bradgrantham/rocinante/notes.md

# User Buttons

For emulation apps, use the button scheme:
* Button 1 prints some help
* Button 2 kicks on the menu (and then buttons 1,2,3 navigate the menu?)
* Button 3 quits
