bradgrantham/rocinante/docs.md

User's guide
    can call newlib newlib-like functions, e.g.
        malloc, free
        printf, getchar, putchar
        fopen, fclose
    Window/Video calls
    Textport calls
    Audio calls
    Joystick calls
    Keyboard input calls
    System Buttons
Reference - generate?  Doxygen?
Device
    Ports
    Flashing
        USB DFU
        ST-Link SWD
        USART2 (over UART header)
