bradgrantham/rocinante/firmware/microray.md

Checkout https://github.com/jaggies/microray

PATH=$PATH:$PATH_TO_ARM_EABI_NONE_BIN_DIRECTORY TARGET=ARM jam

Uncomment the MICRORAY variables in Makefile and change to point to microray's source root
