bradgrantham/rocinante/(threads)

Thread 1 (2020-11-17):

Composite out is designed incorrectly

bradgrantham, 2020-11-17:
Transferred design from proto incorrectly.   Circuit has error - ground should be common and cap from signal to ground, but circuit as built has only cap from shell to ground.  Fixed in KiCAD at master 06fe009

Thread 5 (2022-10-19):

rowhandler should increment frame and reset row number when SetFuncs is called

bradgrantham, 2022-10-19:
Otherwise could have a race where interlaced is set to false but rows continue from 263 to 524, potentially confusing or crashing the line functions

Closed 2022-10-23.
