bradgrantham/rocinante/kicad/rocinante1/rocinante1.kicad_pcb

## KiCad design kicad/rocinante1/rocinante1.kicad_pcb (2020-11-17)

Schematic: rocinante1.sch, Rocinante, the noble steed

Parts:
BT1: 1225; BatteryHolder_Keystone_3001_1x12mm; Manufacturer PN 3001
C1, C2, C4, C6, C7, C8, C9, C10, C11, C12, C13, C14, C15, C16, C17, C21, C22, C23, C24, C28, C31, C32: 100nF; C_0603_1608Metric
C3, C5: 2.2µF; C_0603_1608Metric
C18, C19: 70nF; C_0603_1608Metric
C20: 1nF; C_0603_1608Metric
C25, C26, C27: 10µF; C_0603_1608Metric
C29, C30: 5.1pF; C_0603_1608Metric
C33, C35, C36: 1µF; C_0603_1608Metric
C34: 4.7µF; C_0603_1608Metric
D1: POWERLED; LED_0603_1608Metric; Manufacturer PN 150060GS75000
D2: DEBUGLED; LED_0603_1608Metric; Manufacturer PN 150060RS75000
D4: RGBLED1; LED_WS2812B_PLCC4_5.0x5.0mm_P3.2mm; Manufacturer PN WS2812B
D5: RGBLED2; LED_WS2812B_PLCC4_5.0x5.0mm_P3.2mm; Manufacturer PN WS2812B
D6: RGBLED3; LED_WS2812B_PLCC4_5.0x5.0mm_P3.2mm; Manufacturer PN WS2812B
F1: F_Small; Fuse_1210_3225Metric; Manufacturer PN 0ZCH0050FF2G
H1: HOLE0; MountingHole_3.2mm_M3_Pad_Via
H2: HOLE1; MountingHole_3.2mm_M3_Pad_Via
H3: HOLE2; MountingHole_3.2mm_M3_Pad_Via
H4: HOLE3; MountingHole_3.2mm_M3_Pad_Via
J1: ESP_01; PinSocket_2x04_P2.54mm_Vertical
J2: SWD; PinHeader_2x05_P1.27mm_Vertical_SMD; Manufacturer PN 20021521-00010C1LF
J3: COMPOSITE; CUI_RCJ-044; Manufacturer PN RCJ-044
J4: CTRL1; DSUB-9_Male_Horizontal_P2.77x2.84mm_EdgePinOffset7.70mm_Hou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; Manufacturer PN A-DS 09 A/KG-T2S
J5: CTRL2; DSUB-9_Male_Horizontal_P2.77x2.84mm_EdgePinOffset7.70mm_Hou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; Manufacturer PN A-DS 09 A/KG-T2S
J6: VGA; HD15-SN-24; Manufacturer PN HD15-SN-24
J7: AUDIOIN; Jack_3.5mm_CUI_SJ1-3535NG_Horizontal
J8: AUDIOOUT; Jack_3.5mm_CUI_SJ1-3535NG_Horizontal
J9: MOUSE; CUI_MD-60SM
J10: KEYBOARD; CUI_MD-60SM
J11: SERIAL; PinHeader_1x06_P2.54mm_Vertical
J12: SD_Card; 10067847-001RLF; Manufacturer PN 10067847-001RLF
J13: USBFS/POWER; USB_Micro-B_Amphenol_10104110_Horizontal; Manufacturer PN 10104110-0001LF
J14: I2S; PinHeader_1x06_P2.54mm_Vertical
J15: NEOPIXEL; PinHeader_1x03_P2.54mm_Vertical
J16: EXPHDR; PinHeader_2x05_P2.54mm_Vertical
Q1: Q_NPN_CBE; SOT-323_SC-70; Manufacturer PN MMBT3904WT1G
R1, R4: 220; R_0603_1608Metric
R2, R20, R28, R34: 2.2k; R_0603_1608Metric
R3: 6.8k; R_0603_1608Metric
R5: 215; R_0603_1608Metric
R6: 430; R_0603_1608Metric
R7: 860; R_0603_1608Metric
R8: 1.7k; R_0603_1608Metric
R9: 3.4k; R_0603_1608Metric
R10: 6.9k; R_0603_1608Metric
R11: 14k; R_0603_1608Metric
R12: 28K; R_0603_1608Metric
R13: 47; R_0603_1608Metric
R14, R15, R16, R21, R36, R37, R38, R39: 10K; R_0603_1608Metric
R17, R25, R31: 270; R_0603_1608Metric
R18, R26, R32: 560; R_0603_1608Metric
R19, R27, R33: 1100; R_0603_1608Metric
R22, R23, R43, R44, R45, R46, R47, R48: 20K; R_0603_1608Metric
R24, R29, R35: 4.3k; R_0603_1608Metric
R30: 8.6k; R_0603_1608Metric
R40, R41, R42: 150; R_0603_1608Metric
R49, R50, R51, R52, R53, R54: 68K; R_0603_1608Metric
R55, R56, R57, R58, R59, R60: 22; R_0603_1608Metric
R61, R62: 0; R_0603_1608Metric
SW1: RESET; SW_Push_1P1T_NO_6x6mm_H9.5mm; Manufacturer PN PTS645SM70SMTR92
SW2: USER1; SW_Push_1P1T_NO_6x6mm_H9.5mm; Manufacturer PN PTS645SM70SMTR92
SW3: USER2; SW_Push_1P1T_NO_6x6mm_H9.5mm; Manufacturer PN PTS645SM70SMTR92
SW4: USER3; SW_Push_1P1T_NO_6x6mm_H9.5mm; Manufacturer PN PTS645SM70SMTR92
SW5: BOOT0; SW_Push_1P1T_NO_6x6mm_H9.5mm; Manufacturer PN PTS645SM70SMTR92
TP1: CPST; TestPoint_Keystone_5015_Micro-Minature; Manufacturer PN RCW-0C
TP2: 5V; TestPoint_Keystone_5015_Micro-Minature; Manufacturer PN RCW-0C
TP3: 3V3; TestPoint_Keystone_5015_Micro-Minature; Manufacturer PN RCW-0C
TP4: GND; TestPoint_Keystone_5015_Micro-Minature; Manufacturer PN RCW-0C
TP5: KBDDATA; TestPoint_Keystone_5015_Micro-Minature; Manufacturer PN RCW-0C
TP6: KBDCLK; TestPoint_Keystone_5015_Micro-Minature; Manufacturer PN RCW-0C
U1: STM32H743IITx; LQFP-176_24x24mm_P0.5mm; Manufacturer PN STM32H743IIT6
U2: W9812G6KH-6; TSOP-II-54_22.2x10.16mm_P0.8mm; Manufacturer PN W9812G6KH-6
U3: LD1117S33TR_SOT223; SOT-223-3_TabPin2; Manufacturer PN LD1117S33TR
X1: ASE-14.31818MHz; Oscillator_SMD_Abracon_ASE-4Pin_3.2x2.5mm; Manufacturer PN ASEMB-14.31818MHZ-XY-T
Y1: 25MHz; Crystal_SMD_2016-4Pin_2.0x1.6mm; Manufacturer PN NX2016SA-25MHZ-EXS00A-CS11321

Connections:
ADC1_INP3: J7.T, U1.52
ADC1_INP5: J7.R, U1.57
ADC3_INP2: J4.9, U1.27
ADC3_INP3: J4.5, U1.25
ADC3_INP6: J5.9, U1.28
ADC3_INP7: J5.5, U1.26
AUDIO_OUT_L: C23.1, J8.T, R43.1
AUDIO_OUT_R: C24.1, J8.R, R44.1
BAT: BT1.1, C36.2, U1.6
BOOT: R21.1, SW5.2, U1.166
CLOCK0: R62.2, U1.29
CLOCK1: R61.2, U1.30
CV0: R12.2, U1.131
CV1: R11.2, U1.132
CV2: R10.2, U1.133
CV3: R9.2, U1.134
CV4: R8.2, U1.173
CV5: R7.2, U1.174
CV6: R6.2, U1.175
CV7: R5.2, U1.176
DAC1_OUT1: R22.2, U1.50
DAC1_OUT2: R23.2, U1.51
DEBUG: R4.1, U1.4
E1: J4.4, U1.86
E2: J5.4, U1.130
ESP_CH_EN: J1.4, U1.111
ESP_GPIO0: J1.5, R14.1
ESP_GPIO2: J1.3, R15.1
ESP_RST: J1.6, U1.110
ESP_RX: J1.7, U1.168
ESP_TX: J1.2, U1.11
EXPGPIO0: J16.8, U1.144
EXPGPIO1: J16.9, U1.145
EXPPWM: J16.7, U1.24
FIRE1: J4.6, U1.12
FIRE2: J5.6, U1.13
GND: BT1.2, C1.2, C2.2, C3.2, C4.2, C5.2, C6.2, C7.2, C8.2, C9.2, C10.2, C11.2, C12.2, C13.2, C14.2, C15.2, C16.2, C17.2, C18.2, C19.2, C20.2, C21.1, C22.1, C25.2, C26.2, C27.2, C28.1, C29.1, C30.1, C31.2, C32.1, C33.1, C34.2, C35.1, C36.1, D1.1 (K), D2.1 (K), D4.3, D5.3, D6.3, H1.1, H2.1, H3.1, H4.1, J1.1, J2.3, J2.5, J2.9, J4.0 (PAD), J5.0 (PAD), J6.0, J6.5, J6.6, J6.7, J6.8, J6.10, J7.S, J8.S, J9.3, J9.S1, J9.S2, J9.S3, J10.3, J10.S1, J10.S2, J10.S3, J11.6, J12.3, J12.6, J12.12, J12.13, J13.4, J13.5, J13.6, J14.6, J15.3, J16.6, R21.2, R40.1, R41.1, R42.1, R43.2, R44.2, SW1.1, TP4.1, U1.14, U1.22, U1.37, U1.48, U1.61, U1.71, U1.90, U1.102, U1.113, U1.126, U1.135, U1.148, U1.158, U2.6, U2.12, U2.28, U2.41, U2.46, U2.52, U2.54, U3.1, X1.2
I2C1_SCL: J6.15, U1.167
I2C1_SDA: J6.12, U1.165
I2S1_SDO: J14.3, U1.53
I2S_CK: J14.5, U1.154
I2S_SDI: J14.2, U1.152
I2S_WS: J14.4, U1.153
JOYSELECT: J4.7, J5.7, U1.58
KBD_CLK: J10.5, R38.1, R45.1, TP6.1
KBD_DATA: J10.1, R36.1, R46.1, TP5.1
KEYSELECT: J4.8, J5.8, U1.93
MOUSE_CLK: J9.5, R16.1, R47.1
MOUSE_DATA: J9.1, R37.1, R48.1
N1: J4.1, U1.83
N2: J5.1, U1.89
NRST: J2.10, SW1.2, U1.31
unnamed: C3.1, U1.125
unnamed: C5.1, U1.81
unnamed: C21.2, C23.2, R22.1
unnamed: C22.2, C24.2, R23.1
unnamed: C29.2, R61.1, Y1.1
unnamed: C30.2, R62.1, Y1.2
unnamed: D1.2 (A), R1.2
unnamed: D2.2 (A), R4.2
unnamed: D4.2, D5.4
unnamed: D4.4, Q1.1, R3.1
unnamed: D5.2, D6.4
unnamed: D6.2, J15.2
unnamed: F1.1, J13.1
unnamed: J12.1, R56.1
unnamed: J12.2, R57.1
unnamed: J12.5, R58.1
unnamed: J12.7, R59.1
unnamed: J12.8, R60.1
unnamed: J12.9, R55.1
unnamed: Q1.2, R2.1
unnamed: R39.1, X1.1
RGBLED_PWM: Q1.3, U1.5, U1.101
S1: J4.2, U1.84
S2: J5.2, U1.128
SDIO_CD: J12.10, U1.106
SDIO_CLK: R52.1, R58.2, U1.150
SDIO_CMD: R51.1, R57.2, U1.151
SDIO_D0: R53.1, R59.2, U1.94
SDIO_D1: R54.1, R60.2, U1.95
SDIO_D2: R49.1, R55.2, U1.161
SDIO_D3: R50.1, R56.2, U1.162
SDIO_WP: J12.11, U1.56
SDRAM_A0: U1.16, U2.23
SDRAM_A1: U1.17, U2.24
SDRAM_A2: U1.18, U2.25
SDRAM_A3: U1.19, U2.26
SDRAM_A4: U1.20, U2.29
SDRAM_A5: U1.21, U2.30
SDRAM_A6: U1.60, U2.31
SDRAM_A7: U1.63, U2.32
SDRAM_A8: U1.64, U2.33
SDRAM_A9: U1.65, U2.34
SDRAM_A10: U1.66, U2.22
SDRAM_A11: U1.67, U2.35
SDRAM_BA0: U1.108, U2.20
SDRAM_BA1: U1.109, U2.21
SDRAM_D0: U1.104, U2.2
SDRAM_D1: U1.105, U2.4
SDRAM_D2: U1.142, U2.5
SDRAM_D3: U1.143, U2.7
SDRAM_D4: U1.68, U2.8
SDRAM_D5: U1.69, U2.10
SDRAM_D6: U1.70, U2.11
SDRAM_D7: U1.73, U2.13
SDRAM_D8: U1.74, U2.42
SDRAM_D9: U1.75, U2.44
SDRAM_D10: U1.76, U2.45
SDRAM_D11: U1.77, U2.47
SDRAM_D12: U1.78, U2.48
SDRAM_D13: U1.96, U2.50
SDRAM_D14: U1.97, U2.51
SDRAM_D15: U1.98, U2.53
SDRAM_NBL0: U1.169, U2.15
SDRAM_NBL1: U1.170, U2.39
SDRAM_SDCKE0: U1.43, U2.37
SDRAM_SDCLK: U1.112, U2.38
SDRAM_SDNCAS: U1.160, U2.17
SDRAM_SDNE0: U1.44, U2.19
SDRAM_SDNRAS: U1.59, U2.18
SDRAM_SDNWE: U1.46, U2.16
SPI6_MISO: J16.1, U1.155
SPI6_MOSI: J16.4, U1.157
SPI6_NSS_SWCTL: J16.5, U1.107
SPI6_SCK: J16.3, U1.156
SWCLK: J2.4, U1.137
SWDIO: J2.2, U1.124
TIM1_CH2: U1.120, X1.3
TIM2_CH1: R45.2, U1.119, U1.138
TIM3_CH2: R47.2, U1.92, U1.163
TIM4_CH1: J6.13, U1.100
TIM5_CH2: J6.14, U1.88
USART1_RX: R46.2, U1.121, U1.164
USART2_CTS: J11.5, U1.40
USART2_RTS: U1.41
USART2_RX: J11.3, U1.47
USART2_TX: J11.2, U1.42
USART3_RX: R48.2, U1.79, U1.80
USB_FS_D_N: J13.2, U1.122
USB_FS_D_P: J13.3, U1.123
USER1: SW2.2, U1.1
USER2: SW3.2, U1.2
USER3: SW4.2, U1.3
VDD: C1.1, C2.1, C4.1, C6.1, C7.1, C8.1, C9.1, C10.1, C11.1, C12.1, C13.1, C14.1, C15.1, C16.1, C17.1, C18.1, C19.1, C25.1, C27.1, C31.1, C34.1, C35.2, J1.8, J2.1, J12.4, J14.1, J16.2, R1.1, R2.2, R13.1, R14.2, R15.2, R39.2, R49.2, R50.2, R51.2, R52.2, R53.2, R54.2, SW2.1, SW3.1, SW4.1, SW5.1, TP3.1, U1.15, U1.23, U1.36, U1.39, U1.49, U1.62, U1.72, U1.82, U1.91, U1.103, U1.114, U1.127, U1.136, U1.149, U1.159, U1.171, U1.172, U2.1, U2.3, U2.9, U2.14, U2.27, U2.43, U2.49, U3.2, X1.4
VGA_B0: R24.2, U1.32
VGA_B1: R20.2, U1.33
VGA_B2: R19.2, U1.34
VGA_B3: R18.2, U1.35
VGA_B4: R17.2, U1.54
VGA_BLUE: J6.3, R17.1, R18.1, R19.1, R20.1, R24.1, R40.2
VGA_G0: R30.2, U1.55
VGA_G1: R29.2, U1.115
VGA_G2: R28.2, U1.116
VGA_G3: R27.2, U1.117
VGA_G4: R26.2, U1.118
VGA_G5: R25.2, U1.139
VGA_GREEN: J6.2, R25.1, R26.1, R27.1, R28.1, R29.1, R30.1, R41.2
VGA_ID0: J6.11
VGA_ID2: J6.4
VGA_R0: R35.2, U1.140
VGA_R1: R34.2, U1.141
VGA_R2: R33.2, U1.8
VGA_R3: R32.2, U1.9
VGA_R4: R31.2, U1.10
VGA_RED: J6.1, R31.1, R32.1, R33.1, R34.1, R35.1, R42.2
VREFP: C32.2, C33.2, R13.2, U1.38
W1: J4.3, U1.85
W2: J5.3, U1.129

Notes on the sheet:
Compatible with Jim’s SPI header on pins 1-6
VDD DECOUPLING

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
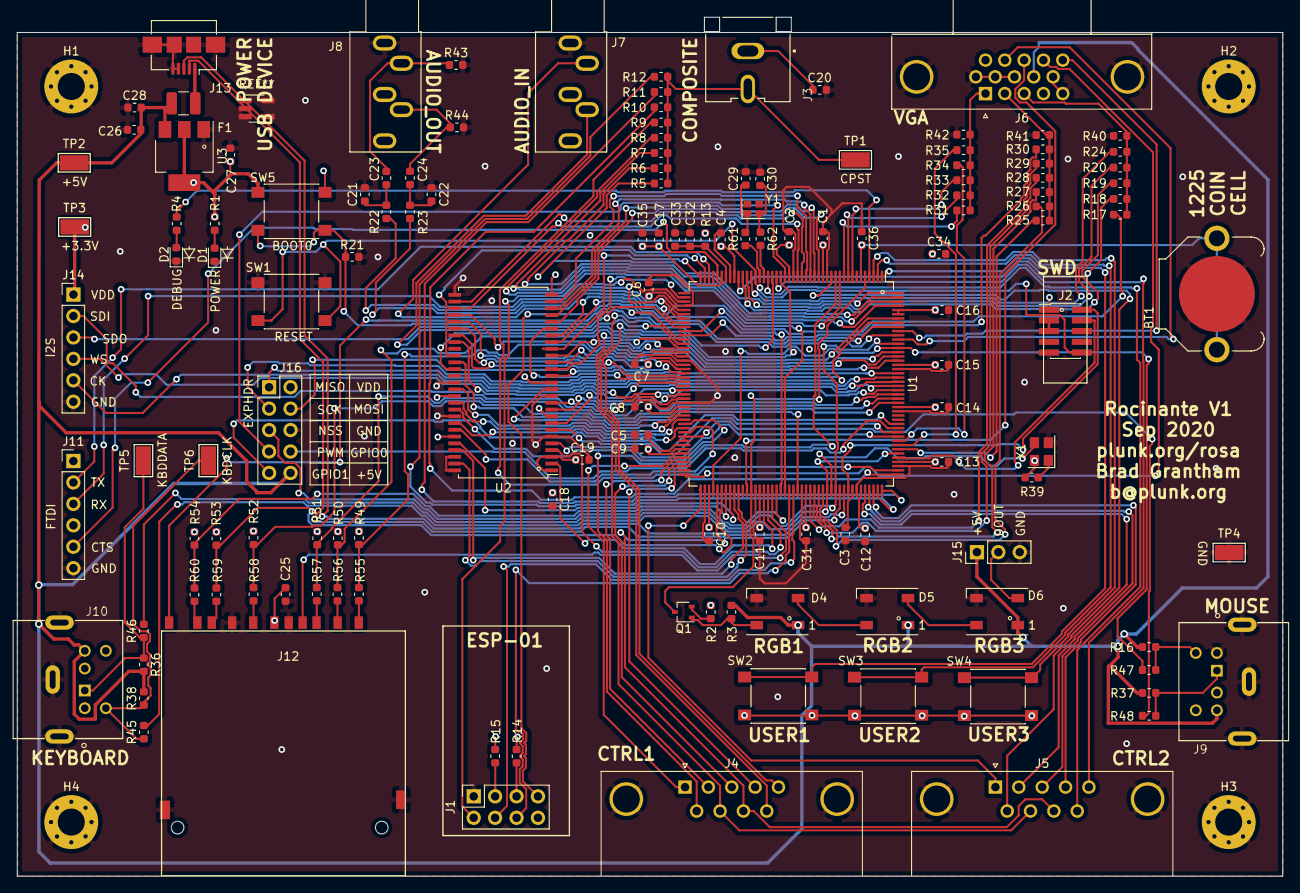
[picture p5: board rocinante1.kicad_pcb from above]

Board: 4 copper layers, 150.0 x 101.8 mm, 142 parts (0 on the bottom side), 169 nets.
