bradgrantham/rocinante/software/rocinante_rev1.ioc

Mcu.UserName=STM32H743IITx
PA11.Signal=USB_OTG_FS_DM
PA12.Signal=USB_OTG_FS_DP
PA2.Signal=USART2_TX
PA3.Signal=USART2_RX
PA4.Signal=COMP_DAC11_group
PA5.Signal=COMP_DAC12_group
PA9.Signal=S_TIM1_CH2
PB14.Signal=SDMMC2_D0
PB15.Signal=SDMMC2_D1
PB9.Signal=UART4_TX
PC0.Signal=GPIO_Output
PC1.Signal=GPIO_Output
PC10.Signal=GPIO_Output
PC11.Signal=GPIO_Output
PC12.Signal=GPIO_Output
PC13.Signal=GPIO_Output
PC2_C.Signal=GPIO_Output
PC3_C.Signal=GPIO_Output
PC4.Signal=GPIO_Output
PC5.Signal=GPIO_Output
PC6.Signal=GPIO_Output
PC7.Signal=GPIO_Output
PC8.Signal=GPIO_Output
PC9.Signal=GPIO_Output
PD0.Signal=FMC_D2_DA2
PD1.Signal=FMC_D3_DA3
PD10.Signal=FMC_D15_DA15
PD12.Signal=S_TIM4_CH1
PD14.Signal=FMC_D0_DA0
PD15.Signal=FMC_D1_DA1
PD6.Signal=SDMMC2_CK
PD7.Signal=SDMMC2_CMD
PD8.Signal=FMC_D13_DA13
PD9.Signal=FMC_D14_DA14
PE0.Signal=FMC_NBL0
PE1.Signal=FMC_NBL1
PE10.Signal=FMC_D7_DA7
PE11.Signal=FMC_D8_DA8
PE12.Signal=FMC_D9_DA9
PE13.Signal=FMC_D10_DA10
PE14.Signal=FMC_D11_DA11
PE15.Signal=FMC_D12_DA12
PE2.Signal=SPI4_SCK
PE3.GPIO_Label=USER2
PE3.Signal=GPIO_Input
PE4.GPIO_Label=USER3
PE4.Signal=GPIO_Input
PE5.GPIO_Label=DEBUG_LED
PE5.Signal=GPIO_Output
PE6.GPIO_Label=RGBLED_SPI
PE6.Signal=SPI4_MOSI
PE7.Signal=FMC_D4_DA4
PE8.Signal=FMC_D5_DA5
PE9.Signal=FMC_D6_DA6
PF0.Signal=FMC_A0
PF1.Signal=FMC_A1
PF11.Signal=FMC_SDNRAS
PF12.Signal=FMC_A6
PF13.Signal=FMC_A7
PF14.Signal=FMC_A8
PF15.Signal=FMC_A9
PF2.Signal=FMC_A2
PF3.Signal=FMC_A3
PF4.Signal=FMC_A4
PF5.Signal=FMC_A5
PG0.Signal=FMC_A10
PG1.Signal=FMC_A11
PG15.Signal=FMC_SDNCAS
PG2.GPIO_Label=SDIO_CD
PG2.Signal=GPIO_Input
PG4.Signal=FMC_A14_BA0
PG5.Signal=FMC_A15_BA1
PG6.GPIO_Label=ESP_RESET
PG6.Signal=GPIO_Output
PG7.GPIO_Label=ESP_EN
PG7.Signal=GPIO_Output
PG8.Signal=FMC_SDCLK
PH11.Signal=S_TIM5_CH2
PH2.Signal=FMC_SDCKE0
PH3.Signal=FMC_SDNE0
PH5.Signal=FMC_SDNWE
PI0.Signal=GPIO_Output
PI1.Signal=GPIO_Output
PI2.Signal=GPIO_Output
PI3.Signal=GPIO_Output
PI4.Signal=GPIO_Output
PI5.Signal=GPIO_Output
PI6.Signal=GPIO_Output
PI7.Signal=GPIO_Output
PI9.Signal=UART4_RX
