bradgrantham/rocinante/firmware/main.c

#include <stdio.h>
#include <stdlib.h>
#include <string.h>
#include <ctype.h>
#include <math.h>

#undef USE_PS2KBD

#include <stm32f7xx_hal.h>

#include "ff.h"

#include "defs.h"
#include "delay.h"
#include "leds.h"
#include "byte_queue.h"
#include "gpio_helpers.h"
#include "utility.h"
#include "crc7.h"
#include "logprintf.h"

#include "monitor_queue.h"
#include "console_queue.h"
#include "uart.h"
#include "sd_spi.h"
#include "keyboard.h"
#include "reset_button.h"

// System APIs
#include "videomode.h"
#include "graphics.h"
#include "textport.h"
#include "rocinante.h"
#include "segment_utility.h"

// System driver internal definitions
#include "videomodeinternal.h"

static int gDumpKeyboardData = 0;

char gMonitorCommandBuffer[80];
unsigned char gMonitorCommandBufferLength = 0;

#define IOBOARD_FIRMWARE_VERSION_STRING XSTR(IOBOARD_FIRMWARE_VERSION)

volatile unsigned char gSerialInputToMonitor = 1;

void panic_worse()
{
    LED_set_panic(1);
    for(;;);
}

void panic(void)
{
    static int entered = 0;

    LED_set_panic(1);

    int pin = 0;
    for(;;) {
        if(!entered) {
            // SERIAL_flush() can itself panic(), so stop reentry here
            entered = 1;
            SERIAL_flush();
            entered = 0;
        }

        LED_set_panic(pin);
        pin = pin ? 0 : 1;
        delay_ms(100);
    }
}

void FPU_IRQHandler(void)
{
    SERIAL_enqueue_one_char('f');
    SERIAL_enqueue_one_char('p');
    SERIAL_enqueue_one_char('u');
    SERIAL_enqueue_one_char('\n');
    SERIAL_flush();
    panic();
}

//----------------------------------------------------------------------------
// System Initialization Goop

typedef struct {
    float CPUMHz;      // not used; computed
    uint32_t HSOSC;       // not used; fixed
    uint32_t PLL_M;
    uint32_t PLL_N;
    uint32_t PLL_P;
    uint32_t DMA_TIM_CLOCKS;
    uint32_t HCLK_DIV;
    uint32_t APB1_DIV;
    uint32_t APB2_DIV;
    float colorburstClock;      // not used; computed
    float error;      // not used; computed
} ClockConfiguration;

unsigned int whichConfig = 0;
static const ClockConfiguration clockConfigs[] =
{
    // Base mode we know works?
    // { 229.14, 8000000, 7, 401, 2, 8, RCC_SYSCLK_DIV1, RCC_HCLK_DIV8, RCC_HCLK_DIV4, 3.580357, 0.000227 }, // can't get SD to lock in
    { 200.50, 8000000, 4, 401, 4, 7, RCC_SYSCLK_DIV1, RCC_HCLK_DIV8, RCC_HCLK_DIV4, 3.580357, 0.000227},
    // {200.47, 16000000, 17, 426, 2, 14, RCC_SYSCLK_DIV1, RCC_HCLK_DIV4, RCC_HCLK_DIV2, 3.579832, 0.000080}, // 415 normal mode

    // PLL_OUTPUT MHz, HSE, PLLM, PLLN, PLLP, TIM_CLOCKS, HCLK_DIV, APB1_DIV, APB2_DIV, actual color clock MHz, error
    { 286.40, 8000000, 5, 358, 2, 10, RCC_SYSCLK_DIV1, RCC_HCLK_DIV8, RCC_HCLK_DIV4, 3.580000, 0.000127 },
    { 200.50, 8000000, 2, 401, 8, 14, RCC_SYSCLK_DIV1, RCC_HCLK_DIV4, RCC_HCLK_DIV2, 3.580357, 0.000227 },
    { 200.50, 8000000, 4, 401, 4, 14, RCC_SYSCLK_DIV1, RCC_HCLK_DIV4, RCC_HCLK_DIV2, 3.580357, 0.000227 },
    { 200.50, 8000000, 8, 401, 2, 14, RCC_SYSCLK_DIV1, RCC_HCLK_DIV4, RCC_HCLK_DIV2, 3.580357, 0.000227 },
    { 229.14, 8000000, 7, 401, 2, 8, RCC_SYSCLK_DIV1, RCC_HCLK_DIV8, RCC_HCLK_DIV4, 3.580357, 0.000227 },
    { 229.00, 8000000, 2, 229, 4, 8, RCC_SYSCLK_DIV1, RCC_HCLK_DIV8, RCC_HCLK_DIV4, 3.578125, -0.000397 },
    { 229.00, 8000000, 4, 229, 2, 8, RCC_SYSCLK_DIV1, RCC_HCLK_DIV8, RCC_HCLK_DIV4, 3.578125, -0.000397 },
    { 186.22, 8000000, 3, 419, 6, 13, RCC_SYSCLK_DIV1, RCC_HCLK_DIV4, RCC_HCLK_DIV2, 3.581197, 0.000461 },
    { 186.22, 8000000, 9, 419, 2, 13, RCC_SYSCLK_DIV1, RCC_HCLK_DIV4, RCC_HCLK_DIV2, 3.581197, 0.000461 },
    { 257.60, 8000000, 5, 322, 2, 9, RCC_SYSCLK_DIV1, RCC_HCLK_DIV8, RCC_HCLK_DIV4, 3.577778, -0.000494 },
    { 200.57, 8000000, 7, 351, 2, 14, RCC_SYSCLK_DIV1, RCC_HCLK_DIV4, RCC_HCLK_DIV2, 3.581633, 0.000583 },
    { 186.00, 8000000, 2, 93, 2, 13, RCC_SYSCLK_DIV1, RCC_HCLK_DIV4, RCC_HCLK_DIV2, 3.576923, -0.000732 },
    { 186.00, 8000000, 2, 186, 4, 13, RCC_SYSCLK_DIV1, RCC_HCLK_DIV4, RCC_HCLK_DIV2, 3.576923, -0.000732 },
    { 186.00, 8000000, 2, 279, 6, 13, RCC_SYSCLK_DIV1, RCC_HCLK_DIV4, RCC_HCLK_DIV2, 3.576923, -0.000732 },
    { 186.00, 8000000, 2, 372, 8, 13, RCC_SYSCLK_DIV1, RCC_HCLK_DIV4, RCC_HCLK_DIV2, 3.576923, -0.000732 },
    { 186.00, 8000000, 3, 279, 4, 13, RCC_SYSCLK_DIV1, RCC_HCLK_DIV4, RCC_HCLK_DIV2, 3.576923, -0.000732 },
    { 186.00, 8000000, 4, 186, 2, 13, RCC_SYSCLK_DIV1, RCC_HCLK_DIV4, RCC_HCLK_DIV2, 3.576923, -0.000732 },
    { 186.00, 8000000, 4, 372, 4, 13, RCC_SYSCLK_DIV1, RCC_HCLK_DIV4, RCC_HCLK_DIV2, 3.576923, -0.000732 },
    { 186.00, 8000000, 6, 279, 2, 13, RCC_SYSCLK_DIV1, RCC_HCLK_DIV4, RCC_HCLK_DIV2, 3.576923, -0.000732 },
    { 186.00, 8000000, 8, 372, 2, 13, RCC_SYSCLK_DIV1, RCC_HCLK_DIV4, RCC_HCLK_DIV2, 3.576923, -0.000732 },
    { 186.29, 8000000, 7, 326, 2, 13, RCC_SYSCLK_DIV1, RCC_HCLK_DIV4, RCC_HCLK_DIV2, 3.582418, 0.000802 },
    { 200.67, 8000000, 2, 301, 6, 14, RCC_SYSCLK_DIV1, RCC_HCLK_DIV4, RCC_HCLK_DIV2, 3.583333, 0.001058 },
    { 229.33, 8000000, 3, 172, 2, 8, RCC_SYSCLK_DIV1, RCC_HCLK_DIV8, RCC_HCLK_DIV4, 3.583333, 0.001058 },
    { 286.67, 8000000, 3, 215, 2, 10, RCC_SYSCLK_DIV1, RCC_HCLK_DIV8, RCC_HCLK_DIV4, 3.583333, 0.001058 },
    { 200.67, 8000000, 3, 301, 4, 14, RCC_SYSCLK_DIV1, RCC_HCLK_DIV4, RCC_HCLK_DIV2, 3.583333, 0.001058 },
    { 229.33, 8000000, 3, 344, 4, 8, RCC_SYSCLK_DIV1, RCC_HCLK_DIV8, RCC_HCLK_DIV4, 3.583333, 0.001058 },
    { 258.00, 8000000, 3, 387, 4, 9, RCC_SYSCLK_DIV1, RCC_HCLK_DIV8, RCC_HCLK_DIV4, 3.583333, 0.001058 },
    { 286.67, 8000000, 3, 430, 4, 10, RCC_SYSCLK_DIV1, RCC_HCLK_DIV8, RCC_HCLK_DIV4, 3.583333, 0.001058 },
    { 200.67, 8000000, 6, 301, 2, 14, RCC_SYSCLK_DIV1, RCC_HCLK_DIV4, RCC_HCLK_DIV2, 3.583333, 0.001058 },
    { 229.33, 8000000, 6, 344, 2, 8, RCC_SYSCLK_DIV1, RCC_HCLK_DIV8, RCC_HCLK_DIV4, 3.583333, 0.001058 },
    { 258.00, 8000000, 6, 387, 2, 9, RCC_SYSCLK_DIV1, RCC_HCLK_DIV8, RCC_HCLK_DIV4, 3.583333, 0.001058 },
    { 286.67, 8000000, 6, 430, 2, 10, RCC_SYSCLK_DIV1, RCC_HCLK_DIV8, RCC_HCLK_DIV4, 3.583333, 0.001058 },
    { 258.00, 8000000, 2, 129, 2, 9, RCC_SYSCLK_DIV1, RCC_HCLK_DIV8, RCC_HCLK_DIV4, 3.583333, 0.001058 },
    { 258.00, 8000000, 2, 258, 4, 9, RCC_SYSCLK_DIV1, RCC_HCLK_DIV8, RCC_HCLK_DIV4, 3.583333, 0.001058 },
    { 229.33, 8000000, 2, 344, 6, 8, RCC_SYSCLK_DIV1, RCC_HCLK_DIV8, RCC_HCLK_DIV4, 3.583333, 0.001058 },
    { 258.00, 8000000, 2, 387, 6, 9, RCC_SYSCLK_DIV1, RCC_HCLK_DIV8, RCC_HCLK_DIV4, 3.583333, 0.001058 },
    { 286.67, 8000000, 2, 430, 6, 10, RCC_SYSCLK_DIV1, RCC_HCLK_DIV8, RCC_HCLK_DIV4, 3.583333, 0.001058 },
    { 258.00, 8000000, 4, 258, 2, 9, RCC_SYSCLK_DIV1, RCC_HCLK_DIV8, RCC_HCLK_DIV4, 3.583333, 0.001058 },
    { 286.00, 8000000, 2, 143, 2, 10, RCC_SYSCLK_DIV1, RCC_HCLK_DIV8, RCC_HCLK_DIV4, 3.575000, -0.001270 },
    { 286.00, 8000000, 2, 286, 4, 10, RCC_SYSCLK_DIV1, RCC_HCLK_DIV8, RCC_HCLK_DIV4, 3.575000, -0.001270 },
    { 286.00, 8000000, 2, 429, 6, 10, RCC_SYSCLK_DIV1, RCC_HCLK_DIV8, RCC_HCLK_DIV4, 3.575000, -0.001270 },
    { 286.00, 8000000, 3, 429, 4, 10, RCC_SYSCLK_DIV1, RCC_HCLK_DIV8, RCC_HCLK_DIV4, 3.575000, -0.001270 },
    { 286.00, 8000000, 4, 286, 2, 10, RCC_SYSCLK_DIV1, RCC_HCLK_DIV8, RCC_HCLK_DIV4, 3.575000, -0.001270 },
    { 228.80, 8000000, 5, 286, 2, 8, RCC_SYSCLK_DIV1, RCC_HCLK_DIV8, RCC_HCLK_DIV4, 3.575000, -0.001270 },
    { 286.00, 8000000, 6, 429, 2, 10, RCC_SYSCLK_DIV1, RCC_HCLK_DIV8, RCC_HCLK_DIV4, 3.575000, -0.001270 },
    { 186.40, 8000000, 5, 233, 2, 13, RCC_SYSCLK_DIV1, RCC_HCLK_DIV4, RCC_HCLK_DIV2, 3.584615, 0.001416 },
    { 257.33, 8000000, 2, 386, 6, 9, RCC_SYSCLK_DIV1, RCC_HCLK_DIV8, RCC_HCLK_DIV4, 3.574074, -0.001528 },
    { 257.33, 8000000, 3, 193, 2, 9, RCC_SYSCLK_DIV1, RCC_HCLK_DIV8, RCC_HCLK_DIV4, 3.574074, -0.001528 },
    { 257.33, 8000000, 3, 386, 4, 9, RCC_SYSCLK_DIV1, RCC_HCLK_DIV8, RCC_HCLK_DIV4, 3.574074, -0.001528 },
    { 257.33, 8000000, 6, 386, 2, 9, RCC_SYSCLK_DIV1, RCC_HCLK_DIV8, RCC_HCLK_DIV4, 3.574074, -0.001528 },
    { 200.80, 8000000, 5, 251, 2, 14, RCC_SYSCLK_DIV1, RCC_HCLK_DIV4, RCC_HCLK_DIV2, 3.585714, 0.001723 },
    { 228.67, 8000000, 2, 343, 6, 8, RCC_SYSCLK_DIV1, RCC_HCLK_DIV8, RCC_HCLK_DIV4, 3.572917, -0.001852 },
    { 228.67, 8000000, 3, 343, 4, 8, RCC_SYSCLK_DIV1, RCC_HCLK_DIV8, RCC_HCLK_DIV4, 3.572917, -0.001852 },
    { 228.67, 8000000, 6, 343, 2, 8, RCC_SYSCLK_DIV1, RCC_HCLK_DIV8, RCC_HCLK_DIV4, 3.572917, -0.001852 },
    { 185.78, 8000000, 3, 418, 6, 13, RCC_SYSCLK_DIV1, RCC_HCLK_DIV4, RCC_HCLK_DIV2, 3.572650, -0.001926 },
    { 185.78, 8000000, 9, 418, 2, 13, RCC_SYSCLK_DIV1, RCC_HCLK_DIV4, RCC_HCLK_DIV2, 3.572650, -0.001926 },
    { 186.50, 8000000, 2, 373, 8, 13, RCC_SYSCLK_DIV1, RCC_HCLK_DIV4, RCC_HCLK_DIV2, 3.586538, 0.001954 },
    { 186.50, 8000000, 4, 373, 4, 13, RCC_SYSCLK_DIV1, RCC_HCLK_DIV4, RCC_HCLK_DIV2, 3.586538, 0.001954 },
    { 186.50, 8000000, 8, 373, 2, 13, RCC_SYSCLK_DIV1, RCC_HCLK_DIV4, RCC_HCLK_DIV2, 3.586538, 0.001954 },
    { 287.00, 8000000, 2, 287, 4, 10, RCC_SYSCLK_DIV1, RCC_HCLK_DIV8, RCC_HCLK_DIV4, 3.587500, 0.002222 },
    { 287.00, 8000000, 4, 287, 2, 10, RCC_SYSCLK_DIV1, RCC_HCLK_DIV8, RCC_HCLK_DIV4, 3.587500, 0.002222 },
    { 229.60, 8000000, 5, 287, 2, 8, RCC_SYSCLK_DIV1, RCC_HCLK_DIV8, RCC_HCLK_DIV4, 3.587500, 0.002222 },
    { 185.71, 8000000, 7, 325, 2, 13, RCC_SYSCLK_DIV1, RCC_HCLK_DIV4, RCC_HCLK_DIV2, 3.571429, -0.002267 },
    { 200.00, 8000000, 7, 350, 2, 14, RCC_SYSCLK_DIV1, RCC_HCLK_DIV4, RCC_HCLK_DIV2, 3.571429, -0.002267 },
    { 228.57, 8000000, 7, 400, 2, 8, RCC_SYSCLK_DIV1, RCC_HCLK_DIV8, RCC_HCLK_DIV4, 3.571429, -0.002267 },
    { 200.00, 8000000, 2, 100, 2, 14, RCC_SYSCLK_DIV1, RCC_HCLK_DIV4, RCC_HCLK_DIV2, 3.571429, -0.002267 },
    { 200.00, 8000000, 2, 200, 4, 14, RCC_SYSCLK_DIV1, RCC_HCLK_DIV4, RCC_HCLK_DIV2, 3.571429, -0.002267 },
    { 200.00, 8000000, 2, 300, 6, 14, RCC_SYSCLK_DIV1, RCC_HCLK_DIV4, RCC_HCLK_DIV2, 3.571429, -0.002267 },
    { 200.00, 8000000, 2, 400, 8, 14, RCC_SYSCLK_DIV1, RCC_HCLK_DIV4, RCC_HCLK_DIV2, 3.571429, -0.002267 },
    { 200.00, 8000000, 3, 150, 2, 14, RCC_SYSCLK_DIV1, RCC_HCLK_DIV4, RCC_HCLK_DIV2, 3.571429, -0.002267 },
    { 200.00, 8000000, 3, 300, 4, 14, RCC_SYSCLK_DIV1, RCC_HCLK_DIV4, RCC_HCLK_DIV2, 3.571429, -0.002267 },
    { 200.00, 8000000, 4, 200, 2, 14, RCC_SYSCLK_DIV1, RCC_HCLK_DIV4, RCC_HCLK_DIV2, 3.571429, -0.002267 },
    { 200.00, 8000000, 4, 400, 4, 14, RCC_SYSCLK_DIV1, RCC_HCLK_DIV4, RCC_HCLK_DIV2, 3.571429, -0.002267 },
    { 200.00, 8000000, 5, 250, 2, 14, RCC_SYSCLK_DIV1, RCC_HCLK_DIV4, RCC_HCLK_DIV2, 3.571429, -0.002267 },
    { 200.00, 8000000, 6, 300, 2, 14, RCC_SYSCLK_DIV1, RCC_HCLK_DIV4, RCC_HCLK_DIV2, 3.571429, -0.002267 },
    { 200.00, 8000000, 8, 400, 2, 14, RCC_SYSCLK_DIV1, RCC_HCLK_DIV4, RCC_HCLK_DIV2, 3.571429, -0.002267 },
    { 258.40, 8000000, 5, 323, 2, 9, RCC_SYSCLK_DIV1, RCC_HCLK_DIV8, RCC_HCLK_DIV4, 3.588889, 0.002610 },
    { 285.60, 8000000, 5, 357, 2, 10, RCC_SYSCLK_DIV1, RCC_HCLK_DIV8, RCC_HCLK_DIV4, 3.570000, -0.002667 },
    { 201.00, 8000000, 2, 201, 4, 14, RCC_SYSCLK_DIV1, RCC_HCLK_DIV4, RCC_HCLK_DIV2, 3.589286, 0.002721 },
    { 201.00, 8000000, 2, 402, 8, 14, RCC_SYSCLK_DIV1, RCC_HCLK_DIV4, RCC_HCLK_DIV2, 3.589286, 0.002721 },
    { 201.00, 8000000, 4, 201, 2, 14, RCC_SYSCLK_DIV1, RCC_HCLK_DIV4, RCC_HCLK_DIV2, 3.589286, 0.002721 },
    { 201.00, 8000000, 4, 402, 4, 14, RCC_SYSCLK_DIV1, RCC_HCLK_DIV4, RCC_HCLK_DIV2, 3.589286, 0.002721 },
    { 201.00, 8000000, 8, 402, 2, 14, RCC_SYSCLK_DIV1, RCC_HCLK_DIV4, RCC_HCLK_DIV2, 3.589286, 0.002721 },
    { 229.71, 8000000, 7, 402, 2, 8, RCC_SYSCLK_DIV1, RCC_HCLK_DIV8, RCC_HCLK_DIV4, 3.589286, 0.002721 },
    { 257.00, 8000000, 2, 257, 4, 9, RCC_SYSCLK_DIV1, RCC_HCLK_DIV8, RCC_HCLK_DIV4, 3.569444, -0.002822 },
    { 257.00, 8000000, 4, 257, 2, 9, RCC_SYSCLK_DIV1, RCC_HCLK_DIV8, RCC_HCLK_DIV4, 3.569444, -0.002822 },
    { 186.67, 8000000, 2, 280, 6, 13, RCC_SYSCLK_DIV1, RCC_HCLK_DIV4, RCC_HCLK_DIV2, 3.589744, 0.002849 },
    { 186.67, 8000000, 3, 140, 2, 13, RCC_SYSCLK_DIV1, RCC_HCLK_DIV4, RCC_HCLK_DIV2, 3.589744, 0.002849 },
    { 186.67, 8000000, 3, 280, 4, 13, RCC_SYSCLK_DIV1, RCC_HCLK_DIV4, RCC_HCLK_DIV2, 3.589744, 0.002849 },
    { 186.67, 8000000, 3, 420, 6, 13, RCC_SYSCLK_DIV1, RCC_HCLK_DIV4, RCC_HCLK_DIV2, 3.589744, 0.002849 },
    { 186.67, 8000000, 6, 280, 2, 13, RCC_SYSCLK_DIV1, RCC_HCLK_DIV4, RCC_HCLK_DIV2, 3.589744, 0.002849 },
    { 186.67, 8000000, 9, 420, 2, 13, RCC_SYSCLK_DIV1, RCC_HCLK_DIV4, RCC_HCLK_DIV2, 3.589744, 0.002849 },
    { 185.60, 8000000, 5, 232, 2, 13, RCC_SYSCLK_DIV1, RCC_HCLK_DIV4, RCC_HCLK_DIV2, 3.569231, -0.002881 },
    { 287.20, 8000000, 5, 359, 2, 10, RCC_SYSCLK_DIV1, RCC_HCLK_DIV8, RCC_HCLK_DIV4, 3.590000, 0.002921 },
    { 287.33, 8000000, 2, 431, 6, 10, RCC_SYSCLK_DIV1, RCC_HCLK_DIV8, RCC_HCLK_DIV4, 3.591667, 0.003386 },
    { 287.33, 8000000, 3, 431, 4, 10, RCC_SYSCLK_DIV1, RCC_HCLK_DIV8, RCC_HCLK_DIV4, 3.591667, 0.003386 },
    { 287.33, 8000000, 6, 431, 2, 10, RCC_SYSCLK_DIV1, RCC_HCLK_DIV8, RCC_HCLK_DIV4, 3.591667, 0.003386 },
    { 185.50, 8000000, 2, 371, 8, 13, RCC_SYSCLK_DIV1, RCC_HCLK_DIV4, RCC_HCLK_DIV2, 3.567308, -0.003419 },
    { 185.50, 8000000, 4, 371, 4, 13, RCC_SYSCLK_DIV1, RCC_HCLK_DIV4, RCC_HCLK_DIV2, 3.567308, -0.003419 },
    { 185.50, 8000000, 8, 371, 2, 13, RCC_SYSCLK_DIV1, RCC_HCLK_DIV4, RCC_HCLK_DIV2, 3.567308, -0.003419 },
    { 201.14, 8000000, 7, 352, 2, 14, RCC_SYSCLK_DIV1, RCC_HCLK_DIV4, RCC_HCLK_DIV2, 3.591837, 0.003434 },
    { 285.33, 8000000, 2, 428, 6, 10, RCC_SYSCLK_DIV1, RCC_HCLK_DIV8, RCC_HCLK_DIV4, 3.566667, -0.003598 },
    { 285.33, 8000000, 3, 214, 2, 10, RCC_SYSCLK_DIV1, RCC_HCLK_DIV8, RCC_HCLK_DIV4, 3.566667, -0.003598 },
    { 285.33, 8000000, 3, 428, 4, 10, RCC_SYSCLK_DIV1, RCC_HCLK_DIV8, RCC_HCLK_DIV4, 3.566667, -0.003598 },
    { 256.80, 8000000, 5, 321, 2, 9, RCC_SYSCLK_DIV1, RCC_HCLK_DIV8, RCC_HCLK_DIV4, 3.566667, -0.003598 },
    { 285.33, 8000000, 6, 428, 2, 10, RCC_SYSCLK_DIV1, RCC_HCLK_DIV8, RCC_HCLK_DIV4, 3.566667, -0.003598 },
    { 258.67, 8000000, 2, 388, 6, 9, RCC_SYSCLK_DIV1, RCC_HCLK_DIV8, RCC_HCLK_DIV4, 3.592593, 0.003645 },
    { 258.67, 8000000, 3, 194, 2, 9, RCC_SYSCLK_DIV1, RCC_HCLK_DIV8, RCC_HCLK_DIV4, 3.592593, 0.003645 },
    { 258.67, 8000000, 3, 388, 4, 9, RCC_SYSCLK_DIV1, RCC_HCLK_DIV8, RCC_HCLK_DIV4, 3.592593, 0.003645 },
    { 258.67, 8000000, 6, 388, 2, 9, RCC_SYSCLK_DIV1, RCC_HCLK_DIV8, RCC_HCLK_DIV4, 3.592593, 0.003645 },
    { 186.86, 8000000, 7, 327, 2, 13, RCC_SYSCLK_DIV1, RCC_HCLK_DIV4, RCC_HCLK_DIV2, 3.593407, 0.003872 },
    { 230.00, 8000000, 2, 115, 2, 8, RCC_SYSCLK_DIV1, RCC_HCLK_DIV8, RCC_HCLK_DIV4, 3.593750, 0.003968 },
    { 230.00, 8000000, 2, 230, 4, 8, RCC_SYSCLK_DIV1, RCC_HCLK_DIV8, RCC_HCLK_DIV4, 3.593750, 0.003968 },
    { 230.00, 8000000, 2, 345, 6, 8, RCC_SYSCLK_DIV1, RCC_HCLK_DIV8, RCC_HCLK_DIV4, 3.593750, 0.003968 },
    { 230.00, 8000000, 3, 345, 4, 8, RCC_SYSCLK_DIV1, RCC_HCLK_DIV8, RCC_HCLK_DIV4, 3.593750, 0.003968 },
    { 230.00, 8000000, 4, 230, 2, 8, RCC_SYSCLK_DIV1, RCC_HCLK_DIV8, RCC_HCLK_DIV4, 3.593750, 0.003968 },
    { 230.00, 8000000, 6, 345, 2, 8, RCC_SYSCLK_DIV1, RCC_HCLK_DIV8, RCC_HCLK_DIV4, 3.593750, 0.003968 },
    { 256.67, 8000000, 2, 385, 6, 9, RCC_SYSCLK_DIV1, RCC_HCLK_DIV8, RCC_HCLK_DIV4, 3.564815, -0.004115 },
    { 256.67, 8000000, 3, 385, 4, 9, RCC_SYSCLK_DIV1, RCC_HCLK_DIV8, RCC_HCLK_DIV4, 3.564815, -0.004115 },
    { 256.67, 8000000, 6, 385, 2, 9, RCC_SYSCLK_DIV1, RCC_HCLK_DIV8, RCC_HCLK_DIV4, 3.564815, -0.004115 },
    { 185.33, 8000000, 2, 278, 6, 13, RCC_SYSCLK_DIV1, RCC_HCLK_DIV4, RCC_HCLK_DIV2, 3.564103, -0.004314 },
    { 185.33, 8000000, 3, 417, 6, 13, RCC_SYSCLK_DIV1, RCC_HCLK_DIV4, RCC_HCLK_DIV2, 3.564103, -0.004314 },
    { 185.33, 8000000, 9, 417, 2, 13, RCC_SYSCLK_DIV1, RCC_HCLK_DIV4, RCC_HCLK_DIV2, 3.564103, -0.004314 },
    { 185.33, 8000000, 3, 139, 2, 13, RCC_SYSCLK_DIV1, RCC_HCLK_DIV4, RCC_HCLK_DIV2, 3.564103, -0.004314 },
    { 185.33, 8000000, 3, 278, 4, 13, RCC_SYSCLK_DIV1, RCC_HCLK_DIV4, RCC_HCLK_DIV2, 3.564103, -0.004314 },
    { 185.33, 8000000, 6, 278, 2, 13, RCC_SYSCLK_DIV1, RCC_HCLK_DIV4, RCC_HCLK_DIV2, 3.564103, -0.004314 },
    { 201.33, 8000000, 3, 151, 2, 14, RCC_SYSCLK_DIV1, RCC_HCLK_DIV4, RCC_HCLK_DIV2, 3.595238, 0.004384 },
    { 201.33, 8000000, 3, 302, 4, 14, RCC_SYSCLK_DIV1, RCC_HCLK_DIV4, RCC_HCLK_DIV2, 3.595238, 0.004384 },
    { 201.33, 8000000, 6, 302, 2, 14, RCC_SYSCLK_DIV1, RCC_HCLK_DIV4, RCC_HCLK_DIV2, 3.595238, 0.004384 },
    { 201.33, 8000000, 2, 302, 6, 14, RCC_SYSCLK_DIV1, RCC_HCLK_DIV4, RCC_HCLK_DIV2, 3.595238, 0.004384 },
    { 187.00, 8000000, 2, 187, 4, 13, RCC_SYSCLK_DIV1, RCC_HCLK_DIV4, RCC_HCLK_DIV2, 3.596154, 0.004640 },
    { 187.00, 8000000, 2, 374, 8, 13, RCC_SYSCLK_DIV1, RCC_HCLK_DIV4, RCC_HCLK_DIV2, 3.596154, 0.004640 },
    { 187.00, 8000000, 4, 187, 2, 13, RCC_SYSCLK_DIV1, RCC_HCLK_DIV4, RCC_HCLK_DIV2, 3.596154, 0.004640 },
    { 187.00, 8000000, 4, 374, 4, 13, RCC_SYSCLK_DIV1, RCC_HCLK_DIV4, RCC_HCLK_DIV2, 3.596154, 0.004640 },
    { 187.00, 8000000, 8, 374, 2, 13, RCC_SYSCLK_DIV1, RCC_HCLK_DIV4, RCC_HCLK_DIV2, 3.596154, 0.004640 },
    { 228.00, 8000000, 7, 399, 2, 8, RCC_SYSCLK_DIV1, RCC_HCLK_DIV8, RCC_HCLK_DIV4, 3.562500, -0.004762 },
    { 228.00, 8000000, 2, 114, 2, 8, RCC_SYSCLK_DIV1, RCC_HCLK_DIV8, RCC_HCLK_DIV4, 3.562500, -0.004762 },
    { 228.00, 8000000, 2, 228, 4, 8, RCC_SYSCLK_DIV1, RCC_HCLK_DIV8, RCC_HCLK_DIV4, 3.562500, -0.004762 },
    { 285.00, 8000000, 2, 285, 4, 10, RCC_SYSCLK_DIV1, RCC_HCLK_DIV8, RCC_HCLK_DIV4, 3.562500, -0.004762 },
    { 228.00, 8000000, 2, 342, 6, 8, RCC_SYSCLK_DIV1, RCC_HCLK_DIV8, RCC_HCLK_DIV4, 3.562500, -0.004762 },
    { 199.50, 8000000, 2, 399, 8, 14, RCC_SYSCLK_DIV1, RCC_HCLK_DIV4, RCC_HCLK_DIV2, 3.562500, -0.004762 },
    { 228.00, 8000000, 3, 171, 2, 8, RCC_SYSCLK_DIV1, RCC_HCLK_DIV8, RCC_HCLK_DIV4, 3.562500, -0.004762 },
    { 228.00, 8000000, 3, 342, 4, 8, RCC_SYSCLK_DIV1, RCC_HCLK_DIV8, RCC_HCLK_DIV4, 3.562500, -0.004762 },
    { 228.00, 8000000, 4, 228, 2, 8, RCC_SYSCLK_DIV1, RCC_HCLK_DIV8, RCC_HCLK_DIV4, 3.562500, -0.004762 },
    { 285.00, 8000000, 4, 285, 2, 10, RCC_SYSCLK_DIV1, RCC_HCLK_DIV8, RCC_HCLK_DIV4, 3.562500, -0.004762 },
    { 199.50, 8000000, 4, 399, 4, 14, RCC_SYSCLK_DIV1, RCC_HCLK_DIV4, RCC_HCLK_DIV2, 3.562500, -0.004762 },
    { 228.00, 8000000, 5, 285, 2, 8, RCC_SYSCLK_DIV1, RCC_HCLK_DIV8, RCC_HCLK_DIV4, 3.562500, -0.004762 },
    { 228.00, 8000000, 6, 342, 2, 8, RCC_SYSCLK_DIV1, RCC_HCLK_DIV8, RCC_HCLK_DIV4, 3.562500, -0.004762 },
    { 199.50, 8000000, 8, 399, 2, 14, RCC_SYSCLK_DIV1, RCC_HCLK_DIV4, RCC_HCLK_DIV2, 3.562500, -0.004762 },
    { 259.00, 8000000, 2, 259, 4, 9, RCC_SYSCLK_DIV1, RCC_HCLK_DIV8, RCC_HCLK_DIV4, 3.597222, 0.004938 },
    { 259.00, 8000000, 4, 259, 2, 9, RCC_SYSCLK_DIV1, RCC_HCLK_DIV8, RCC_HCLK_DIV4, 3.597222, 0.004938 },
    { 199.43, 8000000, 7, 349, 2, 14, RCC_SYSCLK_DIV1, RCC_HCLK_DIV4, RCC_HCLK_DIV2, 3.561224, -0.005118 },
    { 201.50, 8000000, 2, 403, 8, 14, RCC_SYSCLK_DIV1, RCC_HCLK_DIV4, RCC_HCLK_DIV2, 3.598214, 0.005216 },
    { 201.50, 8000000, 4, 403, 4, 14, RCC_SYSCLK_DIV1, RCC_HCLK_DIV4, RCC_HCLK_DIV2, 3.598214, 0.005216 },
    { 230.29, 8000000, 7, 403, 2, 8, RCC_SYSCLK_DIV1, RCC_HCLK_DIV8, RCC_HCLK_DIV4, 3.598214, 0.005216 },
    { 201.50, 8000000, 8, 403, 2, 14, RCC_SYSCLK_DIV1, RCC_HCLK_DIV4, RCC_HCLK_DIV2, 3.598214, 0.005216 },
    { 187.11, 8000000, 3, 421, 6, 13, RCC_SYSCLK_DIV1, RCC_HCLK_DIV4, RCC_HCLK_DIV2, 3.598291, 0.005237 },
    { 187.11, 8000000, 9, 421, 2, 13, RCC_SYSCLK_DIV1, RCC_HCLK_DIV4, RCC_HCLK_DIV2, 3.598291, 0.005237 },
    { 185.14, 8000000, 7, 324, 2, 13, RCC_SYSCLK_DIV1, RCC_HCLK_DIV4, RCC_HCLK_DIV2, 3.560440, -0.005337 },
    { 284.80, 8000000, 5, 356, 2, 10, RCC_SYSCLK_DIV1, RCC_HCLK_DIV8, RCC_HCLK_DIV4, 3.560000, -0.005460 },
    { 199.33, 8000000, 2, 299, 6, 14, RCC_SYSCLK_DIV1, RCC_HCLK_DIV4, RCC_HCLK_DIV2, 3.559524, -0.005593 },
    { 199.33, 8000000, 3, 299, 4, 14, RCC_SYSCLK_DIV1, RCC_HCLK_DIV4, RCC_HCLK_DIV2, 3.559524, -0.005593 },
    { 199.33, 8000000, 6, 299, 2, 14, RCC_SYSCLK_DIV1, RCC_HCLK_DIV4, RCC_HCLK_DIV2, 3.559524, -0.005593 },
    { 288.00, 8000000, 2, 144, 2, 10, RCC_SYSCLK_DIV1, RCC_HCLK_DIV8, RCC_HCLK_DIV4, 3.600000, 0.005714 },
    { 288.00, 8000000, 2, 288, 4, 10, RCC_SYSCLK_DIV1, RCC_HCLK_DIV8, RCC_HCLK_DIV4, 3.600000, 0.005714 },
    { 288.00, 8000000, 3, 216, 2, 10, RCC_SYSCLK_DIV1, RCC_HCLK_DIV8, RCC_HCLK_DIV4, 3.600000, 0.005714 },
    { 288.00, 8000000, 4, 288, 2, 10, RCC_SYSCLK_DIV1, RCC_HCLK_DIV8, RCC_HCLK_DIV4, 3.600000, 0.005714 },
    { 187.20, 8000000, 5, 234, 2, 13, RCC_SYSCLK_DIV1, RCC_HCLK_DIV4, RCC_HCLK_DIV2, 3.600000, 0.005714 },
    { 201.60, 8000000, 5, 252, 2, 14, RCC_SYSCLK_DIV1, RCC_HCLK_DIV4, RCC_HCLK_DIV2, 3.600000, 0.005714 },
    { 230.40, 8000000, 5, 288, 2, 8, RCC_SYSCLK_DIV1, RCC_HCLK_DIV8, RCC_HCLK_DIV4, 3.600000, 0.005714 },
    { 259.20, 8000000, 5, 324, 2, 9, RCC_SYSCLK_DIV1, RCC_HCLK_DIV8, RCC_HCLK_DIV4, 3.600000, 0.005714 },
    { 288.00, 8000000, 5, 360, 2, 10, RCC_SYSCLK_DIV1, RCC_HCLK_DIV8, RCC_HCLK_DIV4, 3.600000, 0.005714 },
    { 284.67, 8000000, 2, 427, 6, 10, RCC_SYSCLK_DIV1, RCC_HCLK_DIV8, RCC_HCLK_DIV4, 3.558333, -0.005926 },
    { 284.67, 8000000, 3, 427, 4, 10, RCC_SYSCLK_DIV1, RCC_HCLK_DIV8, RCC_HCLK_DIV4, 3.558333, -0.005926 },
    { 284.67, 8000000, 6, 427, 2, 10, RCC_SYSCLK_DIV1, RCC_HCLK_DIV8, RCC_HCLK_DIV4, 3.558333, -0.005926 },
    { 185.00, 8000000, 2, 185, 4, 13, RCC_SYSCLK_DIV1, RCC_HCLK_DIV4, RCC_HCLK_DIV2, 3.557692, -0.006105 },
    { 185.00, 8000000, 2, 370, 8, 13, RCC_SYSCLK_DIV1, RCC_HCLK_DIV4, RCC_HCLK_DIV2, 3.557692, -0.006105 },
    { 185.00, 8000000, 4, 185, 2, 13, RCC_SYSCLK_DIV1, RCC_HCLK_DIV4, RCC_HCLK_DIV2, 3.557692, -0.006105 },
    { 185.00, 8000000, 4, 370, 4, 13, RCC_SYSCLK_DIV1, RCC_HCLK_DIV4, RCC_HCLK_DIV2, 3.557692, -0.006105 },
    { 185.00, 8000000, 8, 370, 2, 13, RCC_SYSCLK_DIV1, RCC_HCLK_DIV4, RCC_HCLK_DIV2, 3.557692, -0.006105 },
    { 259.33, 8000000, 3, 389, 4, 9, RCC_SYSCLK_DIV1, RCC_HCLK_DIV8, RCC_HCLK_DIV4, 3.601852, 0.006232 },
    { 259.33, 8000000, 6, 389, 2, 9, RCC_SYSCLK_DIV1, RCC_HCLK_DIV8, RCC_HCLK_DIV4, 3.601852, 0.006232 },
    { 259.33, 8000000, 2, 389, 6, 9, RCC_SYSCLK_DIV1, RCC_HCLK_DIV8, RCC_HCLK_DIV4, 3.601852, 0.006232 },
    { 199.20, 8000000, 5, 249, 2, 14, RCC_SYSCLK_DIV1, RCC_HCLK_DIV4, RCC_HCLK_DIV2, 3.557143, -0.006258 },
    { 201.71, 8000000, 7, 353, 2, 14, RCC_SYSCLK_DIV1, RCC_HCLK_DIV4, RCC_HCLK_DIV2, 3.602041, 0.006285 },
    { 187.33, 8000000, 3, 281, 4, 13, RCC_SYSCLK_DIV1, RCC_HCLK_DIV4, RCC_HCLK_DIV2, 3.602564, 0.006431 },
    { 187.33, 8000000, 6, 281, 2, 13, RCC_SYSCLK_DIV1, RCC_HCLK_DIV4, RCC_HCLK_DIV2, 3.602564, 0.006431 },
    { 187.33, 8000000, 2, 281, 6, 13, RCC_SYSCLK_DIV1, RCC_HCLK_DIV4, RCC_HCLK_DIV2, 3.602564, 0.006431 },
    { 256.00, 8000000, 2, 128, 2, 9, RCC_SYSCLK_DIV1, RCC_HCLK_DIV8, RCC_HCLK_DIV4, 3.555556, -0.006702 },
    { 256.00, 8000000, 2, 256, 4, 9, RCC_SYSCLK_DIV1, RCC_HCLK_DIV8, RCC_HCLK_DIV4, 3.555556, -0.006702 },
    { 256.00, 8000000, 2, 384, 6, 9, RCC_SYSCLK_DIV1, RCC_HCLK_DIV8, RCC_HCLK_DIV4, 3.555556, -0.006702 },
    { 256.00, 8000000, 3, 192, 2, 9, RCC_SYSCLK_DIV1, RCC_HCLK_DIV8, RCC_HCLK_DIV4, 3.555556, -0.006702 },
    { 256.00, 8000000, 3, 384, 4, 9, RCC_SYSCLK_DIV1, RCC_HCLK_DIV8, RCC_HCLK_DIV4, 3.555556, -0.006702 },
    { 256.00, 8000000, 4, 256, 2, 9, RCC_SYSCLK_DIV1, RCC_HCLK_DIV8, RCC_HCLK_DIV4, 3.555556, -0.006702 },
    { 256.00, 8000000, 5, 320, 2, 9, RCC_SYSCLK_DIV1, RCC_HCLK_DIV8, RCC_HCLK_DIV4, 3.555556, -0.006702 },
    { 256.00, 8000000, 6, 384, 2, 9, RCC_SYSCLK_DIV1, RCC_HCLK_DIV8, RCC_HCLK_DIV4, 3.555556, -0.006702 },
    { 184.89, 8000000, 9, 416, 2, 13, RCC_SYSCLK_DIV1, RCC_HCLK_DIV4, RCC_HCLK_DIV2, 3.555556, -0.006702 },
    { 184.89, 8000000, 3, 416, 6, 13, RCC_SYSCLK_DIV1, RCC_HCLK_DIV4, RCC_HCLK_DIV2, 3.555556, -0.006702 },
    { 230.67, 8000000, 2, 346, 6, 8, RCC_SYSCLK_DIV1, RCC_HCLK_DIV8, RCC_HCLK_DIV4, 3.604167, 0.006878 },
    { 230.67, 8000000, 3, 173, 2, 8, RCC_SYSCLK_DIV1, RCC_HCLK_DIV8, RCC_HCLK_DIV4, 3.604167, 0.006878 },
    { 230.67, 8000000, 3, 346, 4, 8, RCC_SYSCLK_DIV1, RCC_HCLK_DIV8, RCC_HCLK_DIV4, 3.604167, 0.006878 },
    { 230.67, 8000000, 6, 346, 2, 8, RCC_SYSCLK_DIV1, RCC_HCLK_DIV8, RCC_HCLK_DIV4, 3.604167, 0.006878 },
    { 187.43, 8000000, 7, 328, 2, 13, RCC_SYSCLK_DIV1, RCC_HCLK_DIV4, RCC_HCLK_DIV2, 3.604396, 0.006942 },
    { 184.80, 8000000, 5, 231, 2, 13, RCC_SYSCLK_DIV1, RCC_HCLK_DIV4, RCC_HCLK_DIV2, 3.553846, -0.007179 },
    { 227.43, 8000000, 7, 398, 2, 8, RCC_SYSCLK_DIV1, RCC_HCLK_DIV8, RCC_HCLK_DIV4, 3.553571, -0.007256 },
    { 199.00, 8000000, 2, 199, 4, 14, RCC_SYSCLK_DIV1, RCC_HCLK_DIV4, RCC_HCLK_DIV2, 3.553571, -0.007256 },
    { 199.00, 8000000, 2, 398, 8, 14, RCC_SYSCLK_DIV1, RCC_HCLK_DIV4, RCC_HCLK_DIV2, 3.553571, -0.007256 },
    { 199.00, 8000000, 4, 199, 2, 14, RCC_SYSCLK_DIV1, RCC_HCLK_DIV4, RCC_HCLK_DIV2, 3.553571, -0.007256 },
    { 199.00, 8000000, 4, 398, 4, 14, RCC_SYSCLK_DIV1, RCC_HCLK_DIV4, RCC_HCLK_DIV2, 3.553571, -0.007256 },
    { 199.00, 8000000, 8, 398, 2, 14, RCC_SYSCLK_DIV1, RCC_HCLK_DIV4, RCC_HCLK_DIV2, 3.553571, -0.007256 },
    { 187.50, 8000000, 2, 375, 8, 13, RCC_SYSCLK_DIV1, RCC_HCLK_DIV4, RCC_HCLK_DIV2, 3.605769, 0.007326 },
    { 187.50, 8000000, 4, 375, 4, 13, RCC_SYSCLK_DIV1, RCC_HCLK_DIV4, RCC_HCLK_DIV2, 3.605769, 0.007326 },
    { 187.50, 8000000, 8, 375, 2, 13, RCC_SYSCLK_DIV1, RCC_HCLK_DIV4, RCC_HCLK_DIV2, 3.605769, 0.007326 },
    { 187.56, 8000000, 3, 422, 6, 13, RCC_SYSCLK_DIV1, RCC_HCLK_DIV4, RCC_HCLK_DIV2, 3.606838, 0.007625 },
    { 187.56, 8000000, 9, 422, 2, 13, RCC_SYSCLK_DIV1, RCC_HCLK_DIV4, RCC_HCLK_DIV2, 3.606838, 0.007625 },
    { 227.33, 8000000, 2, 341, 6, 8, RCC_SYSCLK_DIV1, RCC_HCLK_DIV8, RCC_HCLK_DIV4, 3.552083, -0.007672 },
    { 227.33, 8000000, 3, 341, 4, 8, RCC_SYSCLK_DIV1, RCC_HCLK_DIV8, RCC_HCLK_DIV4, 3.552083, -0.007672 },
    { 227.33, 8000000, 6, 341, 2, 8, RCC_SYSCLK_DIV1, RCC_HCLK_DIV8, RCC_HCLK_DIV4, 3.552083, -0.007672 },
    { 202.00, 8000000, 2, 101, 2, 14, RCC_SYSCLK_DIV1, RCC_HCLK_DIV4, RCC_HCLK_DIV2, 3.607143, 0.007710 },
    { 202.00, 8000000, 2, 202, 4, 14, RCC_SYSCLK_DIV1, RCC_HCLK_DIV4, RCC_HCLK_DIV2, 3.607143, 0.007710 },
    { 202.00, 8000000, 2, 303, 6, 14, RCC_SYSCLK_DIV1, RCC_HCLK_DIV4, RCC_HCLK_DIV2, 3.607143, 0.007710 },
    { 202.00, 8000000, 2, 404, 8, 14, RCC_SYSCLK_DIV1, RCC_HCLK_DIV4, RCC_HCLK_DIV2, 3.607143, 0.007710 },
    { 202.00, 8000000, 3, 303, 4, 14, RCC_SYSCLK_DIV1, RCC_HCLK_DIV4, RCC_HCLK_DIV2, 3.607143, 0.007710 },
    { 202.00, 8000000, 4, 202, 2, 14, RCC_SYSCLK_DIV1, RCC_HCLK_DIV4, RCC_HCLK_DIV2, 3.607143, 0.007710 },
    { 202.00, 8000000, 4, 404, 4, 14, RCC_SYSCLK_DIV1, RCC_HCLK_DIV4, RCC_HCLK_DIV2, 3.607143, 0.007710 },
    { 202.00, 8000000, 6, 303, 2, 14, RCC_SYSCLK_DIV1, RCC_HCLK_DIV4, RCC_HCLK_DIV2, 3.607143, 0.007710 },
    { 230.86, 8000000, 7, 404, 2, 8, RCC_SYSCLK_DIV1, RCC_HCLK_DIV8, RCC_HCLK_DIV4, 3.607143, 0.007710 },
    { 202.00, 8000000, 8, 404, 2, 14, RCC_SYSCLK_DIV1, RCC_HCLK_DIV4, RCC_HCLK_DIV2, 3.607143, 0.007710 },
    { 184.67, 8000000, 2, 277, 6, 13, RCC_SYSCLK_DIV1, RCC_HCLK_DIV4, RCC_HCLK_DIV2, 3.551282, -0.007896 },
    { 184.67, 8000000, 3, 277, 4, 13, RCC_SYSCLK_DIV1, RCC_HCLK_DIV4, RCC_HCLK_DIV2, 3.551282, -0.007896 },
    { 184.67, 8000000, 6, 277, 2, 13, RCC_SYSCLK_DIV1, RCC_HCLK_DIV4, RCC_HCLK_DIV2, 3.551282, -0.007896 },
    { 198.86, 8000000, 7, 348, 2, 14, RCC_SYSCLK_DIV1, RCC_HCLK_DIV4, RCC_HCLK_DIV2, 3.551020, -0.007969 },
    { 284.00, 8000000, 2, 142, 2, 10, RCC_SYSCLK_DIV1, RCC_HCLK_DIV8, RCC_HCLK_DIV4, 3.550000, -0.008254 },
    { 284.00, 8000000, 2, 284, 4, 10, RCC_SYSCLK_DIV1, RCC_HCLK_DIV8, RCC_HCLK_DIV4, 3.550000, -0.008254 },
    { 284.00, 8000000, 2, 426, 6, 10, RCC_SYSCLK_DIV1, RCC_HCLK_DIV8, RCC_HCLK_DIV4, 3.550000, -0.008254 },
    { 284.00, 8000000, 3, 213, 2, 10, RCC_SYSCLK_DIV1, RCC_HCLK_DIV8, RCC_HCLK_DIV4, 3.550000, -0.008254 },
    { 284.00, 8000000, 3, 426, 4, 10, RCC_SYSCLK_DIV1, RCC_HCLK_DIV8, RCC_HCLK_DIV4, 3.550000, -0.008254 },
    { 284.00, 8000000, 4, 284, 2, 10, RCC_SYSCLK_DIV1, RCC_HCLK_DIV8, RCC_HCLK_DIV4, 3.550000, -0.008254 },
    { 227.20, 8000000, 5, 284, 2, 8, RCC_SYSCLK_DIV1, RCC_HCLK_DIV8, RCC_HCLK_DIV4, 3.550000, -0.008254 },
    { 284.00, 8000000, 5, 355, 2, 10, RCC_SYSCLK_DIV1, RCC_HCLK_DIV8, RCC_HCLK_DIV4, 3.550000, -0.008254 },
    { 284.00, 8000000, 6, 426, 2, 10, RCC_SYSCLK_DIV1, RCC_HCLK_DIV8, RCC_HCLK_DIV4, 3.550000, -0.008254 },
    { 231.00, 8000000, 2, 231, 4, 8, RCC_SYSCLK_DIV1, RCC_HCLK_DIV8, RCC_HCLK_DIV4, 3.609375, 0.008333 },
    { 231.00, 8000000, 4, 231, 2, 8, RCC_SYSCLK_DIV1, RCC_HCLK_DIV8, RCC_HCLK_DIV4, 3.609375, 0.008333 },
    { 184.57, 8000000, 7, 323, 2, 13, RCC_SYSCLK_DIV1, RCC_HCLK_DIV4, RCC_HCLK_DIV2, 3.549451, -0.008407 },
    { 288.80, 8000000, 5, 361, 2, 10, RCC_SYSCLK_DIV1, RCC_HCLK_DIV8, RCC_HCLK_DIV4, 3.610000, 0.008508 },
    { 184.50, 8000000, 2, 369, 8, 13, RCC_SYSCLK_DIV1, RCC_HCLK_DIV4, RCC_HCLK_DIV2, 3.548077, -0.008791 },
    { 184.50, 8000000, 4, 369, 4, 13, RCC_SYSCLK_DIV1, RCC_HCLK_DIV4, RCC_HCLK_DIV2, 3.548077, -0.008791 },
    { 184.50, 8000000, 8, 369, 2, 13, RCC_SYSCLK_DIV1, RCC_HCLK_DIV4, RCC_HCLK_DIV2, 3.548077, -0.008791 },
    { 260.00, 8000000, 3, 195, 2, 9, RCC_SYSCLK_DIV1, RCC_HCLK_DIV8, RCC_HCLK_DIV4, 3.611111, 0.008818 },
    { 260.00, 8000000, 3, 390, 4, 9, RCC_SYSCLK_DIV1, RCC_HCLK_DIV8, RCC_HCLK_DIV4, 3.611111, 0.008818 },
    { 260.00, 8000000, 6, 390, 2, 9, RCC_SYSCLK_DIV1, RCC_HCLK_DIV8, RCC_HCLK_DIV4, 3.611111, 0.008818 },
    { 260.00, 8000000, 2, 130, 2, 9, RCC_SYSCLK_DIV1, RCC_HCLK_DIV8, RCC_HCLK_DIV4, 3.611111, 0.008818 },
    { 260.00, 8000000, 2, 260, 4, 9, RCC_SYSCLK_DIV1, RCC_HCLK_DIV8, RCC_HCLK_DIV4, 3.611111, 0.008818 },
    { 260.00, 8000000, 2, 390, 6, 9, RCC_SYSCLK_DIV1, RCC_HCLK_DIV8, RCC_HCLK_DIV4, 3.611111, 0.008818 },
    { 260.00, 8000000, 4, 260, 2, 9, RCC_SYSCLK_DIV1, RCC_HCLK_DIV8, RCC_HCLK_DIV4, 3.611111, 0.008818 },
    { 260.00, 8000000, 5, 325, 2, 9, RCC_SYSCLK_DIV1, RCC_HCLK_DIV8, RCC_HCLK_DIV4, 3.611111, 0.008818 },
    { 198.67, 8000000, 2, 298, 6, 14, RCC_SYSCLK_DIV1, RCC_HCLK_DIV4, RCC_HCLK_DIV2, 3.547619, -0.008919 },
    { 198.67, 8000000, 3, 149, 2, 14, RCC_SYSCLK_DIV1, RCC_HCLK_DIV4, RCC_HCLK_DIV2, 3.547619, -0.008919 },
    { 198.67, 8000000, 3, 298, 4, 14, RCC_SYSCLK_DIV1, RCC_HCLK_DIV4, RCC_HCLK_DIV2, 3.547619, -0.008919 },
    { 198.67, 8000000, 6, 298, 2, 14, RCC_SYSCLK_DIV1, RCC_HCLK_DIV4, RCC_HCLK_DIV2, 3.547619, -0.008919 },
    { 184.44, 8000000, 9, 415, 2, 13, RCC_SYSCLK_DIV1, RCC_HCLK_DIV4, RCC_HCLK_DIV2, 3.547009, -0.009090 },
    { 184.44, 8000000, 3, 415, 6, 13, RCC_SYSCLK_DIV1, RCC_HCLK_DIV4, RCC_HCLK_DIV2, 3.547009, -0.009090 },
    { 227.00, 8000000, 2, 227, 4, 8, RCC_SYSCLK_DIV1, RCC_HCLK_DIV8, RCC_HCLK_DIV4, 3.546875, -0.009127 },
    { 227.00, 8000000, 4, 227, 2, 8, RCC_SYSCLK_DIV1, RCC_HCLK_DIV8, RCC_HCLK_DIV4, 3.546875, -0.009127 },
    { 202.29, 8000000, 7, 354, 2, 14, RCC_SYSCLK_DIV1, RCC_HCLK_DIV4, RCC_HCLK_DIV2, 3.612245, 0.009135 },
    { 289.00, 8000000, 2, 289, 4, 10, RCC_SYSCLK_DIV1, RCC_HCLK_DIV8, RCC_HCLK_DIV4, 3.612500, 0.009206 },
    { 289.00, 8000000, 4, 289, 2, 10, RCC_SYSCLK_DIV1, RCC_HCLK_DIV8, RCC_HCLK_DIV4, 3.612500, 0.009206 },
    { 231.20, 8000000, 5, 289, 2, 8, RCC_SYSCLK_DIV1, RCC_HCLK_DIV8, RCC_HCLK_DIV4, 3.612500, 0.009206 },
    { 255.33, 8000000, 2, 383, 6, 9, RCC_SYSCLK_DIV1, RCC_HCLK_DIV8, RCC_HCLK_DIV4, 3.546296, -0.009289 },
    { 255.33, 8000000, 3, 383, 4, 9, RCC_SYSCLK_DIV1, RCC_HCLK_DIV8, RCC_HCLK_DIV4, 3.546296, -0.009289 },
    { 255.33, 8000000, 6, 383, 2, 9, RCC_SYSCLK_DIV1, RCC_HCLK_DIV8, RCC_HCLK_DIV4, 3.546296, -0.009289 },
    { 202.40, 8000000, 5, 253, 2, 14, RCC_SYSCLK_DIV1, RCC_HCLK_DIV4, RCC_HCLK_DIV2, 3.614286, 0.009705 },
    { 198.50, 8000000, 2, 397, 8, 14, RCC_SYSCLK_DIV1, RCC_HCLK_DIV4, RCC_HCLK_DIV2, 3.544643, -0.009750 },
    { 198.50, 8000000, 4, 397, 4, 14, RCC_SYSCLK_DIV1, RCC_HCLK_DIV4, RCC_HCLK_DIV2, 3.544643, -0.009750 },
    { 226.86, 8000000, 7, 397, 2, 8, RCC_SYSCLK_DIV1, RCC_HCLK_DIV8, RCC_HCLK_DIV4, 3.544643, -0.009750 },
    { 198.50, 8000000, 8, 397, 2, 14, RCC_SYSCLK_DIV1, RCC_HCLK_DIV4, RCC_HCLK_DIV2, 3.544643, -0.009750 },
    { 231.33, 8000000, 3, 347, 4, 8, RCC_SYSCLK_DIV1, RCC_HCLK_DIV8, RCC_HCLK_DIV4, 3.614583, 0.009788 },
    { 231.33, 8000000, 6, 347, 2, 8, RCC_SYSCLK_DIV1, RCC_HCLK_DIV8, RCC_HCLK_DIV4, 3.614583, 0.009788 },
    { 231.33, 8000000, 2, 347, 6, 8, RCC_SYSCLK_DIV1, RCC_HCLK_DIV8, RCC_HCLK_DIV4, 3.614583, 0.009788 },
    { 255.20, 8000000, 5, 319, 2, 9, RCC_SYSCLK_DIV1, RCC_HCLK_DIV8, RCC_HCLK_DIV4, 3.544444, -0.009806 },
    { 188.00, 8000000, 2, 94, 2, 13, RCC_SYSCLK_DIV1, RCC_HCLK_DIV4, RCC_HCLK_DIV2, 3.615385, 0.010012 },
    { 188.00, 8000000, 2, 188, 4, 13, RCC_SYSCLK_DIV1, RCC_HCLK_DIV4, RCC_HCLK_DIV2, 3.615385, 0.010012 },
    { 188.00, 8000000, 2, 282, 6, 13, RCC_SYSCLK_DIV1, RCC_HCLK_DIV4, RCC_HCLK_DIV2, 3.615385, 0.010012 },
    { 188.00, 8000000, 2, 376, 8, 13, RCC_SYSCLK_DIV1, RCC_HCLK_DIV4, RCC_HCLK_DIV2, 3.615385, 0.010012 },
    { 188.00, 8000000, 3, 141, 2, 13, RCC_SYSCLK_DIV1, RCC_HCLK_DIV4, RCC_HCLK_DIV2, 3.615385, 0.010012 },
    { 188.00, 8000000, 3, 282, 4, 13, RCC_SYSCLK_DIV1, RCC_HCLK_DIV4, RCC_HCLK_DIV2, 3.615385, 0.010012 },
    { 188.00, 8000000, 3, 423, 6, 13, RCC_SYSCLK_DIV1, RCC_HCLK_DIV4, RCC_HCLK_DIV2, 3.615385, 0.010012 },
    { 188.00, 8000000, 4, 188, 2, 13, RCC_SYSCLK_DIV1, RCC_HCLK_DIV4, RCC_HCLK_DIV2, 3.615385, 0.010012 },
    { 188.00, 8000000, 4, 376, 4, 13, RCC_SYSCLK_DIV1, RCC_HCLK_DIV4, RCC_HCLK_DIV2, 3.615385, 0.010012 },
    { 188.00, 8000000, 5, 235, 2, 13, RCC_SYSCLK_DIV1, RCC_HCLK_DIV4, RCC_HCLK_DIV2, 3.615385, 0.010012 },
    { 188.00, 8000000, 6, 282, 2, 13, RCC_SYSCLK_DIV1, RCC_HCLK_DIV4, RCC_HCLK_DIV2, 3.615385, 0.010012 },
    { 188.00, 8000000, 8, 376, 2, 13, RCC_SYSCLK_DIV1, RCC_HCLK_DIV4, RCC_HCLK_DIV2, 3.615385, 0.010012 },
    { 188.00, 8000000, 9, 423, 2, 13, RCC_SYSCLK_DIV1, RCC_HCLK_DIV4, RCC_HCLK_DIV2, 3.615385, 0.010012 },
    { 188.00, 8000000, 7, 329, 2, 13, RCC_SYSCLK_DIV1, RCC_HCLK_DIV4, RCC_HCLK_DIV2, 3.615385, 0.010012 },
    { 202.50, 8000000, 2, 405, 8, 14, RCC_SYSCLK_DIV1, RCC_HCLK_DIV4, RCC_HCLK_DIV2, 3.616071, 0.010204 },
    { 202.50, 8000000, 4, 405, 4, 14, RCC_SYSCLK_DIV1, RCC_HCLK_DIV4, RCC_HCLK_DIV2, 3.616071, 0.010204 },
    { 202.50, 8000000, 8, 405, 2, 14, RCC_SYSCLK_DIV1, RCC_HCLK_DIV4, RCC_HCLK_DIV2, 3.616071, 0.010204 },
    { 231.43, 8000000, 7, 405, 2, 8, RCC_SYSCLK_DIV1, RCC_HCLK_DIV8, RCC_HCLK_DIV4, 3.616071, 0.010204 },
    { 198.40, 8000000, 5, 248, 2, 14, RCC_SYSCLK_DIV1, RCC_HCLK_DIV4, RCC_HCLK_DIV2, 3.542857, -0.010249 },
    { 289.33, 8000000, 3, 217, 2, 10, RCC_SYSCLK_DIV1, RCC_HCLK_DIV8, RCC_HCLK_DIV4, 3.616667, 0.010370 },
    { 255.00, 8000000, 2, 255, 4, 9, RCC_SYSCLK_DIV1, RCC_HCLK_DIV8, RCC_HCLK_DIV4, 3.541667, -0.010582 },
    { 226.67, 8000000, 2, 340, 6, 8, RCC_SYSCLK_DIV1, RCC_HCLK_DIV8, RCC_HCLK_DIV4, 3.541667, -0.010582 },
    { 283.33, 8000000, 2, 425, 6, 10, RCC_SYSCLK_DIV1, RCC_HCLK_DIV8, RCC_HCLK_DIV4, 3.541667, -0.010582 },
    { 226.67, 8000000, 3, 170, 2, 8, RCC_SYSCLK_DIV1, RCC_HCLK_DIV8, RCC_HCLK_DIV4, 3.541667, -0.010582 },
    { 226.67, 8000000, 3, 340, 4, 8, RCC_SYSCLK_DIV1, RCC_HCLK_DIV8, RCC_HCLK_DIV4, 3.541667, -0.010582 },
    { 283.33, 8000000, 3, 425, 4, 10, RCC_SYSCLK_DIV1, RCC_HCLK_DIV8, RCC_HCLK_DIV4, 3.541667, -0.010582 },
    { 255.00, 8000000, 4, 255, 2, 9, RCC_SYSCLK_DIV1, RCC_HCLK_DIV8, RCC_HCLK_DIV4, 3.541667, -0.010582 },
    { 226.67, 8000000, 6, 340, 2, 8, RCC_SYSCLK_DIV1, RCC_HCLK_DIV8, RCC_HCLK_DIV4, 3.541667, -0.010582 },
    { 283.33, 8000000, 6, 425, 2, 10, RCC_SYSCLK_DIV1, RCC_HCLK_DIV8, RCC_HCLK_DIV4, 3.541667, -0.010582 },
    { 198.29, 8000000, 7, 347, 2, 14, RCC_SYSCLK_DIV1, RCC_HCLK_DIV4, RCC_HCLK_DIV2, 3.540816, -0.010819 },
    { 202.67, 8000000, 2, 304, 6, 14, RCC_SYSCLK_DIV1, RCC_HCLK_DIV4, RCC_HCLK_DIV2, 3.619048, 0.011036 },
    { 202.67, 8000000, 3, 152, 2, 14, RCC_SYSCLK_DIV1, RCC_HCLK_DIV4, RCC_HCLK_DIV2, 3.619048, 0.011036 },
    { 202.67, 8000000, 3, 304, 4, 14, RCC_SYSCLK_DIV1, RCC_HCLK_DIV4, RCC_HCLK_DIV2, 3.619048, 0.011036 },
    { 202.67, 8000000, 6, 304, 2, 14, RCC_SYSCLK_DIV1, RCC_HCLK_DIV4, RCC_HCLK_DIV2, 3.619048, 0.011036 },
    { 283.20, 8000000, 5, 354, 2, 10, RCC_SYSCLK_DIV1, RCC_HCLK_DIV8, RCC_HCLK_DIV4, 3.540000, -0.011047 },
    { 289.60, 8000000, 5, 362, 2, 10, RCC_SYSCLK_DIV1, RCC_HCLK_DIV8, RCC_HCLK_DIV4, 3.620000, 0.011302 },
    { 260.67, 8000000, 2, 391, 6, 9, RCC_SYSCLK_DIV1, RCC_HCLK_DIV8, RCC_HCLK_DIV4, 3.620370, 0.011405 },
    { 260.67, 8000000, 3, 391, 4, 9, RCC_SYSCLK_DIV1, RCC_HCLK_DIV8, RCC_HCLK_DIV4, 3.620370, 0.011405 },
    { 260.67, 8000000, 6, 391, 2, 9, RCC_SYSCLK_DIV1, RCC_HCLK_DIV8, RCC_HCLK_DIV4, 3.620370, 0.011405 },
    { 184.00, 8000000, 7, 322, 2, 13, RCC_SYSCLK_DIV1, RCC_HCLK_DIV4, RCC_HCLK_DIV2, 3.538462, -0.011477 },
    { 184.00, 8000000, 2, 92, 2, 13, RCC_SYSCLK_DIV1, RCC_HCLK_DIV4, RCC_HCLK_DIV2, 3.538462, -0.011477 },
    { 184.00, 8000000, 2, 184, 4, 13, RCC_SYSCLK_DIV1, RCC_HCLK_DIV4, RCC_HCLK_DIV2, 3.538462, -0.011477 },
    { 184.00, 8000000, 2, 276, 6, 13, RCC_SYSCLK_DIV1, RCC_HCLK_DIV4, RCC_HCLK_DIV2, 3.538462, -0.011477 },
    { 184.00, 8000000, 2, 368, 8, 13, RCC_SYSCLK_DIV1, RCC_HCLK_DIV4, RCC_HCLK_DIV2, 3.538462, -0.011477 },
    { 184.00, 8000000, 3, 138, 2, 13, RCC_SYSCLK_DIV1, RCC_HCLK_DIV4, RCC_HCLK_DIV2, 3.538462, -0.011477 },
    { 184.00, 8000000, 3, 276, 4, 13, RCC_SYSCLK_DIV1, RCC_HCLK_DIV4, RCC_HCLK_DIV2, 3.538462, -0.011477 },
    { 184.00, 8000000, 3, 414, 6, 13, RCC_SYSCLK_DIV1, RCC_HCLK_DIV4, RCC_HCLK_DIV2, 3.538462, -0.011477 },
    { 184.00, 8000000, 4, 184, 2, 13, RCC_SYSCLK_DIV1, RCC_HCLK_DIV4, RCC_HCLK_DIV2, 3.538462, -0.011477 },
    { 184.00, 8000000, 4, 368, 4, 13, RCC_SYSCLK_DIV1, RCC_HCLK_DIV4, RCC_HCLK_DIV2, 3.538462, -0.011477 },
    { 184.00, 8000000, 5, 230, 2, 13, RCC_SYSCLK_DIV1, RCC_HCLK_DIV4, RCC_HCLK_DIV2, 3.538462, -0.011477 },
    { 184.00, 8000000, 6, 276, 2, 13, RCC_SYSCLK_DIV1, RCC_HCLK_DIV4, RCC_HCLK_DIV2, 3.538462, -0.011477 },
    { 184.00, 8000000, 8, 368, 2, 13, RCC_SYSCLK_DIV1, RCC_HCLK_DIV4, RCC_HCLK_DIV2, 3.538462, -0.011477 },
    { 184.00, 8000000, 9, 414, 2, 13, RCC_SYSCLK_DIV1, RCC_HCLK_DIV4, RCC_HCLK_DIV2, 3.538462, -0.011477 },
    { 283.00, 8000000, 2, 283, 4, 10, RCC_SYSCLK_DIV1, RCC_HCLK_DIV8, RCC_HCLK_DIV4, 3.537500, -0.011746 },
    { 283.00, 8000000, 4, 283, 2, 10, RCC_SYSCLK_DIV1, RCC_HCLK_DIV8, RCC_HCLK_DIV4, 3.537500, -0.011746 },
    { 226.40, 8000000, 5, 283, 2, 8, RCC_SYSCLK_DIV1, RCC_HCLK_DIV8, RCC_HCLK_DIV4, 3.537500, -0.011746 },
    { 254.67, 8000000, 2, 382, 6, 9, RCC_SYSCLK_DIV1, RCC_HCLK_DIV8, RCC_HCLK_DIV4, 3.537037, -0.011875 },
    { 254.67, 8000000, 3, 191, 2, 9, RCC_SYSCLK_DIV1, RCC_HCLK_DIV8, RCC_HCLK_DIV4, 3.537037, -0.011875 },
    { 254.67, 8000000, 3, 382, 4, 9, RCC_SYSCLK_DIV1, RCC_HCLK_DIV8, RCC_HCLK_DIV4, 3.537037, -0.011875 },
    { 254.67, 8000000, 6, 382, 2, 9, RCC_SYSCLK_DIV1, RCC_HCLK_DIV8, RCC_HCLK_DIV4, 3.537037, -0.011875 },
    { 260.80, 8000000, 5, 326, 2, 9, RCC_SYSCLK_DIV1, RCC_HCLK_DIV8, RCC_HCLK_DIV4, 3.622222, 0.011923 },
    { 202.86, 8000000, 7, 355, 2, 14, RCC_SYSCLK_DIV1, RCC_HCLK_DIV4, RCC_HCLK_DIV2, 3.622449, 0.011986 },
    { 198.00, 8000000, 2, 99, 2, 14, RCC_SYSCLK_DIV1, RCC_HCLK_DIV4, RCC_HCLK_DIV2, 3.535714, -0.012245 },
    { 198.00, 8000000, 2, 198, 4, 14, RCC_SYSCLK_DIV1, RCC_HCLK_DIV4, RCC_HCLK_DIV2, 3.535714, -0.012245 },
    { 198.00, 8000000, 2, 297, 6, 14, RCC_SYSCLK_DIV1, RCC_HCLK_DIV4, RCC_HCLK_DIV2, 3.535714, -0.012245 },
    { 198.00, 8000000, 2, 396, 8, 14, RCC_SYSCLK_DIV1, RCC_HCLK_DIV4, RCC_HCLK_DIV2, 3.535714, -0.012245 },
    { 198.00, 8000000, 3, 297, 4, 14, RCC_SYSCLK_DIV1, RCC_HCLK_DIV4, RCC_HCLK_DIV2, 3.535714, -0.012245 },
    { 198.00, 8000000, 4, 198, 2, 14, RCC_SYSCLK_DIV1, RCC_HCLK_DIV4, RCC_HCLK_DIV2, 3.535714, -0.012245 },
    { 198.00, 8000000, 4, 396, 4, 14, RCC_SYSCLK_DIV1, RCC_HCLK_DIV4, RCC_HCLK_DIV2, 3.535714, -0.012245 },
    { 198.00, 8000000, 6, 297, 2, 14, RCC_SYSCLK_DIV1, RCC_HCLK_DIV4, RCC_HCLK_DIV2, 3.535714, -0.012245 },
    { 226.29, 8000000, 7, 396, 2, 8, RCC_SYSCLK_DIV1, RCC_HCLK_DIV8, RCC_HCLK_DIV4, 3.535714, -0.012245 },
    { 198.00, 8000000, 8, 396, 2, 14, RCC_SYSCLK_DIV1, RCC_HCLK_DIV4, RCC_HCLK_DIV2, 3.535714, -0.012245 },
    { 188.44, 8000000, 3, 424, 6, 13, RCC_SYSCLK_DIV1, RCC_HCLK_DIV4, RCC_HCLK_DIV2, 3.623932, 0.012400 },
    { 188.44, 8000000, 9, 424, 2, 13, RCC_SYSCLK_DIV1, RCC_HCLK_DIV4, RCC_HCLK_DIV2, 3.623932, 0.012400 },
    { 232.00, 8000000, 2, 116, 2, 8, RCC_SYSCLK_DIV1, RCC_HCLK_DIV8, RCC_HCLK_DIV4, 3.625000, 0.012699 },
    { 290.00, 8000000, 2, 145, 2, 10, RCC_SYSCLK_DIV1, RCC_HCLK_DIV8, RCC_HCLK_DIV4, 3.625000, 0.012699 },
    { 203.00, 8000000, 2, 203, 4, 14, RCC_SYSCLK_DIV1, RCC_HCLK_DIV4, RCC_HCLK_DIV2, 3.625000, 0.012699 },
    { 232.00, 8000000, 2, 232, 4, 8, RCC_SYSCLK_DIV1, RCC_HCLK_DIV8, RCC_HCLK_DIV4, 3.625000, 0.012699 },
    { 261.00, 8000000, 2, 261, 4, 9, RCC_SYSCLK_DIV1, RCC_HCLK_DIV8, RCC_HCLK_DIV4, 3.625000, 0.012699 },
    { 290.00, 8000000, 2, 290, 4, 10, RCC_SYSCLK_DIV1, RCC_HCLK_DIV8, RCC_HCLK_DIV4, 3.625000, 0.012699 },
    { 232.00, 8000000, 2, 348, 6, 8, RCC_SYSCLK_DIV1, RCC_HCLK_DIV8, RCC_HCLK_DIV4, 3.625000, 0.012699 },
    { 188.50, 8000000, 2, 377, 8, 13, RCC_SYSCLK_DIV1, RCC_HCLK_DIV4, RCC_HCLK_DIV2, 3.625000, 0.012699 },
    { 203.00, 8000000, 2, 406, 8, 14, RCC_SYSCLK_DIV1, RCC_HCLK_DIV4, RCC_HCLK_DIV2, 3.625000, 0.012699 },
    { 232.00, 8000000, 3, 174, 2, 8, RCC_SYSCLK_DIV1, RCC_HCLK_DIV8, RCC_HCLK_DIV4, 3.625000, 0.012699 },
    { 232.00, 8000000, 3, 348, 4, 8, RCC_SYSCLK_DIV1, RCC_HCLK_DIV8, RCC_HCLK_DIV4, 3.625000, 0.012699 },
    { 203.00, 8000000, 4, 203, 2, 14, RCC_SYSCLK_DIV1, RCC_HCLK_DIV4, RCC_HCLK_DIV2, 3.625000, 0.012699 },
    { 232.00, 8000000, 4, 232, 2, 8, RCC_SYSCLK_DIV1, RCC_HCLK_DIV8, RCC_HCLK_DIV4, 3.625000, 0.012699 },
    { 261.00, 8000000, 4, 261, 2, 9, RCC_SYSCLK_DIV1, RCC_HCLK_DIV8, RCC_HCLK_DIV4, 3.625000, 0.012699 },
    { 290.00, 8000000, 4, 290, 2, 10, RCC_SYSCLK_DIV1, RCC_HCLK_DIV8, RCC_HCLK_DIV4, 3.625000, 0.012699 },
    { 188.50, 8000000, 4, 377, 4, 13, RCC_SYSCLK_DIV1, RCC_HCLK_DIV4, RCC_HCLK_DIV2, 3.625000, 0.012699 },
    { 203.00, 8000000, 4, 406, 4, 14, RCC_SYSCLK_DIV1, RCC_HCLK_DIV4, RCC_HCLK_DIV2, 3.625000, 0.012699 },
    { 232.00, 8000000, 5, 290, 2, 8, RCC_SYSCLK_DIV1, RCC_HCLK_DIV8, RCC_HCLK_DIV4, 3.625000, 0.012699 },
    { 232.00, 8000000, 6, 348, 2, 8, RCC_SYSCLK_DIV1, RCC_HCLK_DIV8, RCC_HCLK_DIV4, 3.625000, 0.012699 },
    { 188.50, 8000000, 8, 377, 2, 13, RCC_SYSCLK_DIV1, RCC_HCLK_DIV4, RCC_HCLK_DIV2, 3.625000, 0.012699 },
    { 203.00, 8000000, 8, 406, 2, 14, RCC_SYSCLK_DIV1, RCC_HCLK_DIV4, RCC_HCLK_DIV2, 3.625000, 0.012699 },
    { 232.00, 8000000, 7, 406, 2, 8, RCC_SYSCLK_DIV1, RCC_HCLK_DIV8, RCC_HCLK_DIV4, 3.625000, 0.012699 },
    { 212.00, 8000000, 2, 106, 2, 15, RCC_SYSCLK_DIV1, RCC_HCLK_DIV4, RCC_HCLK_DIV2, 3.533333, -0.012910 },
    { 212.00, 8000000, 2, 212, 4, 15, RCC_SYSCLK_DIV1, RCC_HCLK_DIV4, RCC_HCLK_DIV2, 3.533333, -0.012910 },
    { 212.00, 8000000, 2, 318, 6, 15, RCC_SYSCLK_DIV1, RCC_HCLK_DIV4, RCC_HCLK_DIV2, 3.533333, -0.012910 },
    { 282.67, 8000000, 2, 424, 6, 10, RCC_SYSCLK_DIV1, RCC_HCLK_DIV8, RCC_HCLK_DIV4, 3.533333, -0.012910 },
    { 212.00, 8000000, 2, 424, 8, 15, RCC_SYSCLK_DIV1, RCC_HCLK_DIV4, RCC_HCLK_DIV2, 3.533333, -0.012910 },
    { 212.00, 8000000, 3, 159, 2, 15, RCC_SYSCLK_DIV1, RCC_HCLK_DIV4, RCC_HCLK_DIV2, 3.533333, -0.012910 },
    { 212.00, 8000000, 3, 318, 4, 15, RCC_SYSCLK_DIV1, RCC_HCLK_DIV4, RCC_HCLK_DIV2, 3.533333, -0.012910 },
    { 212.00, 8000000, 4, 212, 2, 15, RCC_SYSCLK_DIV1, RCC_HCLK_DIV4, RCC_HCLK_DIV2, 3.533333, -0.012910 },
    { 212.00, 8000000, 4, 424, 4, 15, RCC_SYSCLK_DIV1, RCC_HCLK_DIV4, RCC_HCLK_DIV2, 3.533333, -0.012910 },
    { 212.00, 8000000, 5, 265, 2, 15, RCC_SYSCLK_DIV1, RCC_HCLK_DIV4, RCC_HCLK_DIV2, 3.533333, -0.012910 },
    { 254.40, 8000000, 5, 318, 2, 9, RCC_SYSCLK_DIV1, RCC_HCLK_DIV8, RCC_HCLK_DIV4, 3.533333, -0.012910 },
    { 212.00, 8000000, 6, 318, 2, 15, RCC_SYSCLK_DIV1, RCC_HCLK_DIV4, RCC_HCLK_DIV2, 3.533333, -0.012910 },
    { 212.00, 8000000, 8, 424, 2, 15, RCC_SYSCLK_DIV1, RCC_HCLK_DIV4, RCC_HCLK_DIV2, 3.533333, -0.012910 },
    { 282.67, 8000000, 3, 212, 2, 10, RCC_SYSCLK_DIV1, RCC_HCLK_DIV8, RCC_HCLK_DIV4, 3.533333, -0.012910 },
    { 282.67, 8000000, 3, 424, 4, 10, RCC_SYSCLK_DIV1, RCC_HCLK_DIV8, RCC_HCLK_DIV4, 3.533333, -0.012910 },
    { 282.67, 8000000, 6, 424, 2, 10, RCC_SYSCLK_DIV1, RCC_HCLK_DIV8, RCC_HCLK_DIV4, 3.533333, -0.012910 },
    { 188.57, 8000000, 7, 330, 2, 13, RCC_SYSCLK_DIV1, RCC_HCLK_DIV4, RCC_HCLK_DIV2, 3.626374, 0.013082 },
    { 226.00, 8000000, 2, 113, 2, 8, RCC_SYSCLK_DIV1, RCC_HCLK_DIV8, RCC_HCLK_DIV4, 3.531250, -0.013492 },
    { 226.00, 8000000, 2, 226, 4, 8, RCC_SYSCLK_DIV1, RCC_HCLK_DIV8, RCC_HCLK_DIV4, 3.531250, -0.013492 },
    { 226.00, 8000000, 2, 339, 6, 8, RCC_SYSCLK_DIV1, RCC_HCLK_DIV8, RCC_HCLK_DIV4, 3.531250, -0.013492 },
    { 226.00, 8000000, 3, 339, 4, 8, RCC_SYSCLK_DIV1, RCC_HCLK_DIV8, RCC_HCLK_DIV4, 3.531250, -0.013492 },
    { 226.00, 8000000, 4, 226, 2, 8, RCC_SYSCLK_DIV1, RCC_HCLK_DIV8, RCC_HCLK_DIV4, 3.531250, -0.013492 },
    { 226.00, 8000000, 6, 339, 2, 8, RCC_SYSCLK_DIV1, RCC_HCLK_DIV8, RCC_HCLK_DIV4, 3.531250, -0.013492 },
    { 188.67, 8000000, 2, 283, 6, 13, RCC_SYSCLK_DIV1, RCC_HCLK_DIV4, RCC_HCLK_DIV2, 3.628205, 0.013594 },
    { 188.67, 8000000, 3, 283, 4, 13, RCC_SYSCLK_DIV1, RCC_HCLK_DIV4, RCC_HCLK_DIV2, 3.628205, 0.013594 },
    { 188.67, 8000000, 6, 283, 2, 13, RCC_SYSCLK_DIV1, RCC_HCLK_DIV4, RCC_HCLK_DIV2, 3.628205, 0.013594 },
    { 197.71, 8000000, 7, 346, 2, 14, RCC_SYSCLK_DIV1, RCC_HCLK_DIV4, RCC_HCLK_DIV2, 3.530612, -0.013670 },
    { 203.20, 8000000, 5, 254, 2, 14, RCC_SYSCLK_DIV1, RCC_HCLK_DIV4, RCC_HCLK_DIV2, 3.628571, 0.013696 },
    { 282.40, 8000000, 5, 353, 2, 10, RCC_SYSCLK_DIV1, RCC_HCLK_DIV8, RCC_HCLK_DIV4, 3.530000, -0.013841 },
    { 183.56, 8000000, 3, 413, 6, 13, RCC_SYSCLK_DIV1, RCC_HCLK_DIV4, RCC_HCLK_DIV2, 3.529915, -0.013865 },
    { 183.56, 8000000, 9, 413, 2, 13, RCC_SYSCLK_DIV1, RCC_HCLK_DIV4, RCC_HCLK_DIV2, 3.529915, -0.013865 },
    { 261.33, 8000000, 3, 196, 2, 9, RCC_SYSCLK_DIV1, RCC_HCLK_DIV8, RCC_HCLK_DIV4, 3.629630, 0.013992 },
    { 261.33, 8000000, 3, 392, 4, 9, RCC_SYSCLK_DIV1, RCC_HCLK_DIV8, RCC_HCLK_DIV4, 3.629630, 0.013992 },
    { 261.33, 8000000, 6, 392, 2, 9, RCC_SYSCLK_DIV1, RCC_HCLK_DIV8, RCC_HCLK_DIV4, 3.629630, 0.013992 },
    { 261.33, 8000000, 2, 392, 6, 9, RCC_SYSCLK_DIV1, RCC_HCLK_DIV8, RCC_HCLK_DIV4, 3.629630, 0.013992 },
    { 290.40, 8000000, 5, 363, 2, 10, RCC_SYSCLK_DIV1, RCC_HCLK_DIV8, RCC_HCLK_DIV4, 3.630000, 0.014095 },
    { 183.50, 8000000, 2, 367, 8, 13, RCC_SYSCLK_DIV1, RCC_HCLK_DIV4, RCC_HCLK_DIV2, 3.528846, -0.014163 },
    { 183.50, 8000000, 4, 367, 4, 13, RCC_SYSCLK_DIV1, RCC_HCLK_DIV4, RCC_HCLK_DIV2, 3.528846, -0.014163 },
    { 183.50, 8000000, 8, 367, 2, 13, RCC_SYSCLK_DIV1, RCC_HCLK_DIV4, RCC_HCLK_DIV2, 3.528846, -0.014163 },
    { 197.60, 8000000, 5, 247, 2, 14, RCC_SYSCLK_DIV1, RCC_HCLK_DIV4, RCC_HCLK_DIV2, 3.528571, -0.014240 },
    { 188.80, 8000000, 5, 236, 2, 13, RCC_SYSCLK_DIV1, RCC_HCLK_DIV4, RCC_HCLK_DIV2, 3.630769, 0.014310 },
    { 203.33, 8000000, 3, 305, 4, 14, RCC_SYSCLK_DIV1, RCC_HCLK_DIV4, RCC_HCLK_DIV2, 3.630952, 0.014361 },
    { 203.33, 8000000, 6, 305, 2, 14, RCC_SYSCLK_DIV1, RCC_HCLK_DIV4, RCC_HCLK_DIV2, 3.630952, 0.014361 },
    { 203.33, 8000000, 2, 305, 6, 14, RCC_SYSCLK_DIV1, RCC_HCLK_DIV4, RCC_HCLK_DIV2, 3.630952, 0.014361 },
    { 254.00, 8000000, 2, 127, 2, 9, RCC_SYSCLK_DIV1, RCC_HCLK_DIV8, RCC_HCLK_DIV4, 3.527778, -0.014462 },
    { 254.00, 8000000, 2, 254, 4, 9, RCC_SYSCLK_DIV1, RCC_HCLK_DIV8, RCC_HCLK_DIV4, 3.527778, -0.014462 },
    { 254.00, 8000000, 2, 381, 6, 9, RCC_SYSCLK_DIV1, RCC_HCLK_DIV8, RCC_HCLK_DIV4, 3.527778, -0.014462 },
    { 254.00, 8000000, 3, 381, 4, 9, RCC_SYSCLK_DIV1, RCC_HCLK_DIV8, RCC_HCLK_DIV4, 3.527778, -0.014462 },
    { 254.00, 8000000, 4, 254, 2, 9, RCC_SYSCLK_DIV1, RCC_HCLK_DIV8, RCC_HCLK_DIV4, 3.527778, -0.014462 },
    { 254.00, 8000000, 6, 381, 2, 9, RCC_SYSCLK_DIV1, RCC_HCLK_DIV8, RCC_HCLK_DIV4, 3.527778, -0.014462 },
    { 183.43, 8000000, 7, 321, 2, 13, RCC_SYSCLK_DIV1, RCC_HCLK_DIV4, RCC_HCLK_DIV2, 3.527473, -0.014547 },
    { 225.71, 8000000, 7, 395, 2, 8, RCC_SYSCLK_DIV1, RCC_HCLK_DIV8, RCC_HCLK_DIV4, 3.526786, -0.014739 },
    { 197.50, 8000000, 2, 395, 8, 14, RCC_SYSCLK_DIV1, RCC_HCLK_DIV4, RCC_HCLK_DIV2, 3.526786, -0.014739 },
    { 197.50, 8000000, 4, 395, 4, 14, RCC_SYSCLK_DIV1, RCC_HCLK_DIV4, RCC_HCLK_DIV2, 3.526786, -0.014739 },
    { 197.50, 8000000, 8, 395, 2, 14, RCC_SYSCLK_DIV1, RCC_HCLK_DIV4, RCC_HCLK_DIV2, 3.526786, -0.014739 },
    { 188.89, 8000000, 3, 425, 6, 13, RCC_SYSCLK_DIV1, RCC_HCLK_DIV4, RCC_HCLK_DIV2, 3.632479, 0.014788 },
    { 188.89, 8000000, 9, 425, 2, 13, RCC_SYSCLK_DIV1, RCC_HCLK_DIV4, RCC_HCLK_DIV2, 3.632479, 0.014788 },
    { 203.43, 8000000, 7, 356, 2, 14, RCC_SYSCLK_DIV1, RCC_HCLK_DIV4, RCC_HCLK_DIV2, 3.632653, 0.014837 },
    { 290.67, 8000000, 3, 218, 2, 10, RCC_SYSCLK_DIV1, RCC_HCLK_DIV8, RCC_HCLK_DIV4, 3.633333, 0.015027 },
    { 261.60, 8000000, 5, 327, 2, 9, RCC_SYSCLK_DIV1, RCC_HCLK_DIV8, RCC_HCLK_DIV4, 3.633333, 0.015027 },
    { 183.33, 8000000, 2, 275, 6, 13, RCC_SYSCLK_DIV1, RCC_HCLK_DIV4, RCC_HCLK_DIV2, 3.525641, -0.015059 },
    { 183.33, 8000000, 3, 275, 4, 13, RCC_SYSCLK_DIV1, RCC_HCLK_DIV4, RCC_HCLK_DIV2, 3.525641, -0.015059 },
    { 183.33, 8000000, 6, 275, 2, 13, RCC_SYSCLK_DIV1, RCC_HCLK_DIV4, RCC_HCLK_DIV2, 3.525641, -0.015059 },
    { 203.50, 8000000, 2, 407, 8, 14, RCC_SYSCLK_DIV1, RCC_HCLK_DIV4, RCC_HCLK_DIV2, 3.633929, 0.015193 },
    { 203.50, 8000000, 4, 407, 4, 14, RCC_SYSCLK_DIV1, RCC_HCLK_DIV4, RCC_HCLK_DIV2, 3.633929, 0.015193 },
    { 203.50, 8000000, 8, 407, 2, 14, RCC_SYSCLK_DIV1, RCC_HCLK_DIV4, RCC_HCLK_DIV2, 3.633929, 0.015193 },
    { 232.57, 8000000, 7, 407, 2, 8, RCC_SYSCLK_DIV1, RCC_HCLK_DIV8, RCC_HCLK_DIV4, 3.633929, 0.015193 },
    { 282.00, 8000000, 2, 141, 2, 10, RCC_SYSCLK_DIV1, RCC_HCLK_DIV8, RCC_HCLK_DIV4, 3.525000, -0.015238 },
    { 282.00, 8000000, 2, 282, 4, 10, RCC_SYSCLK_DIV1, RCC_HCLK_DIV8, RCC_HCLK_DIV4, 3.525000, -0.015238 },
    { 282.00, 8000000, 2, 423, 6, 10, RCC_SYSCLK_DIV1, RCC_HCLK_DIV8, RCC_HCLK_DIV4, 3.525000, -0.015238 },
    { 211.50, 8000000, 2, 423, 8, 15, RCC_SYSCLK_DIV1, RCC_HCLK_DIV4, RCC_HCLK_DIV2, 3.525000, -0.015238 },
    { 282.00, 8000000, 3, 423, 4, 10, RCC_SYSCLK_DIV1, RCC_HCLK_DIV8, RCC_HCLK_DIV4, 3.525000, -0.015238 },
    { 282.00, 8000000, 4, 282, 2, 10, RCC_SYSCLK_DIV1, RCC_HCLK_DIV8, RCC_HCLK_DIV4, 3.525000, -0.015238 },
    { 211.50, 8000000, 4, 423, 4, 15, RCC_SYSCLK_DIV1, RCC_HCLK_DIV4, RCC_HCLK_DIV2, 3.525000, -0.015238 },
    { 225.60, 8000000, 5, 282, 2, 8, RCC_SYSCLK_DIV1, RCC_HCLK_DIV8, RCC_HCLK_DIV4, 3.525000, -0.015238 },
    { 282.00, 8000000, 6, 423, 2, 10, RCC_SYSCLK_DIV1, RCC_HCLK_DIV8, RCC_HCLK_DIV4, 3.525000, -0.015238 },
    { 211.50, 8000000, 8, 423, 2, 15, RCC_SYSCLK_DIV1, RCC_HCLK_DIV4, RCC_HCLK_DIV2, 3.525000, -0.015238 },
    { 189.00, 8000000, 2, 189, 4, 13, RCC_SYSCLK_DIV1, RCC_HCLK_DIV4, RCC_HCLK_DIV2, 3.634615, 0.015385 },
    { 189.00, 8000000, 2, 378, 8, 13, RCC_SYSCLK_DIV1, RCC_HCLK_DIV4, RCC_HCLK_DIV2, 3.634615, 0.015385 },
    { 189.00, 8000000, 4, 189, 2, 13, RCC_SYSCLK_DIV1, RCC_HCLK_DIV4, RCC_HCLK_DIV2, 3.634615, 0.015385 },
    { 189.00, 8000000, 4, 378, 4, 13, RCC_SYSCLK_DIV1, RCC_HCLK_DIV4, RCC_HCLK_DIV2, 3.634615, 0.015385 },
    { 189.00, 8000000, 8, 378, 2, 13, RCC_SYSCLK_DIV1, RCC_HCLK_DIV4, RCC_HCLK_DIV2, 3.634615, 0.015385 },
    { 197.33, 8000000, 2, 296, 6, 14, RCC_SYSCLK_DIV1, RCC_HCLK_DIV4, RCC_HCLK_DIV2, 3.523810, -0.015571 },
    { 211.43, 8000000, 7, 370, 2, 15, RCC_SYSCLK_DIV1, RCC_HCLK_DIV4, RCC_HCLK_DIV2, 3.523810, -0.015571 },
    { 197.33, 8000000, 3, 148, 2, 14, RCC_SYSCLK_DIV1, RCC_HCLK_DIV4, RCC_HCLK_DIV2, 3.523810, -0.015571 },
    { 197.33, 8000000, 3, 296, 4, 14, RCC_SYSCLK_DIV1, RCC_HCLK_DIV4, RCC_HCLK_DIV2, 3.523810, -0.015571 },
    { 197.33, 8000000, 6, 296, 2, 14, RCC_SYSCLK_DIV1, RCC_HCLK_DIV4, RCC_HCLK_DIV2, 3.523810, -0.015571 },
    { 232.67, 8000000, 2, 349, 6, 8, RCC_SYSCLK_DIV1, RCC_HCLK_DIV8, RCC_HCLK_DIV4, 3.635417, 0.015609 },
    { 232.67, 8000000, 3, 349, 4, 8, RCC_SYSCLK_DIV1, RCC_HCLK_DIV8, RCC_HCLK_DIV4, 3.635417, 0.015609 },
    { 232.67, 8000000, 6, 349, 2, 8, RCC_SYSCLK_DIV1, RCC_HCLK_DIV8, RCC_HCLK_DIV4, 3.635417, 0.015609 },
    { 183.20, 8000000, 5, 229, 2, 13, RCC_SYSCLK_DIV1, RCC_HCLK_DIV4, RCC_HCLK_DIV2, 3.523077, -0.015775 },
    { 211.33, 8000000, 2, 317, 6, 15, RCC_SYSCLK_DIV1, RCC_HCLK_DIV4, RCC_HCLK_DIV2, 3.522222, -0.016014 },
    { 211.33, 8000000, 3, 317, 4, 15, RCC_SYSCLK_DIV1, RCC_HCLK_DIV4, RCC_HCLK_DIV2, 3.522222, -0.016014 },
    { 253.60, 8000000, 5, 317, 2, 9, RCC_SYSCLK_DIV1, RCC_HCLK_DIV8, RCC_HCLK_DIV4, 3.522222, -0.016014 },
    { 211.33, 8000000, 6, 317, 2, 15, RCC_SYSCLK_DIV1, RCC_HCLK_DIV4, RCC_HCLK_DIV2, 3.522222, -0.016014 },
    { 189.14, 8000000, 7, 331, 2, 13, RCC_SYSCLK_DIV1, RCC_HCLK_DIV4, RCC_HCLK_DIV2, 3.637363, 0.016152 },
    { 291.00, 8000000, 2, 291, 4, 10, RCC_SYSCLK_DIV1, RCC_HCLK_DIV8, RCC_HCLK_DIV4, 3.637500, 0.016191 },
    { 291.00, 8000000, 4, 291, 2, 10, RCC_SYSCLK_DIV1, RCC_HCLK_DIV8, RCC_HCLK_DIV4, 3.637500, 0.016191 },
    { 232.80, 8000000, 5, 291, 2, 8, RCC_SYSCLK_DIV1, RCC_HCLK_DIV8, RCC_HCLK_DIV4, 3.637500, 0.016191 },
    { 183.11, 8000000, 9, 412, 2, 13, RCC_SYSCLK_DIV1, RCC_HCLK_DIV4, RCC_HCLK_DIV2, 3.521368, -0.016253 },
    { 183.11, 8000000, 3, 412, 6, 13, RCC_SYSCLK_DIV1, RCC_HCLK_DIV4, RCC_HCLK_DIV2, 3.521368, -0.016253 },
    { 225.33, 8000000, 2, 338, 6, 8, RCC_SYSCLK_DIV1, RCC_HCLK_DIV8, RCC_HCLK_DIV4, 3.520833, -0.016402 },
    { 225.33, 8000000, 3, 169, 2, 8, RCC_SYSCLK_DIV1, RCC_HCLK_DIV8, RCC_HCLK_DIV4, 3.520833, -0.016402 },
    { 225.33, 8000000, 3, 338, 4, 8, RCC_SYSCLK_DIV1, RCC_HCLK_DIV8, RCC_HCLK_DIV4, 3.520833, -0.016402 },
    { 225.33, 8000000, 6, 338, 2, 8, RCC_SYSCLK_DIV1, RCC_HCLK_DIV8, RCC_HCLK_DIV4, 3.520833, -0.016402 },
    { 197.14, 8000000, 7, 345, 2, 14, RCC_SYSCLK_DIV1, RCC_HCLK_DIV4, RCC_HCLK_DIV2, 3.520408, -0.016521 },
    { 262.00, 8000000, 3, 393, 4, 9, RCC_SYSCLK_DIV1, RCC_HCLK_DIV8, RCC_HCLK_DIV4, 3.638889, 0.016579 },
    { 262.00, 8000000, 6, 393, 2, 9, RCC_SYSCLK_DIV1, RCC_HCLK_DIV8, RCC_HCLK_DIV4, 3.638889, 0.016579 },
    { 262.00, 8000000, 2, 131, 2, 9, RCC_SYSCLK_DIV1, RCC_HCLK_DIV8, RCC_HCLK_DIV4, 3.638889, 0.016579 },
    { 262.00, 8000000, 2, 262, 4, 9, RCC_SYSCLK_DIV1, RCC_HCLK_DIV8, RCC_HCLK_DIV4, 3.638889, 0.016579 },
    { 262.00, 8000000, 2, 393, 6, 9, RCC_SYSCLK_DIV1, RCC_HCLK_DIV8, RCC_HCLK_DIV4, 3.638889, 0.016579 },
    { 262.00, 8000000, 4, 262, 2, 9, RCC_SYSCLK_DIV1, RCC_HCLK_DIV8, RCC_HCLK_DIV4, 3.638889, 0.016579 },
    { 211.20, 8000000, 5, 264, 2, 15, RCC_SYSCLK_DIV1, RCC_HCLK_DIV4, RCC_HCLK_DIV2, 3.520000, -0.016635 },
    { 281.60, 8000000, 5, 352, 2, 10, RCC_SYSCLK_DIV1, RCC_HCLK_DIV8, RCC_HCLK_DIV4, 3.520000, -0.016635 },
    { 183.00, 8000000, 2, 183, 4, 13, RCC_SYSCLK_DIV1, RCC_HCLK_DIV4, RCC_HCLK_DIV2, 3.519231, -0.016850 },
    { 183.00, 8000000, 2, 366, 8, 13, RCC_SYSCLK_DIV1, RCC_HCLK_DIV4, RCC_HCLK_DIV2, 3.519231, -0.016850 },
    { 183.00, 8000000, 4, 183, 2, 13, RCC_SYSCLK_DIV1, RCC_HCLK_DIV4, RCC_HCLK_DIV2, 3.519231, -0.016850 },
    { 183.00, 8000000, 4, 366, 4, 13, RCC_SYSCLK_DIV1, RCC_HCLK_DIV4, RCC_HCLK_DIV2, 3.519231, -0.016850 },
    { 183.00, 8000000, 8, 366, 2, 13, RCC_SYSCLK_DIV1, RCC_HCLK_DIV4, RCC_HCLK_DIV2, 3.519231, -0.016850 },
    { 291.20, 8000000, 5, 364, 2, 10, RCC_SYSCLK_DIV1, RCC_HCLK_DIV8, RCC_HCLK_DIV4, 3.640000, 0.016889 },
    { 253.33, 8000000, 2, 380, 6, 9, RCC_SYSCLK_DIV1, RCC_HCLK_DIV8, RCC_HCLK_DIV4, 3.518519, -0.017049 },
    { 253.33, 8000000, 3, 190, 2, 9, RCC_SYSCLK_DIV1, RCC_HCLK_DIV8, RCC_HCLK_DIV4, 3.518519, -0.017049 },
    { 253.33, 8000000, 3, 380, 4, 9, RCC_SYSCLK_DIV1, RCC_HCLK_DIV8, RCC_HCLK_DIV4, 3.518519, -0.017049 },
    { 253.33, 8000000, 6, 380, 2, 9, RCC_SYSCLK_DIV1, RCC_HCLK_DIV8, RCC_HCLK_DIV4, 3.518519, -0.017049 },
    { 233.00, 8000000, 2, 233, 4, 8, RCC_SYSCLK_DIV1, RCC_HCLK_DIV8, RCC_HCLK_DIV4, 3.640625, 0.017064 },
    { 233.00, 8000000, 4, 233, 2, 8, RCC_SYSCLK_DIV1, RCC_HCLK_DIV8, RCC_HCLK_DIV4, 3.640625, 0.017064 },
    { 189.33, 8000000, 3, 142, 2, 13, RCC_SYSCLK_DIV1, RCC_HCLK_DIV4, RCC_HCLK_DIV2, 3.641026, 0.017176 },
    { 189.33, 8000000, 3, 284, 4, 13, RCC_SYSCLK_DIV1, RCC_HCLK_DIV4, RCC_HCLK_DIV2, 3.641026, 0.017176 },
    { 189.33, 8000000, 6, 284, 2, 13, RCC_SYSCLK_DIV1, RCC_HCLK_DIV4, RCC_HCLK_DIV2, 3.641026, 0.017176 },
    { 189.33, 8000000, 2, 284, 6, 13, RCC_SYSCLK_DIV1, RCC_HCLK_DIV4, RCC_HCLK_DIV2, 3.641026, 0.017176 },
    { 189.33, 8000000, 3, 426, 6, 13, RCC_SYSCLK_DIV1, RCC_HCLK_DIV4, RCC_HCLK_DIV2, 3.641026, 0.017176 },
    { 189.33, 8000000, 9, 426, 2, 13, RCC_SYSCLK_DIV1, RCC_HCLK_DIV4, RCC_HCLK_DIV2, 3.641026, 0.017176 },
    { 225.14, 8000000, 7, 394, 2, 8, RCC_SYSCLK_DIV1, RCC_HCLK_DIV8, RCC_HCLK_DIV4, 3.517857, -0.017233 },
    { 197.00, 8000000, 2, 197, 4, 14, RCC_SYSCLK_DIV1, RCC_HCLK_DIV4, RCC_HCLK_DIV2, 3.517857, -0.017233 },
    { 197.00, 8000000, 2, 394, 8, 14, RCC_SYSCLK_DIV1, RCC_HCLK_DIV4, RCC_HCLK_DIV2, 3.517857, -0.017233 },
    { 197.00, 8000000, 4, 197, 2, 14, RCC_SYSCLK_DIV1, RCC_HCLK_DIV4, RCC_HCLK_DIV2, 3.517857, -0.017233 },
    { 197.00, 8000000, 4, 394, 4, 14, RCC_SYSCLK_DIV1, RCC_HCLK_DIV4, RCC_HCLK_DIV2, 3.517857, -0.017233 },
    { 197.00, 8000000, 8, 394, 2, 14, RCC_SYSCLK_DIV1, RCC_HCLK_DIV4, RCC_HCLK_DIV2, 3.517857, -0.017233 },
    { 211.00, 8000000, 2, 211, 4, 15, RCC_SYSCLK_DIV1, RCC_HCLK_DIV4, RCC_HCLK_DIV2, 3.516667, -0.017566 },
    { 281.33, 8000000, 2, 422, 6, 10, RCC_SYSCLK_DIV1, RCC_HCLK_DIV8, RCC_HCLK_DIV4, 3.516667, -0.017566 },
    { 211.00, 8000000, 2, 422, 8, 15, RCC_SYSCLK_DIV1, RCC_HCLK_DIV4, RCC_HCLK_DIV2, 3.516667, -0.017566 },
    { 281.33, 8000000, 3, 211, 2, 10, RCC_SYSCLK_DIV1, RCC_HCLK_DIV8, RCC_HCLK_DIV4, 3.516667, -0.017566 },
    { 281.33, 8000000, 3, 422, 4, 10, RCC_SYSCLK_DIV1, RCC_HCLK_DIV8, RCC_HCLK_DIV4, 3.516667, -0.017566 },
    { 211.00, 8000000, 4, 211, 2, 15, RCC_SYSCLK_DIV1, RCC_HCLK_DIV4, RCC_HCLK_DIV2, 3.516667, -0.017566 },
    { 211.00, 8000000, 4, 422, 4, 15, RCC_SYSCLK_DIV1, RCC_HCLK_DIV4, RCC_HCLK_DIV2, 3.516667, -0.017566 },
    { 281.33, 8000000, 6, 422, 2, 10, RCC_SYSCLK_DIV1, RCC_HCLK_DIV8, RCC_HCLK_DIV4, 3.516667, -0.017566 },
    { 211.00, 8000000, 8, 422, 2, 15, RCC_SYSCLK_DIV1, RCC_HCLK_DIV4, RCC_HCLK_DIV2, 3.516667, -0.017566 },
    { 182.86, 8000000, 7, 320, 2, 13, RCC_SYSCLK_DIV1, RCC_HCLK_DIV4, RCC_HCLK_DIV2, 3.516484, -0.017617 },
    { 204.00, 8000000, 2, 102, 2, 14, RCC_SYSCLK_DIV1, RCC_HCLK_DIV4, RCC_HCLK_DIV2, 3.642857, 0.017687 },
    { 204.00, 8000000, 2, 204, 4, 14, RCC_SYSCLK_DIV1, RCC_HCLK_DIV4, RCC_HCLK_DIV2, 3.642857, 0.017687 },
    { 204.00, 8000000, 2, 306, 6, 14, RCC_SYSCLK_DIV1, RCC_HCLK_DIV4, RCC_HCLK_DIV2, 3.642857, 0.017687 },
    { 204.00, 8000000, 2, 408, 8, 14, RCC_SYSCLK_DIV1, RCC_HCLK_DIV4, RCC_HCLK_DIV2, 3.642857, 0.017687 },
    { 204.00, 8000000, 3, 153, 2, 14, RCC_SYSCLK_DIV1, RCC_HCLK_DIV4, RCC_HCLK_DIV2, 3.642857, 0.017687 },
    { 204.00, 8000000, 3, 306, 4, 14, RCC_SYSCLK_DIV1, RCC_HCLK_DIV4, RCC_HCLK_DIV2, 3.642857, 0.017687 },
    { 204.00, 8000000, 4, 204, 2, 14, RCC_SYSCLK_DIV1, RCC_HCLK_DIV4, RCC_HCLK_DIV2, 3.642857, 0.017687 },
    { 204.00, 8000000, 4, 408, 4, 14, RCC_SYSCLK_DIV1, RCC_HCLK_DIV4, RCC_HCLK_DIV2, 3.642857, 0.017687 },
    { 204.00, 8000000, 5, 255, 2, 14, RCC_SYSCLK_DIV1, RCC_HCLK_DIV4, RCC_HCLK_DIV2, 3.642857, 0.017687 },
    { 204.00, 8000000, 6, 306, 2, 14, RCC_SYSCLK_DIV1, RCC_HCLK_DIV4, RCC_HCLK_DIV2, 3.642857, 0.017687 },
    { 204.00, 8000000, 8, 408, 2, 14, RCC_SYSCLK_DIV1, RCC_HCLK_DIV4, RCC_HCLK_DIV2, 3.642857, 0.017687 },
    { 204.00, 8000000, 7, 357, 2, 14, RCC_SYSCLK_DIV1, RCC_HCLK_DIV4, RCC_HCLK_DIV2, 3.642857, 0.017687 },
    { 233.14, 8000000, 7, 408, 2, 8, RCC_SYSCLK_DIV1, RCC_HCLK_DIV8, RCC_HCLK_DIV4, 3.642857, 0.017687 },
    { 225.00, 8000000, 2, 225, 4, 8, RCC_SYSCLK_DIV1, RCC_HCLK_DIV8, RCC_HCLK_DIV4, 3.515625, -0.017857 },
    { 225.00, 8000000, 4, 225, 2, 8, RCC_SYSCLK_DIV1, RCC_HCLK_DIV8, RCC_HCLK_DIV4, 3.515625, -0.017857 },
    { 189.50, 8000000, 2, 379, 8, 13, RCC_SYSCLK_DIV1, RCC_HCLK_DIV4, RCC_HCLK_DIV2, 3.644231, 0.018071 },
    { 189.50, 8000000, 4, 379, 4, 13, RCC_SYSCLK_DIV1, RCC_HCLK_DIV4, RCC_HCLK_DIV2, 3.644231, 0.018071 },
    { 189.50, 8000000, 8, 379, 2, 13, RCC_SYSCLK_DIV1, RCC_HCLK_DIV4, RCC_HCLK_DIV2, 3.644231, 0.018071 },
    { 262.40, 8000000, 5, 328, 2, 9, RCC_SYSCLK_DIV1, RCC_HCLK_DIV8, RCC_HCLK_DIV4, 3.644444, 0.018131 },
    { 210.86, 8000000, 7, 369, 2, 15, RCC_SYSCLK_DIV1, RCC_HCLK_DIV4, RCC_HCLK_DIV2, 3.514286, -0.018231 },
    { 196.80, 8000000, 5, 246, 2, 14, RCC_SYSCLK_DIV1, RCC_HCLK_DIV4, RCC_HCLK_DIV2, 3.514286, -0.018231 },
    { 253.00, 8000000, 2, 253, 4, 9, RCC_SYSCLK_DIV1, RCC_HCLK_DIV8, RCC_HCLK_DIV4, 3.513889, -0.018342 },
    { 253.00, 8000000, 4, 253, 2, 9, RCC_SYSCLK_DIV1, RCC_HCLK_DIV8, RCC_HCLK_DIV4, 3.513889, -0.018342 },
    { 233.33, 8000000, 3, 175, 2, 8, RCC_SYSCLK_DIV1, RCC_HCLK_DIV8, RCC_HCLK_DIV4, 3.645833, 0.018519 },
    { 233.33, 8000000, 3, 350, 4, 8, RCC_SYSCLK_DIV1, RCC_HCLK_DIV8, RCC_HCLK_DIV4, 3.645833, 0.018519 },
    { 233.33, 8000000, 6, 350, 2, 8, RCC_SYSCLK_DIV1, RCC_HCLK_DIV8, RCC_HCLK_DIV4, 3.645833, 0.018519 },
    { 233.33, 8000000, 2, 350, 6, 8, RCC_SYSCLK_DIV1, RCC_HCLK_DIV8, RCC_HCLK_DIV4, 3.645833, 0.018519 },
    { 189.60, 8000000, 5, 237, 2, 13, RCC_SYSCLK_DIV1, RCC_HCLK_DIV4, RCC_HCLK_DIV2, 3.646154, 0.018608 },
    { 182.67, 8000000, 2, 274, 6, 13, RCC_SYSCLK_DIV1, RCC_HCLK_DIV4, RCC_HCLK_DIV2, 3.512821, -0.018640 },
    { 182.67, 8000000, 3, 137, 2, 13, RCC_SYSCLK_DIV1, RCC_HCLK_DIV4, RCC_HCLK_DIV2, 3.512821, -0.018640 },
    { 182.67, 8000000, 3, 274, 4, 13, RCC_SYSCLK_DIV1, RCC_HCLK_DIV4, RCC_HCLK_DIV2, 3.512821, -0.018640 },
    { 182.67, 8000000, 3, 411, 6, 13, RCC_SYSCLK_DIV1, RCC_HCLK_DIV4, RCC_HCLK_DIV2, 3.512821, -0.018640 },
    { 182.67, 8000000, 6, 274, 2, 13, RCC_SYSCLK_DIV1, RCC_HCLK_DIV4, RCC_HCLK_DIV2, 3.512821, -0.018640 },
    { 182.67, 8000000, 9, 411, 2, 13, RCC_SYSCLK_DIV1, RCC_HCLK_DIV4, RCC_HCLK_DIV2, 3.512821, -0.018640 },
    { 281.00, 8000000, 2, 281, 4, 10, RCC_SYSCLK_DIV1, RCC_HCLK_DIV8, RCC_HCLK_DIV4, 3.512500, -0.018730 },
    { 281.00, 8000000, 4, 281, 2, 10, RCC_SYSCLK_DIV1, RCC_HCLK_DIV8, RCC_HCLK_DIV4, 3.512500, -0.018730 },
    { 224.80, 8000000, 5, 281, 2, 8, RCC_SYSCLK_DIV1, RCC_HCLK_DIV8, RCC_HCLK_DIV4, 3.512500, -0.018730 },
    { 196.67, 8000000, 2, 295, 6, 14, RCC_SYSCLK_DIV1, RCC_HCLK_DIV4, RCC_HCLK_DIV2, 3.511905, -0.018896 },
    { 196.67, 8000000, 3, 295, 4, 14, RCC_SYSCLK_DIV1, RCC_HCLK_DIV4, RCC_HCLK_DIV2, 3.511905, -0.018896 },
    { 196.67, 8000000, 6, 295, 2, 14, RCC_SYSCLK_DIV1, RCC_HCLK_DIV4, RCC_HCLK_DIV2, 3.511905, -0.018896 },
    { 210.67, 8000000, 2, 316, 6, 15, RCC_SYSCLK_DIV1, RCC_HCLK_DIV4, RCC_HCLK_DIV2, 3.511111, -0.019118 },
    { 210.67, 8000000, 3, 158, 2, 15, RCC_SYSCLK_DIV1, RCC_HCLK_DIV4, RCC_HCLK_DIV2, 3.511111, -0.019118 },
    { 210.67, 8000000, 3, 316, 4, 15, RCC_SYSCLK_DIV1, RCC_HCLK_DIV4, RCC_HCLK_DIV2, 3.511111, -0.019118 },
    { 252.80, 8000000, 5, 316, 2, 9, RCC_SYSCLK_DIV1, RCC_HCLK_DIV8, RCC_HCLK_DIV4, 3.511111, -0.019118 },
    { 210.67, 8000000, 6, 316, 2, 15, RCC_SYSCLK_DIV1, RCC_HCLK_DIV4, RCC_HCLK_DIV2, 3.511111, -0.019118 },
    { 262.67, 8000000, 2, 394, 6, 9, RCC_SYSCLK_DIV1, RCC_HCLK_DIV8, RCC_HCLK_DIV4, 3.648148, 0.019165 },
    { 262.67, 8000000, 3, 197, 2, 9, RCC_SYSCLK_DIV1, RCC_HCLK_DIV8, RCC_HCLK_DIV4, 3.648148, 0.019165 },
    { 262.67, 8000000, 3, 394, 4, 9, RCC_SYSCLK_DIV1, RCC_HCLK_DIV8, RCC_HCLK_DIV4, 3.648148, 0.019165 },
    { 262.67, 8000000, 6, 394, 2, 9, RCC_SYSCLK_DIV1, RCC_HCLK_DIV8, RCC_HCLK_DIV4, 3.648148, 0.019165 },
    { 189.71, 8000000, 7, 332, 2, 13, RCC_SYSCLK_DIV1, RCC_HCLK_DIV4, RCC_HCLK_DIV2, 3.648352, 0.019222 },
    { 224.67, 8000000, 2, 337, 6, 8, RCC_SYSCLK_DIV1, RCC_HCLK_DIV8, RCC_HCLK_DIV4, 3.510417, -0.019312 },
    { 224.67, 8000000, 3, 337, 4, 8, RCC_SYSCLK_DIV1, RCC_HCLK_DIV8, RCC_HCLK_DIV4, 3.510417, -0.019312 },
    { 224.67, 8000000, 6, 337, 2, 8, RCC_SYSCLK_DIV1, RCC_HCLK_DIV8, RCC_HCLK_DIV4, 3.510417, -0.019312 },
    { 196.57, 8000000, 7, 344, 2, 14, RCC_SYSCLK_DIV1, RCC_HCLK_DIV4, RCC_HCLK_DIV2, 3.510204, -0.019371 },
    { 280.80, 8000000, 5, 351, 2, 10, RCC_SYSCLK_DIV1, RCC_HCLK_DIV8, RCC_HCLK_DIV4, 3.510000, -0.019428 },
    { 182.50, 8000000, 2, 365, 8, 13, RCC_SYSCLK_DIV1, RCC_HCLK_DIV4, RCC_HCLK_DIV2, 3.509615, -0.019536 },
    { 182.50, 8000000, 4, 365, 4, 13, RCC_SYSCLK_DIV1, RCC_HCLK_DIV4, RCC_HCLK_DIV2, 3.509615, -0.019536 },
    { 182.50, 8000000, 8, 365, 2, 13, RCC_SYSCLK_DIV1, RCC_HCLK_DIV4, RCC_HCLK_DIV2, 3.509615, -0.019536 },
    { 189.78, 8000000, 3, 427, 6, 13, RCC_SYSCLK_DIV1, RCC_HCLK_DIV4, RCC_HCLK_DIV2, 3.649573, 0.019563 },
    { 189.78, 8000000, 9, 427, 2, 13, RCC_SYSCLK_DIV1, RCC_HCLK_DIV4, RCC_HCLK_DIV2, 3.649573, 0.019563 },
    { 252.67, 8000000, 2, 379, 6, 9, RCC_SYSCLK_DIV1, RCC_HCLK_DIV8, RCC_HCLK_DIV4, 3.509259, -0.019635 },
    { 252.67, 8000000, 3, 379, 4, 9, RCC_SYSCLK_DIV1, RCC_HCLK_DIV8, RCC_HCLK_DIV4, 3.509259, -0.019635 },
    { 252.67, 8000000, 6, 379, 2, 9, RCC_SYSCLK_DIV1, RCC_HCLK_DIV8, RCC_HCLK_DIV4, 3.509259, -0.019635 },
    { 292.00, 8000000, 2, 146, 2, 10, RCC_SYSCLK_DIV1, RCC_HCLK_DIV8, RCC_HCLK_DIV4, 3.650000, 0.019683 },
    { 292.00, 8000000, 2, 292, 4, 10, RCC_SYSCLK_DIV1, RCC_HCLK_DIV8, RCC_HCLK_DIV4, 3.650000, 0.019683 },
    { 292.00, 8000000, 3, 219, 2, 10, RCC_SYSCLK_DIV1, RCC_HCLK_DIV8, RCC_HCLK_DIV4, 3.650000, 0.019683 },
    { 292.00, 8000000, 4, 292, 2, 10, RCC_SYSCLK_DIV1, RCC_HCLK_DIV8, RCC_HCLK_DIV4, 3.650000, 0.019683 },
    { 233.60, 8000000, 5, 292, 2, 8, RCC_SYSCLK_DIV1, RCC_HCLK_DIV8, RCC_HCLK_DIV4, 3.650000, 0.019683 },
    { 292.00, 8000000, 5, 365, 2, 10, RCC_SYSCLK_DIV1, RCC_HCLK_DIV8, RCC_HCLK_DIV4, 3.650000, 0.019683 },
    { 224.57, 8000000, 7, 393, 2, 8, RCC_SYSCLK_DIV1, RCC_HCLK_DIV8, RCC_HCLK_DIV4, 3.508929, -0.019728 },
    { 196.50, 8000000, 2, 393, 8, 14, RCC_SYSCLK_DIV1, RCC_HCLK_DIV4, RCC_HCLK_DIV2, 3.508929, -0.019728 },
    { 196.50, 8000000, 4, 393, 4, 14, RCC_SYSCLK_DIV1, RCC_HCLK_DIV4, RCC_HCLK_DIV2, 3.508929, -0.019728 },
    { 196.50, 8000000, 8, 393, 2, 14, RCC_SYSCLK_DIV1, RCC_HCLK_DIV4, RCC_HCLK_DIV2, 3.508929, -0.019728 },
    { 280.67, 8000000, 2, 421, 6, 10, RCC_SYSCLK_DIV1, RCC_HCLK_DIV8, RCC_HCLK_DIV4, 3.508333, -0.019894 },
    { 210.50, 8000000, 2, 421, 8, 15, RCC_SYSCLK_DIV1, RCC_HCLK_DIV4, RCC_HCLK_DIV2, 3.508333, -0.019894 },
    { 210.50, 8000000, 4, 421, 4, 15, RCC_SYSCLK_DIV1, RCC_HCLK_DIV4, RCC_HCLK_DIV2, 3.508333, -0.019894 },
    { 210.50, 8000000, 8, 421, 2, 15, RCC_SYSCLK_DIV1, RCC_HCLK_DIV4, RCC_HCLK_DIV2, 3.508333, -0.019894 },
    { 280.67, 8000000, 3, 421, 4, 10, RCC_SYSCLK_DIV1, RCC_HCLK_DIV8, RCC_HCLK_DIV4, 3.508333, -0.019894 },
    { 280.67, 8000000, 6, 421, 2, 10, RCC_SYSCLK_DIV1, RCC_HCLK_DIV8, RCC_HCLK_DIV4, 3.508333, -0.019894 },
    { 182.40, 8000000, 5, 228, 2, 13, RCC_SYSCLK_DIV1, RCC_HCLK_DIV4, RCC_HCLK_DIV2, 3.507692, -0.020073 },
    { 204.50, 8000000, 2, 409, 8, 14, RCC_SYSCLK_DIV1, RCC_HCLK_DIV4, RCC_HCLK_DIV2, 3.651786, 0.020182 },
    { 204.50, 8000000, 4, 409, 4, 14, RCC_SYSCLK_DIV1, RCC_HCLK_DIV4, RCC_HCLK_DIV2, 3.651786, 0.020182 },
    { 204.50, 8000000, 8, 409, 2, 14, RCC_SYSCLK_DIV1, RCC_HCLK_DIV4, RCC_HCLK_DIV2, 3.651786, 0.020182 },
    { 233.71, 8000000, 7, 409, 2, 8, RCC_SYSCLK_DIV1, RCC_HCLK_DIV8, RCC_HCLK_DIV4, 3.651786, 0.020182 },
    { 210.40, 8000000, 5, 263, 2, 15, RCC_SYSCLK_DIV1, RCC_HCLK_DIV4, RCC_HCLK_DIV2, 3.506667, -0.020360 },
    { 263.00, 8000000, 2, 263, 4, 9, RCC_SYSCLK_DIV1, RCC_HCLK_DIV8, RCC_HCLK_DIV4, 3.652778, 0.020459 },
    { 263.00, 8000000, 4, 263, 2, 9, RCC_SYSCLK_DIV1, RCC_HCLK_DIV8, RCC_HCLK_DIV4, 3.652778, 0.020459 },
    { 204.57, 8000000, 7, 358, 2, 14, RCC_SYSCLK_DIV1, RCC_HCLK_DIV4, RCC_HCLK_DIV2, 3.653061, 0.020538 },
    { 182.29, 8000000, 7, 319, 2, 13, RCC_SYSCLK_DIV1, RCC_HCLK_DIV4, RCC_HCLK_DIV2, 3.505495, -0.020687 },
    { 190.00, 8000000, 2, 95, 2, 13, RCC_SYSCLK_DIV1, RCC_HCLK_DIV4, RCC_HCLK_DIV2, 3.653846, 0.020757 },
    { 190.00, 8000000, 2, 190, 4, 13, RCC_SYSCLK_DIV1, RCC_HCLK_DIV4, RCC_HCLK_DIV2, 3.653846, 0.020757 },
    { 190.00, 8000000, 2, 285, 6, 13, RCC_SYSCLK_DIV1, RCC_HCLK_DIV4, RCC_HCLK_DIV2, 3.653846, 0.020757 },
    { 190.00, 8000000, 2, 380, 8, 13, RCC_SYSCLK_DIV1, RCC_HCLK_DIV4, RCC_HCLK_DIV2, 3.653846, 0.020757 },
    { 190.00, 8000000, 3, 285, 4, 13, RCC_SYSCLK_DIV1, RCC_HCLK_DIV4, RCC_HCLK_DIV2, 3.653846, 0.020757 },
    { 190.00, 8000000, 4, 190, 2, 13, RCC_SYSCLK_DIV1, RCC_HCLK_DIV4, RCC_HCLK_DIV2, 3.653846, 0.020757 },
    { 190.00, 8000000, 4, 380, 4, 13, RCC_SYSCLK_DIV1, RCC_HCLK_DIV4, RCC_HCLK_DIV2, 3.653846, 0.020757 },
    { 190.00, 8000000, 6, 285, 2, 13, RCC_SYSCLK_DIV1, RCC_HCLK_DIV4, RCC_HCLK_DIV2, 3.653846, 0.020757 },
    { 190.00, 8000000, 8, 380, 2, 13, RCC_SYSCLK_DIV1, RCC_HCLK_DIV4, RCC_HCLK_DIV2, 3.653846, 0.020757 },
    { 210.29, 8000000, 7, 368, 2, 15, RCC_SYSCLK_DIV1, RCC_HCLK_DIV4, RCC_HCLK_DIV2, 3.504762, -0.020892 },
    { 204.67, 8000000, 2, 307, 6, 14, RCC_SYSCLK_DIV1, RCC_HCLK_DIV4, RCC_HCLK_DIV2, 3.654762, 0.021013 },
    { 204.67, 8000000, 3, 307, 4, 14, RCC_SYSCLK_DIV1, RCC_HCLK_DIV4, RCC_HCLK_DIV2, 3.654762, 0.021013 },
    { 204.67, 8000000, 6, 307, 2, 14, RCC_SYSCLK_DIV1, RCC_HCLK_DIV4, RCC_HCLK_DIV2, 3.654762, 0.021013 },
    { 182.22, 8000000, 3, 410, 6, 13, RCC_SYSCLK_DIV1, RCC_HCLK_DIV4, RCC_HCLK_DIV2, 3.504274, -0.021028 },
    { 182.22, 8000000, 9, 410, 2, 13, RCC_SYSCLK_DIV1, RCC_HCLK_DIV4, RCC_HCLK_DIV2, 3.504274, -0.021028 },
    { 263.20, 8000000, 5, 329, 2, 9, RCC_SYSCLK_DIV1, RCC_HCLK_DIV8, RCC_HCLK_DIV4, 3.655556, 0.021235 },
    { 234.00, 8000000, 2, 117, 2, 8, RCC_SYSCLK_DIV1, RCC_HCLK_DIV8, RCC_HCLK_DIV4, 3.656250, 0.021429 },
    { 234.00, 8000000, 2, 234, 4, 8, RCC_SYSCLK_DIV1, RCC_HCLK_DIV8, RCC_HCLK_DIV4, 3.656250, 0.021429 },
    { 234.00, 8000000, 2, 351, 6, 8, RCC_SYSCLK_DIV1, RCC_HCLK_DIV8, RCC_HCLK_DIV4, 3.656250, 0.021429 },
    { 234.00, 8000000, 3, 351, 4, 8, RCC_SYSCLK_DIV1, RCC_HCLK_DIV8, RCC_HCLK_DIV4, 3.656250, 0.021429 },
    { 234.00, 8000000, 4, 234, 2, 8, RCC_SYSCLK_DIV1, RCC_HCLK_DIV8, RCC_HCLK_DIV4, 3.656250, 0.021429 },
    { 234.00, 8000000, 6, 351, 2, 8, RCC_SYSCLK_DIV1, RCC_HCLK_DIV8, RCC_HCLK_DIV4, 3.656250, 0.021429 },
    { 204.80, 8000000, 5, 256, 2, 14, RCC_SYSCLK_DIV1, RCC_HCLK_DIV4, RCC_HCLK_DIV2, 3.657143, 0.021678 },
    { 263.33, 8000000, 3, 395, 4, 9, RCC_SYSCLK_DIV1, RCC_HCLK_DIV8, RCC_HCLK_DIV4, 3.657407, 0.021752 },
    { 263.33, 8000000, 6, 395, 2, 9, RCC_SYSCLK_DIV1, RCC_HCLK_DIV8, RCC_HCLK_DIV4, 3.657407, 0.021752 },
    { 263.33, 8000000, 2, 395, 6, 9, RCC_SYSCLK_DIV1, RCC_HCLK_DIV8, RCC_HCLK_DIV4, 3.657407, 0.021752 },
    { 190.22, 8000000, 3, 428, 6, 13, RCC_SYSCLK_DIV1, RCC_HCLK_DIV4, RCC_HCLK_DIV2, 3.658120, 0.021951 },
    { 190.22, 8000000, 9, 428, 2, 13, RCC_SYSCLK_DIV1, RCC_HCLK_DIV4, RCC_HCLK_DIV2, 3.658120, 0.021951 },
    { 196.00, 8000000, 7, 343, 2, 14, RCC_SYSCLK_DIV1, RCC_HCLK_DIV4, RCC_HCLK_DIV2, 3.500000, -0.022222 },
    { 224.00, 8000000, 7, 392, 2, 8, RCC_SYSCLK_DIV1, RCC_HCLK_DIV8, RCC_HCLK_DIV4, 3.500000, -0.022222 },
    { 182.00, 8000000, 2, 91, 2, 13, RCC_SYSCLK_DIV1, RCC_HCLK_DIV4, RCC_HCLK_DIV2, 3.500000, -0.022222 },
    { 196.00, 8000000, 2, 98, 2, 14, RCC_SYSCLK_DIV1, RCC_HCLK_DIV4, RCC_HCLK_DIV2, 3.500000, -0.022222 },
    { 210.00, 8000000, 2, 105, 2, 15, RCC_SYSCLK_DIV1, RCC_HCLK_DIV4, RCC_HCLK_DIV2, 3.500000, -0.022222 },
    { 224.00, 8000000, 2, 112, 2, 8, RCC_SYSCLK_DIV1, RCC_HCLK_DIV8, RCC_HCLK_DIV4, 3.500000, -0.022222 },
    { 252.00, 8000000, 2, 126, 2, 9, RCC_SYSCLK_DIV1, RCC_HCLK_DIV8, RCC_HCLK_DIV4, 3.500000, -0.022222 },
    { 280.00, 8000000, 2, 140, 2, 10, RCC_SYSCLK_DIV1, RCC_HCLK_DIV8, RCC_HCLK_DIV4, 3.500000, -0.022222 },
    { 182.00, 8000000, 2, 182, 4, 13, RCC_SYSCLK_DIV1, RCC_HCLK_DIV4, RCC_HCLK_DIV2, 3.500000, -0.022222 },
    { 196.00, 8000000, 2, 196, 4, 14, RCC_SYSCLK_DIV1, RCC_HCLK_DIV4, RCC_HCLK_DIV2, 3.500000, -0.022222 },
    { 210.00, 8000000, 2, 210, 4, 15, RCC_SYSCLK_DIV1, RCC_HCLK_DIV4, RCC_HCLK_DIV2, 3.500000, -0.022222 },
    { 224.00, 8000000, 2, 224, 4, 8, RCC_SYSCLK_DIV1, RCC_HCLK_DIV8, RCC_HCLK_DIV4, 3.500000, -0.022222 },
    { 252.00, 8000000, 2, 252, 4, 9, RCC_SYSCLK_DIV1, RCC_HCLK_DIV8, RCC_HCLK_DIV4, 3.500000, -0.022222 },
    { 182.00, 8000000, 2, 273, 6, 13, RCC_SYSCLK_DIV1, RCC_HCLK_DIV4, RCC_HCLK_DIV2, 3.500000, -0.022222 },
    { 280.00, 8000000, 2, 280, 4, 10, RCC_SYSCLK_DIV1, RCC_HCLK_DIV8, RCC_HCLK_DIV4, 3.500000, -0.022222 },
    { 196.00, 8000000, 2, 294, 6, 14, RCC_SYSCLK_DIV1, RCC_HCLK_DIV4, RCC_HCLK_DIV2, 3.500000, -0.022222 },
    { 210.00, 8000000, 2, 315, 6, 15, RCC_SYSCLK_DIV1, RCC_HCLK_DIV4, RCC_HCLK_DIV2, 3.500000, -0.022222 },
    { 224.00, 8000000, 2, 336, 6, 8, RCC_SYSCLK_DIV1, RCC_HCLK_DIV8, RCC_HCLK_DIV4, 3.500000, -0.022222 },
    { 182.00, 8000000, 2, 364, 8, 13, RCC_SYSCLK_DIV1, RCC_HCLK_DIV4, RCC_HCLK_DIV2, 3.500000, -0.022222 },
    { 252.00, 8000000, 2, 378, 6, 9, RCC_SYSCLK_DIV1, RCC_HCLK_DIV8, RCC_HCLK_DIV4, 3.500000, -0.022222 },
    { 196.00, 8000000, 2, 392, 8, 14, RCC_SYSCLK_DIV1, RCC_HCLK_DIV4, RCC_HCLK_DIV2, 3.500000, -0.022222 },
    { 280.00, 8000000, 2, 420, 6, 10, RCC_SYSCLK_DIV1, RCC_HCLK_DIV8, RCC_HCLK_DIV4, 3.500000, -0.022222 },
    { 210.00, 8000000, 2, 420, 8, 15, RCC_SYSCLK_DIV1, RCC_HCLK_DIV4, RCC_HCLK_DIV2, 3.500000, -0.022222 },
    { 196.00, 8000000, 3, 147, 2, 14, RCC_SYSCLK_DIV1, RCC_HCLK_DIV4, RCC_HCLK_DIV2, 3.500000, -0.022222 },
    { 224.00, 8000000, 3, 168, 2, 8, RCC_SYSCLK_DIV1, RCC_HCLK_DIV8, RCC_HCLK_DIV4, 3.500000, -0.022222 },
    { 252.00, 8000000, 3, 189, 2, 9, RCC_SYSCLK_DIV1, RCC_HCLK_DIV8, RCC_HCLK_DIV4, 3.500000, -0.022222 },
    { 280.00, 8000000, 3, 210, 2, 10, RCC_SYSCLK_DIV1, RCC_HCLK_DIV8, RCC_HCLK_DIV4, 3.500000, -0.022222 },
    { 182.00, 8000000, 3, 273, 4, 13, RCC_SYSCLK_DIV1, RCC_HCLK_DIV4, RCC_HCLK_DIV2, 3.500000, -0.022222 },
    { 196.00, 8000000, 3, 294, 4, 14, RCC_SYSCLK_DIV1, RCC_HCLK_DIV4, RCC_HCLK_DIV2, 3.500000, -0.022222 },
    { 210.00, 8000000, 3, 315, 4, 15, RCC_SYSCLK_DIV1, RCC_HCLK_DIV4, RCC_HCLK_DIV2, 3.500000, -0.022222 },
    { 224.00, 8000000, 3, 336, 4, 8, RCC_SYSCLK_DIV1, RCC_HCLK_DIV8, RCC_HCLK_DIV4, 3.500000, -0.022222 },
    { 252.00, 8000000, 3, 378, 4, 9, RCC_SYSCLK_DIV1, RCC_HCLK_DIV8, RCC_HCLK_DIV4, 3.500000, -0.022222 },
    { 280.00, 8000000, 3, 420, 4, 10, RCC_SYSCLK_DIV1, RCC_HCLK_DIV8, RCC_HCLK_DIV4, 3.500000, -0.022222 },
    { 182.00, 8000000, 4, 182, 2, 13, RCC_SYSCLK_DIV1, RCC_HCLK_DIV4, RCC_HCLK_DIV2, 3.500000, -0.022222 },
    { 196.00, 8000000, 4, 196, 2, 14, RCC_SYSCLK_DIV1, RCC_HCLK_DIV4, RCC_HCLK_DIV2, 3.500000, -0.022222 },
    { 210.00, 8000000, 4, 210, 2, 15, RCC_SYSCLK_DIV1, RCC_HCLK_DIV4, RCC_HCLK_DIV2, 3.500000, -0.022222 },
    { 224.00, 8000000, 4, 224, 2, 8, RCC_SYSCLK_DIV1, RCC_HCLK_DIV8, RCC_HCLK_DIV4, 3.500000, -0.022222 },
    { 252.00, 8000000, 4, 252, 2, 9, RCC_SYSCLK_DIV1, RCC_HCLK_DIV8, RCC_HCLK_DIV4, 3.500000, -0.022222 },
    { 280.00, 8000000, 4, 280, 2, 10, RCC_SYSCLK_DIV1, RCC_HCLK_DIV8, RCC_HCLK_DIV4, 3.500000, -0.022222 },
    { 182.00, 8000000, 4, 364, 4, 13, RCC_SYSCLK_DIV1, RCC_HCLK_DIV4, RCC_HCLK_DIV2, 3.500000, -0.022222 },
    { 196.00, 8000000, 4, 392, 4, 14, RCC_SYSCLK_DIV1, RCC_HCLK_DIV4, RCC_HCLK_DIV2, 3.500000, -0.022222 },
    { 210.00, 8000000, 4, 420, 4, 15, RCC_SYSCLK_DIV1, RCC_HCLK_DIV4, RCC_HCLK_DIV2, 3.500000, -0.022222 },
    { 196.00, 8000000, 5, 245, 2, 14, RCC_SYSCLK_DIV1, RCC_HCLK_DIV4, RCC_HCLK_DIV2, 3.500000, -0.022222 },
    { 224.00, 8000000, 5, 280, 2, 8, RCC_SYSCLK_DIV1, RCC_HCLK_DIV8, RCC_HCLK_DIV4, 3.500000, -0.022222 },
    { 252.00, 8000000, 5, 315, 2, 9, RCC_SYSCLK_DIV1, RCC_HCLK_DIV8, RCC_HCLK_DIV4, 3.500000, -0.022222 },
    { 280.00, 8000000, 5, 350, 2, 10, RCC_SYSCLK_DIV1, RCC_HCLK_DIV8, RCC_HCLK_DIV4, 3.500000, -0.022222 },
    { 182.00, 8000000, 6, 273, 2, 13, RCC_SYSCLK_DIV1, RCC_HCLK_DIV4, RCC_HCLK_DIV2, 3.500000, -0.022222 },
    { 196.00, 8000000, 6, 294, 2, 14, RCC_SYSCLK_DIV1, RCC_HCLK_DIV4, RCC_HCLK_DIV2, 3.500000, -0.022222 },
    { 210.00, 8000000, 6, 315, 2, 15, RCC_SYSCLK_DIV1, RCC_HCLK_DIV4, RCC_HCLK_DIV2, 3.500000, -0.022222 },
    { 224.00, 8000000, 6, 336, 2, 8, RCC_SYSCLK_DIV1, RCC_HCLK_DIV8, RCC_HCLK_DIV4, 3.500000, -0.022222 },
    { 252.00, 8000000, 6, 378, 2, 9, RCC_SYSCLK_DIV1, RCC_HCLK_DIV8, RCC_HCLK_DIV4, 3.500000, -0.022222 },
    { 280.00, 8000000, 6, 420, 2, 10, RCC_SYSCLK_DIV1, RCC_HCLK_DIV8, RCC_HCLK_DIV4, 3.500000, -0.022222 },
    { 182.00, 8000000, 8, 364, 2, 13, RCC_SYSCLK_DIV1, RCC_HCLK_DIV4, RCC_HCLK_DIV2, 3.500000, -0.022222 },
    { 196.00, 8000000, 8, 392, 2, 14, RCC_SYSCLK_DIV1, RCC_HCLK_DIV4, RCC_HCLK_DIV2, 3.500000, -0.022222 },
    { 210.00, 8000000, 8, 420, 2, 15, RCC_SYSCLK_DIV1, RCC_HCLK_DIV4, RCC_HCLK_DIV2, 3.500000, -0.022222 },
    { 190.29, 8000000, 7, 333, 2, 13, RCC_SYSCLK_DIV1, RCC_HCLK_DIV4, RCC_HCLK_DIV2, 3.659341, 0.022292 },
    { 292.80, 8000000, 5, 366, 2, 10, RCC_SYSCLK_DIV1, RCC_HCLK_DIV8, RCC_HCLK_DIV4, 3.660000, 0.022476 },
    { 205.00, 8000000, 2, 205, 4, 14, RCC_SYSCLK_DIV1, RCC_HCLK_DIV4, RCC_HCLK_DIV2, 3.660714, 0.022676 },
    { 205.00, 8000000, 2, 410, 8, 14, RCC_SYSCLK_DIV1, RCC_HCLK_DIV4, RCC_HCLK_DIV2, 3.660714, 0.022676 },
    { 205.00, 8000000, 4, 205, 2, 14, RCC_SYSCLK_DIV1, RCC_HCLK_DIV4, RCC_HCLK_DIV2, 3.660714, 0.022676 },
    { 205.00, 8000000, 4, 410, 4, 14, RCC_SYSCLK_DIV1, RCC_HCLK_DIV4, RCC_HCLK_DIV2, 3.660714, 0.022676 },
    { 234.29, 8000000, 7, 410, 2, 8, RCC_SYSCLK_DIV1, RCC_HCLK_DIV8, RCC_HCLK_DIV4, 3.660714, 0.022676 },
    { 205.00, 8000000, 8, 410, 2, 14, RCC_SYSCLK_DIV1, RCC_HCLK_DIV4, RCC_HCLK_DIV2, 3.660714, 0.022676 },
    { 190.40, 8000000, 5, 238, 2, 13, RCC_SYSCLK_DIV1, RCC_HCLK_DIV4, RCC_HCLK_DIV2, 3.661538, 0.022906 },
    { 293.00, 8000000, 2, 293, 4, 10, RCC_SYSCLK_DIV1, RCC_HCLK_DIV8, RCC_HCLK_DIV4, 3.662500, 0.023175 },
    { 293.00, 8000000, 4, 293, 2, 10, RCC_SYSCLK_DIV1, RCC_HCLK_DIV8, RCC_HCLK_DIV4, 3.662500, 0.023175 },
    { 234.40, 8000000, 5, 293, 2, 8, RCC_SYSCLK_DIV1, RCC_HCLK_DIV8, RCC_HCLK_DIV4, 3.662500, 0.023175 },
    { 205.14, 8000000, 7, 359, 2, 14, RCC_SYSCLK_DIV1, RCC_HCLK_DIV4, RCC_HCLK_DIV2, 3.663265, 0.023389 },
    { 181.78, 8000000, 3, 409, 6, 13, RCC_SYSCLK_DIV1, RCC_HCLK_DIV4, RCC_HCLK_DIV2, 3.495726, -0.023416 },
    { 181.78, 8000000, 9, 409, 2, 13, RCC_SYSCLK_DIV1, RCC_HCLK_DIV4, RCC_HCLK_DIV2, 3.495726, -0.023416 },
    { 190.50, 8000000, 2, 381, 8, 13, RCC_SYSCLK_DIV1, RCC_HCLK_DIV4, RCC_HCLK_DIV2, 3.663462, 0.023443 },
    { 190.50, 8000000, 4, 381, 4, 13, RCC_SYSCLK_DIV1, RCC_HCLK_DIV4, RCC_HCLK_DIV2, 3.663462, 0.023443 },
    { 190.50, 8000000, 8, 381, 2, 13, RCC_SYSCLK_DIV1, RCC_HCLK_DIV4, RCC_HCLK_DIV2, 3.663462, 0.023443 },
    { 209.71, 8000000, 7, 367, 2, 15, RCC_SYSCLK_DIV1, RCC_HCLK_DIV4, RCC_HCLK_DIV2, 3.495238, -0.023552 },
    { 181.71, 8000000, 7, 318, 2, 13, RCC_SYSCLK_DIV1, RCC_HCLK_DIV4, RCC_HCLK_DIV2, 3.494505, -0.023757 },
    { 209.60, 8000000, 5, 262, 2, 15, RCC_SYSCLK_DIV1, RCC_HCLK_DIV4, RCC_HCLK_DIV2, 3.493333, -0.024085 },
    { 264.00, 8000000, 3, 198, 2, 9, RCC_SYSCLK_DIV1, RCC_HCLK_DIV8, RCC_HCLK_DIV4, 3.666667, 0.024339 },
    { 264.00, 8000000, 3, 396, 4, 9, RCC_SYSCLK_DIV1, RCC_HCLK_DIV8, RCC_HCLK_DIV4, 3.666667, 0.024339 },
    { 264.00, 8000000, 6, 396, 2, 9, RCC_SYSCLK_DIV1, RCC_HCLK_DIV8, RCC_HCLK_DIV4, 3.666667, 0.024339 },
    { 264.00, 8000000, 2, 132, 2, 9, RCC_SYSCLK_DIV1, RCC_HCLK_DIV8, RCC_HCLK_DIV4, 3.666667, 0.024339 },
    { 264.00, 8000000, 2, 264, 4, 9, RCC_SYSCLK_DIV1, RCC_HCLK_DIV8, RCC_HCLK_DIV4, 3.666667, 0.024339 },
    { 190.67, 8000000, 2, 286, 6, 13, RCC_SYSCLK_DIV1, RCC_HCLK_DIV4, RCC_HCLK_DIV2, 3.666667, 0.024339 },
    { 234.67, 8000000, 2, 352, 6, 8, RCC_SYSCLK_DIV1, RCC_HCLK_DIV8, RCC_HCLK_DIV4, 3.666667, 0.024339 },
    { 264.00, 8000000, 2, 396, 6, 9, RCC_SYSCLK_DIV1, RCC_HCLK_DIV8, RCC_HCLK_DIV4, 3.666667, 0.024339 },
    { 190.67, 8000000, 3, 143, 2, 13, RCC_SYSCLK_DIV1, RCC_HCLK_DIV4, RCC_HCLK_DIV2, 3.666667, 0.024339 },
    { 205.33, 8000000, 3, 154, 2, 14, RCC_SYSCLK_DIV1, RCC_HCLK_DIV4, RCC_HCLK_DIV2, 3.666667, 0.024339 },
    { 234.67, 8000000, 3, 176, 2, 8, RCC_SYSCLK_DIV1, RCC_HCLK_DIV8, RCC_HCLK_DIV4, 3.666667, 0.024339 },
    { 293.33, 8000000, 3, 220, 2, 10, RCC_SYSCLK_DIV1, RCC_HCLK_DIV8, RCC_HCLK_DIV4, 3.666667, 0.024339 },
    { 190.67, 8000000, 3, 286, 4, 13, RCC_SYSCLK_DIV1, RCC_HCLK_DIV4, RCC_HCLK_DIV2, 3.666667, 0.024339 },
    { 205.33, 8000000, 3, 308, 4, 14, RCC_SYSCLK_DIV1, RCC_HCLK_DIV4, RCC_HCLK_DIV2, 3.666667, 0.024339 },
    { 234.67, 8000000, 3, 352, 4, 8, RCC_SYSCLK_DIV1, RCC_HCLK_DIV8, RCC_HCLK_DIV4, 3.666667, 0.024339 },
    { 190.67, 8000000, 3, 429, 6, 13, RCC_SYSCLK_DIV1, RCC_HCLK_DIV4, RCC_HCLK_DIV2, 3.666667, 0.024339 },
    { 264.00, 8000000, 4, 264, 2, 9, RCC_SYSCLK_DIV1, RCC_HCLK_DIV8, RCC_HCLK_DIV4, 3.666667, 0.024339 },
    { 264.00, 8000000, 5, 330, 2, 9, RCC_SYSCLK_DIV1, RCC_HCLK_DIV8, RCC_HCLK_DIV4, 3.666667, 0.024339 },
    { 190.67, 8000000, 6, 286, 2, 13, RCC_SYSCLK_DIV1, RCC_HCLK_DIV4, RCC_HCLK_DIV2, 3.666667, 0.024339 },
    { 205.33, 8000000, 6, 308, 2, 14, RCC_SYSCLK_DIV1, RCC_HCLK_DIV4, RCC_HCLK_DIV2, 3.666667, 0.024339 },
    { 234.67, 8000000, 6, 352, 2, 8, RCC_SYSCLK_DIV1, RCC_HCLK_DIV8, RCC_HCLK_DIV4, 3.666667, 0.024339 },
    { 190.67, 8000000, 9, 429, 2, 13, RCC_SYSCLK_DIV1, RCC_HCLK_DIV4, RCC_HCLK_DIV2, 3.666667, 0.024339 },
    { 205.33, 8000000, 2, 308, 6, 14, RCC_SYSCLK_DIV1, RCC_HCLK_DIV4, RCC_HCLK_DIV2, 3.666667, 0.024339 },
    { 181.60, 8000000, 5, 227, 2, 13, RCC_SYSCLK_DIV1, RCC_HCLK_DIV4, RCC_HCLK_DIV2, 3.492308, -0.024371 },
};
static const unsigned int clockConfigCount = sizeof(clockConfigs) / sizeof(clockConfigs[0]);

static void SystemClock_Config(void)
{
  RCC_ClkInitTypeDef RCC_ClkInitStruct;
  RCC_OscInitTypeDef RCC_OscInitStruct;

  /* Enable Power Control clock */
  __HAL_RCC_PWR_CLK_ENABLE();

  /* The voltage scaling allows optimizing the power consumption when the device is 
     clocked below the maximum system frequency, to update the voltage scaling value 
     regarding system frequency refer to product datasheet.  */
  __HAL_PWR_VOLTAGESCALING_CONFIG(PWR_REGULATOR_VOLTAGE_SCALE1);

  const ClockConfiguration *clk = clockConfigs + whichConfig;

#if 1 // HSE - high speed external oscillator; on the NUCLEO-144 it's an 8MHz clock I installed

  unsigned int PLL_Q = (HSE_VALUE / clk->PLL_M * clk->PLL_N / clk->PLL_P / 48 + 999999) / 1000000;

  RCC_OscInitStruct.OscillatorType = RCC_OSCILLATORTYPE_LSI|RCC_OSCILLATORTYPE_HSE;
  RCC_OscInitStruct.HSEState = RCC_HSE_ON;
  RCC_OscInitStruct.LSIState = RCC_LSI_ON;
  RCC_OscInitStruct.PLL.PLLState = RCC_PLL_ON;
  RCC_OscInitStruct.PLL.PLLSource = RCC_PLLSOURCE_HSE;
  RCC_OscInitStruct.PLL.PLLM = clk->PLL_M; // Divide PLL source by this
  RCC_OscInitStruct.PLL.PLLN = clk->PLL_N; // Then multiply by this 
  RCC_OscInitStruct.PLL.PLLP = clk->PLL_P; // Then divide by this
  RCC_OscInitStruct.PLL.PLLQ = PLL_Q; // Divide by this for SD, USB OTG FS, and some other peripherals
  if(HAL_RCC_OscConfig(&RCC_OscInitStruct) != HAL_OK)
  {
    panic();
  }

  RCC_ClkInitStruct.ClockType = RCC_CLOCKTYPE_HCLK | RCC_CLOCKTYPE_SYSCLK | RCC_CLOCKTYPE_PCLK1 | RCC_CLOCKTYPE_PCLK2;
  RCC_ClkInitStruct.SYSCLKSource = RCC_SYSCLKSOURCE_PLLCLK;
  RCC_ClkInitStruct.AHBCLKDivider = clk->HCLK_DIV;
  RCC_ClkInitStruct.APB1CLKDivider = clk->APB1_DIV; // APB1 clock
  RCC_ClkInitStruct.APB2CLKDivider = clk->APB2_DIV; // APB2 clock
  // grantham - 5 cycles for 168MHz is stated in Table 10 in the STM32F4 reference manual
  if(HAL_RCC_ClockConfig(&RCC_ClkInitStruct, FLASH_LATENCY_7) != HAL_OK)
  {
    panic();
  }

#else

  unsigned int PLL_Q = (HSI_VALUE / clk->PLL_M * clk->PLL_N / clk->PLL_P / 48 + 999999) / 1000000;

    RCC_OscInitStruct.OscillatorType = RCC_OSCILLATORTYPE_HSI;
  RCC_OscInitStruct.HSIState = RCC_HSI_ON;
  RCC_OscInitStruct.HSICalibrationValue = RCC_HSICALIBRATION_DEFAULT;
  RCC_OscInitStruct.PLL.PLLState = RCC_PLL_ON;
  RCC_OscInitStruct.PLL.PLLSource = RCC_PLLSOURCE_HSI;
  RCC_OscInitStruct.PLL.PLLM = clk->PLL_M; // Divide PLL source by this
  RCC_OscInitStruct.PLL.PLLN = clk->PLL_N; // Then multiply by this 
  RCC_OscInitStruct.PLL.PLLP = clk->PLL_P; // Then divide by this
  RCC_OscInitStruct.PLL.PLLQ = PLL_Q; // Divide by this for SD, USB OTG FS, and some other peripherals
  if (HAL_RCC_OscConfig(&RCC_OscInitStruct) != HAL_OK)
  {
    panic();
  }

  RCC_ClkInitStruct.ClockType = RCC_CLOCKTYPE_SYSCLK | RCC_CLOCKTYPE_PCLK1 | RCC_CLOCKTYPE_PCLK2;
  RCC_ClkInitStruct.SYSCLKSource = RCC_SYSCLKSOURCE_PLLCLK;
  RCC_ClkInitStruct.AHBCLKDivider = clk->HCLK_DIV;
  RCC_ClkInitStruct.APB1CLKDivider = clk->APB1_DIV; // APB1 clock
  RCC_ClkInitStruct.APB2CLKDivider = clk->APB2_DIV; // APB2 clock

  if (HAL_RCC_ClockConfig(&RCC_ClkInitStruct, FLASH_LATENCY_7) != HAL_OK)
  {
    panic();
  }

#endif

  /* Enable other CLKs */
  __HAL_RCC_TIM1_CLK_ENABLE();
  __HAL_RCC_TIM2_CLK_ENABLE();
  __HAL_RCC_TIM3_CLK_ENABLE();
  __HAL_RCC_TIM4_CLK_ENABLE();
  __HAL_RCC_TIM5_CLK_ENABLE();
  __HAL_RCC_TIM6_CLK_ENABLE();
  __HAL_RCC_TIM7_CLK_ENABLE();
  __HAL_RCC_TIM8_CLK_ENABLE();
  __HAL_RCC_TIM9_CLK_ENABLE();
  __HAL_RCC_DMA2_CLK_ENABLE();
  __HAL_RCC_DAC_CLK_ENABLE();
    __HAL_RCC_GPIOA_CLK_ENABLE();
    __HAL_RCC_GPIOB_CLK_ENABLE();
    __HAL_RCC_GPIOC_CLK_ENABLE();
    __HAL_RCC_GPIOD_CLK_ENABLE();

    // Since this relies solely on the clock 
    delay_init();
}

// Was in the 417's header but I could not find in the 746's headers
#ifndef RCC_PLLCFGR_RST_VALUE 
#define RCC_PLLCFGR_RST_VALUE 0x24003010
#endif

void DeInitRCCAndPLL()
{
    // Unset the RCC and reset it
    RCC->CR |= RCC_HSI_ON;
    RCC->CFGR = 0x00000000U;
    uint32_t vl_mask = 0xFFFFFFFFU;
    /* Reset HSEON, PLLSYSON bits */
    CLEAR_BIT(vl_mask, (RCC_CR_HSEON | RCC_CR_HSEBYP | RCC_CR_PLLON | RCC_CR_CSSON));
    RCC->CR &= vl_mask;
    RCC->CR = (RCC->CR & ~RCC_CR_HSITRIM_Msk) | (0x10 << RCC_CR_HSITRIM_Pos); /* Set HSITRIM bits to the reset value*/
    RCC->PLLCFGR = RCC_PLLCFGR_RST_VALUE; /* Reset PLLCFGR register */
    RCC->CR &= ~RCC_CR_HSEBYP; /* Reset HSEBYP bit */
  /* Disable all interrupts */
    RCC->CIR = 0x00000000U;
// *            - HSI ON and used as system clock source
// *            - HSE and PLL OFF
// *            - AHB, APB1 and APB2 prescaler set to 1.
// *            - CSS, MCO1 and MCO2 OFF
// *            - All interrupts disabled
}

//----------------------------------------------------------------------------
// stdio

#define OUTPUT_TO_SERIAL        0x01
#define OUTPUT_TO_TEXTPORT         0x02

int gOutputDevices = OUTPUT_TO_SERIAL;

int InputGetChar(void)
{
    SERIAL_poll_continue();
    unsigned char isEmpty = queue_isempty(&mon_queue.q);
    if(!isEmpty) {
        unsigned char c = queue_deq(&mon_queue.q);
        return c;
    }
    return -1;
}

// Assumed to be raw mode - returns next character, not buffering until newline
int __io_getchar(void)
{
    while(1) {
#ifdef USE_PS2KBD
        int c = KBD_process_queue(gDumpKeyboardData);
        if(c >= 0) {
            return c;
        }
#endif
        SERIAL_poll_continue();
        unsigned char isEmpty = queue_isempty(&mon_queue.q);
        if(!isEmpty) {
            unsigned char c = queue_deq(&mon_queue.q);
            return c;
        }
        delay_ms(10);
    }
}

void __io_putchar( char c )
{
    if(gOutputDevices & OUTPUT_TO_SERIAL) {
        SERIAL_enqueue_one_char(c);
        if(c == '\n') {
            SERIAL_flush();
        }
    }

    if(gOutputDevices & OUTPUT_TO_TEXTPORT) {
        TextportPutchar(c);
    }
}

void errorchar(char c)
{
    SERIAL_enqueue_one_char(c);
}

void errorchar_flush()
{
    SERIAL_flush();
}

//----------------------------------------------------------------------------
// File operations

void check_exceptional_conditions()
{
    if(gConsoleOverflowed) {
        logprintf(DEBUG_WARNINGS, "WARNING: Console input queue overflow\n");
        gConsoleOverflowed = 0;
    }

#ifdef USE_PS2KBD
    if(gKeyboardOverflowed) {
        logprintf(DEBUG_WARNINGS, "WARNING: Keyboard data queue overflow\n");
        gKeyboardOverflowed = 0;
    }

    if(gKeyboardParityError) {
        logprintf(DEBUG_WARNINGS, "WARNING: Keyboard data parity error, received 0x%02X\n", gKeyboardParityError - 256);
        gKeyboardParityError = 0;
    }

    if(gKeyboardBATBadParity) {
        logprintf(DEBUG_EVENTS, "EVENT: Received initial BAT with parity error from PS/2 keyboard\n");
        gKeyboardBATBadParity = 0;
    }
#endif
}

void process_local_key(unsigned char c);

void process_monitor_queue()
{
    unsigned char isEmpty = queue_isempty(&mon_queue.q);
    static unsigned char escapeBackToMonitor = 0;

    if(!isEmpty) {
        unsigned char c = queue_deq(&mon_queue.q);
        if(gSerialInputToMonitor)
            process_local_key(c);
        else {
            if(escapeBackToMonitor == 0 && c == 1)
                escapeBackToMonitor = 1;
            else if(escapeBackToMonitor != 0 && c == 2) {
                escapeBackToMonitor = 0;
                gSerialInputToMonitor = 1;
                printf("Serial input returned to monitor\n");
            } else {
                escapeBackToMonitor = 0;
                disable_interrupts();
                console_enqueue_key_unsafe(c);
                enable_interrupts();
            }
        }
    }
}

void uart_received(char c)
{
    queue_enq(&mon_queue.q, c);
}

void console_queue_init()
{
    queue_init(&con_queue.q, CON_QUEUE_CAPACITY);
}

//----------------------------------------------------------------------------
// DAC

#define DAC_VALUE_LIMIT 0xFF

#define MAX_DAC_VOLTAGE 1.22f
#define MAX_DAC_VOLTAGE_F16 79954

unsigned char voltageToDACValue(float voltage)
{
    if(voltage < 0.0f) {
        return 0x0;
    }
    uint32_t value = (uint32_t)(voltage / MAX_DAC_VOLTAGE * 255);
    if(value >= DAC_VALUE_LIMIT) {
        return DAC_VALUE_LIMIT;
    }
    return value;
}

unsigned char voltageToDACValueNoBounds(float voltage)
{
    return (uint32_t)(voltage / MAX_DAC_VOLTAGE * 255);
}

int voltageToDACValueFixed16NoBounds(int voltage)
{
    return (uint32_t)(voltage * 65535 / MAX_DAC_VOLTAGE_F16) * 256;
}

//----------------------------------------------------------------------------
// NTSC Video goop

#define ROW_SAMPLES        912

#define NTSC_COLORBURST_FREQUENCY       3579545
#define NTSC_EQPULSE_LINES	3
#define NTSC_VSYNC_LINES	3
#define NTSC_VBLANK_LINES	11
#define NTSC_FRAME_LINES	525
#define NTSC_EQ_PULSE_INTERVAL	.04
#define NTSC_VSYNC_BLANK_INTERVAL	.43
#define NTSC_HOR_SYNC_DUR	.075
#define NTSC_FRAMES		(59.94 / 2)
#define NTSC_FRONTPORCH		.02
/* BACKPORCH including COLORBURST */
#define NTSC_BACKPORCH		.075
#define NTSC_COLORBURST_CYCLES  10

#define NTSC_SYNC_TIP_VOLTAGE   0.0f
#define NTSC_SYNC_PORCH_VOLTAGE   .285f
#define NTSC_SYNC_BLACK_VOLTAGE   .339f
#define NTSC_SYNC_WHITE_VOLTAGE   1.0f  /* VCR had .912v */

#define NTSC_SYNC_BLACK_VOLTAGE_F16   22217
#define NTSC_SYNC_WHITE_VOLTAGE_F16   65536

int SECTION_CCMRAM markHandlerInSamples = 0;

volatile int16_t SECTION_CCMRAM rowDMARemained[NTSC_FRAME_LINES];
volatile uint32_t SECTION_CCMRAM DMAFIFOUnderruns = 0;
volatile uint32_t SECTION_CCMRAM DMATransferErrors = 0;
typedef enum { NTSC_SOLID_FILL, NTSC_COLOR_TEST, NTSC_SCAN_TEST, NTSC_DISPLAY_BLACK, NTSC_USE_VIDEO_MODE} VideoMode;
volatile VideoMode SECTION_CCMRAM NTSCMode = NTSC_COLOR_TEST;
volatile int SECTION_CCMRAM videoScanTestLeft = 200;
volatile int SECTION_CCMRAM videoScanTestRight = 700;
volatile int SECTION_CCMRAM videoScanTestTop = 50;
volatile int SECTION_CCMRAM videoScanTestBottom = 200;

// Number of samples we target, 4x colorburst yields 227.5 cycles, or 910 samples at 14.318180MHz
// But we cheat and actually scan out 912 cycles to be a multiple
// of 16, so lines are .22% too long.  We hope the receiver is permissive
// enough to ignore this.  My cheap Orion is.

// These are in CCM to reduce contention with SRAM1 during DMA 
unsigned char SECTION_CCMRAM NTSCEqSyncPulseLine[ROW_SAMPLES];
unsigned char SECTION_CCMRAM NTSCVSyncLine[ROW_SAMPLES];
unsigned char SECTION_CCMRAM NTSCBlankLine[ROW_SAMPLES];

unsigned char SECTION_CCMRAM NTSCSyncTip;
unsigned char SECTION_CCMRAM NTSCSyncPorch;
unsigned char SECTION_CCMRAM NTSCBlack;
unsigned char SECTION_CCMRAM NTSCWhite;
unsigned char SECTION_CCMRAM NTSCMaxAllowed;

int NTSCEqPulseClocks;
int NTSCVSyncClocks;
int NTSCHSyncClocks;
int NTSCLineClocks;
int NTSCFrameClocks;
int NTSCFrontPorchClocks;
int NTSCBackPorchClocks;

// Essentially the remainder of CCMRAM, will need to be shrunk if more goes into CCM
#define IMGBUFFER_SIZE  50564
// (Following was copied from paper chicken scratches)
// On Orion TV, one 14MHz clock is .0225 inches, one 240p row is .052 inches.
// So to find a close value for width, width = sqrt(4 / 3 * .052 / .0225 * IMGBUFFER_SIZE)
// Then, height should be no more than width * 3 * .0225 / (4 / .052)
// So for 53248, a reasonable 4:3 framebuffer is 400x128
// 4:3 aspect would be 1.333
// 400 wide would be 9 inches, and 128 high would be 6.656 inches, and that's 1.352, so it's not too bad
unsigned char SECTION_CCMRAM imgBuffer[IMGBUFFER_SIZE];

uint32_t SECTION_CCMRAM paletteToWave[2][256];
unsigned char SECTION_CCMRAM rowPalette[NTSC_FRAME_LINES];

// XXX these are in SRAM2 to reduce contention with SRAM1 during DMA
unsigned char __attribute__((section (".sram2"))) row0[ROW_SAMPLES];
unsigned char __attribute__((section (".sram2"))) row1[ROW_SAMPLES];
unsigned char __attribute__((section (".sram2"))) audio0[512];
unsigned char __attribute__((section (".sram2"))) audio1[512];

unsigned char NTSCYIQToDAC(float y, float i, float q, float tcycles)
{
// This is transcribed from the NTSC spec, double-checked.
    float wt = tcycles * M_PI * 2;
    float sine = sinf(wt + 33.0f / 180.0f * M_PI);
    float cosine = cosf(wt + 33.0f / 180.0f * M_PI);
    float signal = y + q * sine + i * cosine;
// end of transcription

    return voltageToDACValue(NTSC_SYNC_BLACK_VOLTAGE + signal * (NTSC_SYNC_WHITE_VOLTAGE - NTSC_SYNC_BLACK_VOLTAGE));
}

unsigned char NTSCYIQDegreesToDAC(float y, float i, float q, int degrees)
{
    float sine, cosine;
    if(degrees == 0) {
        sine = 0.544638f;
        cosine = 0.838670f;
    } else if(degrees == 90) {
        sine = 0.838670f;
        cosine = -0.544638f;
    } else if(degrees == 1160) {
        sine = -0.544638f;
        cosine = -0.838670f;
    } else if(degrees == 270) {
        sine = -0.838670f;
        cosine = 0.544638f;
    } else {
        sine = 0;
        cosine = 0;
    }
    float signal = y + q * sine + i * cosine;

    return voltageToDACValueNoBounds(NTSC_SYNC_BLACK_VOLTAGE + signal * (NTSC_SYNC_WHITE_VOLTAGE - NTSC_SYNC_BLACK_VOLTAGE));
}

uint32_t NTSCYIQToWave(float y, float i, float q)
{
    unsigned char b0 = NTSCYIQToDAC(y, i, q,  .0f);
    unsigned char b1 = NTSCYIQToDAC(y, i, q, .25f);
    unsigned char b2 = NTSCYIQToDAC(y, i, q, .50f);
    unsigned char b3 = NTSCYIQToDAC(y, i, q, .75f);

    return (b0 << 0) | (b1 << 8) | (b2 << 16) | (b3 << 24);
}

uint32_t NTSCRGBToWave(float r, float g, float b)
{
    float y, i, q;
    RGBToYIQ(r, g, b, &y, &i, &q);
    return NTSCYIQToWave(y, i, q);
}

unsigned char NTSCColorburst0;
unsigned char NTSCColorburst90;
unsigned char NTSCColorburst180;
unsigned char NTSCColorburst270;

void NTSCCalculateParameters(float clock)
{
    // Calculate values for a scanline
    NTSCFrameClocks = floorf(clock * 1000000.0 / NTSC_FRAMES + 0.5);
    // NTSCLineClocks = floorf((double)NTSCFrameClocks / NTSC_FRAME_LINES + 0.5);
    NTSCLineClocks = ROW_SAMPLES;
    NTSCHSyncClocks = floorf(NTSCLineClocks * NTSC_HOR_SYNC_DUR + 0.5);
    NTSCFrontPorchClocks = NTSCLineClocks * NTSC_FRONTPORCH;
    NTSCBackPorchClocks = NTSCLineClocks * NTSC_BACKPORCH;
    NTSCEqPulseClocks = NTSCLineClocks * NTSC_EQ_PULSE_INTERVAL;
    NTSCVSyncClocks = NTSCLineClocks * NTSC_VSYNC_BLANK_INTERVAL;

    NTSCSyncTip = voltageToDACValue(NTSC_SYNC_TIP_VOLTAGE);
    NTSCSyncPorch = voltageToDACValue(NTSC_SYNC_PORCH_VOLTAGE);
    NTSCBlack = voltageToDACValue(NTSC_SYNC_BLACK_VOLTAGE);
    NTSCWhite = voltageToDACValue(NTSC_SYNC_WHITE_VOLTAGE);
    NTSCMaxAllowed = 255;

    // Calculate the four values for the colorburst that we'll repeat to make a wave
    // The waveform is defined as sine in the FCC broadcast doc, but for
    // composite the voltages are reversed, so the waveform becomes -sine.
    NTSCColorburst0 = NTSCSyncPorch;
    NTSCColorburst90 = NTSCSyncPorch - .6 * NTSCSyncPorch;
    NTSCColorburst180 = NTSCSyncPorch;
    NTSCColorburst270 = NTSCSyncPorch + .6 * NTSCSyncPorch;

    // System palette entries
    paletteToWave[1][255] = paletteToWave[0][255] = 
        (NTSCWhite <<  0) |
        (NTSCWhite <<  8) |
        (NTSCWhite << 16) |
        (NTSCWhite << 24);
    paletteToWave[1][254] = paletteToWave[0][254] = 
        (NTSCBlack <<  0) |
        (NTSCBlack <<  8) |
        (NTSCBlack << 16) |
        (NTSCBlack << 24);

    memset(rowPalette, 0, sizeof(rowPalette));

    memset(row0, NTSCSyncPorch, sizeof(row0));
    memset(row1, NTSCSyncPorch, sizeof(row1));
}

void NTSCFillEqPulseLine(unsigned char *rowBuffer)
{
    for (int col = 0; col < NTSCLineClocks; col++) {
        if (col < NTSCEqPulseClocks || (col > NTSCLineClocks/2 && col < NTSCLineClocks/2 + NTSCEqPulseClocks)) {
            rowBuffer[col] = NTSCSyncTip;
        } else {
            rowBuffer[col] = NTSCSyncPorch;
        }
    }
}

void NTSCFillVSyncLine(unsigned char *rowBuffer)
{
    for (int col = 0; col < NTSCLineClocks; col++) {
        if (col < NTSCVSyncClocks || (col > NTSCLineClocks/2 && col < NTSCLineClocks/2 + NTSCVSyncClocks)) {
            rowBuffer[col] = NTSCSyncTip;
        } else {
            rowBuffer[col] = NTSCSyncPorch;
        }
    }
}

// Haven't accelerated because not yet done in scan ISR
void NTSCAddColorburst(unsigned char *rowBuffer)
{
    static const int startOfColorburstClocks = 80; // XXX magic number for current clock

    for(int col = startOfColorburstClocks; col < startOfColorburstClocks + NTSC_COLORBURST_CYCLES * 4; col++) {
        switch((col - startOfColorburstClocks) % 4) {
            case 0: rowBuffer[col] = NTSCColorburst0; break;
            case 1: rowBuffer[col] = NTSCColorburst90; break;
            case 2: rowBuffer[col] = NTSCColorburst180; break;
            case 3: rowBuffer[col] = NTSCColorburst270; break;
        }
    }
}

void NTSCFillBlankLine(unsigned char *rowBuffer, int withColorburst)
{
    for (int col = 0; col < NTSCLineClocks; col++) {
        if (col < NTSCHSyncClocks) {
            rowBuffer[col] = NTSCSyncTip;
        } else {
            rowBuffer[col] = NTSCSyncPorch;
        }
    }
    if(withColorburst) {
        NTSCAddColorburst(rowBuffer);
    }
}

void NTSCGenerateLineBuffers()
{
    // one line = (1 / 3579545) * (455/2)

    // front porch is (.165) * (1 / 15734) / (1 / 3579545) = 37.53812921062726565701 cycles (37.5)
    //     74 cycles at double clock
    // pixels is (1 - .165) * (1 / 15734) / (1 / 3579545) = 189.96568418711380557696 cycles (190)
    //     280 cycles at double clock

    NTSCFillEqPulseLine(NTSCEqSyncPulseLine);
    NTSCFillVSyncLine(NTSCVSyncLine);
    NTSCFillBlankLine(NTSCBlankLine, 1);
}

int NTSCSetRowPalette(int row, int palette)
{
    rowPalette[row] = palette;
    return 0;
}

static const VideoModeEntry NTSCModes[];
VideoFillRowFunc SECTION_CCMRAM VideoCurrentFillRow;
uint32_t SECTION_CCMRAM solidFillWave;


void NTSCFillRowBuffer(int frameNumber, int lineNumber, unsigned char *rowBuffer)
{
    // XXX could optimize these by having one branch be lines < 21
    /*
     * Rows 0 through 8 are equalizing pulse, then vsync, then equalizing pulse
     */
    if(lineNumber < NTSC_EQPULSE_LINES) {

        memcpy(rowBuffer, NTSCEqSyncPulseLine, sizeof(NTSCEqSyncPulseLine));

    } else if(lineNumber - NTSC_EQPULSE_LINES < NTSC_VSYNC_LINES) {

        memcpy(rowBuffer, NTSCVSyncLine, sizeof(NTSCVSyncLine));

    } else if(lineNumber - (NTSC_EQPULSE_LINES + NTSC_VSYNC_LINES) < NTSC_EQPULSE_LINES) {

        memcpy(rowBuffer, NTSCEqSyncPulseLine, sizeof(NTSCEqSyncPulseLine));

    } else if(lineNumber - (NTSC_EQPULSE_LINES + NTSC_VSYNC_LINES + NTSC_EQPULSE_LINES) < NTSC_VBLANK_LINES) {

        /*
         * Rows 9 through 2X are other part of vertical blank
         */

        // XXX should just change DMA source address, then this needs to be in SRAM2
        memcpy(rowBuffer, NTSCBlankLine, sizeof(NTSCBlankLine));

    } else if(lineNumber >= 263 && lineNumber <= 271) {
        // Interlacing handling weird lines
        if(lineNumber <= 264) {
            //lines 263, 264 - last 405 of eq pulse then first 405 of eq pulse
            memcpy(rowBuffer, NTSCEqSyncPulseLine + ROW_SAMPLES / 2, ROW_SAMPLES / 2);
            memcpy(rowBuffer + ROW_SAMPLES / 2, NTSCEqSyncPulseLine, ROW_SAMPLES / 2);
        } else if(lineNumber == 265) {
            //line 265 - last 405 of eq pulse then first 405 of vsync
            memcpy(rowBuffer, NTSCEqSyncPulseLine + ROW_SAMPLES / 2, ROW_SAMPLES / 2);
            memcpy(rowBuffer + ROW_SAMPLES / 2, NTSCVSyncLine, ROW_SAMPLES / 2);
        } else if(lineNumber <= 267) {
            //lines 266, 267 - last 405 of vsync then first 405 of vsync
            memcpy(rowBuffer, NTSCVSyncLine + ROW_SAMPLES / 2, ROW_SAMPLES / 2);
            memcpy(rowBuffer + ROW_SAMPLES / 2, NTSCVSyncLine, ROW_SAMPLES / 2);
        } else if(lineNumber == 268) {
            //lines 268 - last 405 of vsync then first 405 of eq pulse
            memcpy(rowBuffer, NTSCVSyncLine + ROW_SAMPLES / 2, ROW_SAMPLES / 2);
            memcpy(rowBuffer + ROW_SAMPLES / 2, NTSCEqSyncPulseLine, ROW_SAMPLES / 2);
        } else if(lineNumber <= 270) {
            //lines 269, 270 - last 405 of eq pulse then first 405 of eq pulse
            memcpy(rowBuffer, NTSCEqSyncPulseLine + ROW_SAMPLES / 2, ROW_SAMPLES / 2);
            memcpy(rowBuffer + ROW_SAMPLES / 2, NTSCEqSyncPulseLine, ROW_SAMPLES / 2);
        } else if(lineNumber == 271) {
            //line 271 - last 405 of eq pulse then 405 of SyncPorch
            memcpy(rowBuffer, NTSCEqSyncPulseLine + ROW_SAMPLES / 2, ROW_SAMPLES / 2);
            memset(rowBuffer + ROW_SAMPLES / 2, NTSCSyncPorch, ROW_SAMPLES / 2);
        }

    } else if((lineNumber >= 272) && (lineNumber <= 281)) { // XXX half line at 282

        /*
         * Rows 272 through 2XX are other part of vertical blank
         */

        // XXX should just change DMA source address, then this needs to be in SRAM2
        memcpy(rowBuffer, NTSCBlankLine, sizeof(NTSCBlankLine));

    } else {

        // Don't need to do these because did both buffers at some point during vertical blank?
        memcpy(rowBuffer, NTSCBlankLine, NTSCHSyncClocks + NTSCBackPorchClocks);
        memcpy(rowBuffer + ROW_SAMPLES - NTSCFrontPorchClocks, NTSCBlankLine + ROW_SAMPLES - NTSCFrontPorchClocks, NTSCFrontPorchClocks);

        // 244 lines
        // 189 columns @ 4 per pixel
        int y = lineNumber - (NTSC_EQPULSE_LINES + NTSC_VSYNC_LINES + NTSC_EQPULSE_LINES + NTSC_VBLANK_LINES);

        switch(NTSCMode) {
            case NTSC_COLOR_TEST: {
                if((y > 20 && y < 230) || (y > 283 && y < 493)) {
                    
                    // Clear pixels outside of text area 
                    memset(rowBuffer + NTSCHSyncClocks + NTSCBackPorchClocks, NTSCBlack, 80);
                    int clocksToRightEdge = 169 * 4;
                    memset(rowBuffer + clocksToRightEdge, NTSCBlack, ROW_SAMPLES - clocksToRightEdge - NTSCFrontPorchClocks);

                    unsigned char *rowOut = rowBuffer + (NTSCHSyncClocks + NTSCBackPorchClocks + 3) / 4 * 4 + 20 * 4;
                    uint32_t* rowWords = (uint32_t*)rowOut;
                    unsigned char v = NTSCBlack + (NTSCWhite - NTSCBlack) / 2;
                    unsigned char a = NTSCWhite;
                    unsigned char c = NTSCBlack;
                    uint32_t colorWord = (v << 0) | (v << 8) | (v << 16) | (v << 24); // little endian
                    for(int col = 20; col < 50; col++) {
                        *rowWords++ = colorWord;
                    }
                    colorWord = (v << 0) | (a << 8) | (v << 16) | (c << 24); // little endian
                    for(int col = 50; col < 169; col++) {
                        *rowWords++ = colorWord;
                    }
                }
                break;
            }
            case NTSC_SOLID_FILL: {
                if((y % 263) > 20 && (y % 263) < 230) {
                    unsigned char *rowOut = rowBuffer + (NTSCHSyncClocks + NTSCBackPorchClocks + 3) / 4 * 4 + 20 * 4;
                    uint32_t* rowWords = (uint32_t*)rowOut;
                    for(int col = 20; col < 169; col++) {
                        *rowWords++ = solidFillWave;
                    }
                }
                break;
            }
            case NTSC_SCAN_TEST: {
                if((lineNumber % 263) >= videoScanTestTop && (lineNumber % 263) <= videoScanTestBottom) {
                    for(int row = videoScanTestLeft; row < videoScanTestRight; row++) {
                        rowBuffer[row] = 200;
                    }
                }
                break;
            }
            case NTSC_DISPLAY_BLACK: {
                memcpy(rowBuffer, NTSCBlankLine, ROW_SAMPLES);
                break;
            }
            case NTSC_USE_VIDEO_MODE: {
                VideoCurrentFillRow(frameNumber, lineNumber, rowBuffer);
                break;
            }
        }
        if(lineNumber == 262) {
            //line 262 - overwrite last 405 samples with first 405 samples of EQ pulse
            memcpy(rowBuffer + ROW_SAMPLES / 2, NTSCEqSyncPulseLine, ROW_SAMPLES / 2);
        } else if(lineNumber == 282) {
            //special line 282 - write SyncPorch from BackPorch to middle of line after mode's fillRow()
            memset(rowBuffer + NTSCHSyncClocks + NTSCBackPorchClocks, NTSCSyncPorch, ROW_SAMPLES / 2 - (NTSCHSyncClocks + NTSCBackPorchClocks));
        }
    }
    // if(lineNumber == 0) { rowBuffer[0] = 255;}
}

// debug overlay scanout

int SECTION_CCMRAM debugOverlayEnabled = 0;

#define debugDisplayWidth 19
#define debugDisplayHeight 13
#define debugDisplayLeftTick (NTSCHSyncClocks + NTSCBackPorchClocks + 48)
#define debugDisplayTopTick (NTSC_EQPULSE_LINES + NTSC_VSYNC_LINES + NTSC_EQPULSE_LINES + NTSC_VBLANK_LINES + 20)
/* debugFontWidthScale != 4 looks terrible in a color field because of adjacent color columns; probably need to ensure 0s around any 1 text column */
#define debugFontWidthScale 4
#define debugCharGapPixels 1
#define debugFontHeightScale 1

char SECTION_CCMRAM debugDisplay[debugDisplayHeight][debugDisplayWidth];

#include "8x16.h"
// static int font8x16Width = 8, font8x16Height = 16;
// static unsigned char font8x16Bits[] = /* was a bracket here */

void fillRowDebugOverlay(int frameNumber, int lineNumber, unsigned char* nextRowBuffer)
{
    uint32_t NTSCWhiteLong =
        (NTSCWhite <<  0) |
        (NTSCWhite <<  8) |
        (NTSCWhite << 16) |
        (NTSCWhite << 24);
    int debugFontScanlineHeight = font8x16Height * debugFontHeightScale;

    int rowWithinDebugArea = (lineNumber % 263) - debugDisplayTopTick;
    int charRow = rowWithinDebugArea / debugFontScanlineHeight;
    int charPixelY = (rowWithinDebugArea % debugFontScanlineHeight) / debugFontHeightScale;

// XXX this code assumes font width <= 8 and each row padded out to a byte
    if((rowWithinDebugArea >= 0) && (charRow < debugDisplayHeight)) {
        for(int charCol = 0; charCol < debugDisplayWidth; charCol++) {
            unsigned char debugChar = debugDisplay[charRow][charCol];
            if(debugChar != 0) {
                unsigned char charRowBits = font8x16Bits[debugChar * font8x16Height + charPixelY];
#if debugFontWidthScale == 4 && font8x16Width == 8
                unsigned char *charPixels = nextRowBuffer + debugDisplayLeftTick + (charCol * (font8x16Width + debugCharGapPixels)) * debugFontWidthScale;
                if(charRowBits & 0x80) { ((uint32_t*)charPixels)[0] = NTSCWhiteLong; } 
                if(charRowBits & 0x40) { ((uint32_t*)charPixels)[1] = NTSCWhiteLong; }
                if(charRowBits & 0x20) { ((uint32_t*)charPixels)[2] = NTSCWhiteLong; }
                if(charRowBits & 0x10) { ((uint32_t*)charPixels)[3] = NTSCWhiteLong; }
                if(charRowBits & 0x08) { ((uint32_t*)charPixels)[4] = NTSCWhiteLong; }
                if(charRowBits & 0x04) { ((uint32_t*)charPixels)[5] = NTSCWhiteLong; }
                if(charRowBits & 0x02) { ((uint32_t*)charPixels)[6] = NTSCWhiteLong; }
                if(charRowBits & 0x01) { ((uint32_t*)charPixels)[7] = NTSCWhiteLong; }
#else
                for(int charPixelX = 0; charPixelX < font8x16Width; charPixelX++) {
                    int pixel = charRowBits & (0x80 >> charPixelX);
                    if(pixel) {
                        unsigned char *charPixels = nextRowBuffer + debugDisplayLeftTick + (charCol * (font8x16Width + debugCharGapPixels) + charPixelX) * debugFontWidthScale;
#if debugFontWidthScale == 4
                        *(uint32_t *)charPixels = NTSCWhiteLong; 
#else
                        for(int col = 0; col < debugFontWidthScale; col++) {
                            charPixels[col] = NTSCWhite;
                        }
#endif
                    }
                }
#endif
            }
        }
    }
}

volatile int SECTION_CCMRAM lineNumber = 0;
volatile int SECTION_CCMRAM frameNumber = 0;

void MemoryCopyDMA(unsigned char* dst, unsigned char* src, size_t size)
{
    // XXX wait on previous DMA
    // Configure DMA to copy tmp row
    DMA2_Stream1->CR &= ~DMA_SxCR_EN;       /* disable DMA2_1 */
    DMA2->LIFCR = 0xF00;                        /* clear flags */
    DMA2_Stream1->NDTR = size / 4;
    DMA2_Stream1->PAR = (uint32_t)src;        // Source buffer address 0 in Memory-to-Memory mode
    DMA2_Stream1->M0AR = (uint32_t)dst;        // Dest buffer address in Memory-to-Memory mode
    DMA2_Stream1->FCR = DMA_FIFOMODE_ENABLE |   // Enable FIFO to improve stutter
        DMA_FIFO_THRESHOLD_FULL;        
    DMA2_Stream1->CR =
        DMA_CHANNEL_1 |                         
        DMA_MEMORY_TO_MEMORY |                  // Memory to Memory
        DMA_PDATAALIGN_WORD | // DMA_PBURST_INC4 |
        DMA_MDATAALIGN_WORD | // DMA_MBURST_INC4 |
        DMA_PRIORITY_LOW |
        DMA_PINC_ENABLE |                       // Increment memory address
        DMA_MINC_ENABLE |                       // Increment memory address
        0;
    DMA2_Stream1->CR |= DMA_SxCR_EN;    /* enable DMA */
} 

// XXX audio experiment
// In this mode we would have a sampling rate of 15.6998 KHz
unsigned char SECTION_CCMRAM audioBuffer[256];
volatile int audioBufferPosition = 0;

int doPlay(int argc, char **argv)
{
    int bufferHalfSize = sizeof(audioBuffer) / 2;

    char *filename = argv[1];
    FIL file;
    FRESULT result = f_open (&file, filename, FA_READ | FA_OPEN_EXISTING);
    if(result) {
        logprintf(DEBUG_ERRORS, "ERROR: couldn't open \"%s\" for reading, FatFS result %d\n", filename, result);
        return 1;
    }

    int where = 0;

    UINT wasread;
    do {
        // Wait for audio to get past the buffer we read
        while((audioBufferPosition - where + sizeof(audioBuffer)) % sizeof(audioBuffer) < bufferHalfSize);
        result = f_read(&file, audioBuffer + where, bufferHalfSize, &wasread);
        if(result) {
            logprintf(DEBUG_ERRORS, "ERROR: couldn't read block of audio from \"%s\", result %d\n", filename, result);
            memset(audioBuffer, 128, sizeof(audioBuffer));
            return COMMAND_FAILED;
        }
        where = (where + bufferHalfSize) % sizeof(audioBuffer);
        LED_beat_heart();
    } while(wasread == bufferHalfSize);

    f_close(&file);

    while((audioBufferPosition - where + sizeof(audioBuffer)) % sizeof(audioBuffer) < bufferHalfSize);
    memset(audioBuffer, 128, sizeof(audioBuffer));

    return COMMAND_CONTINUE;
}

static void RegisterCommandPlay(void) __attribute__((constructor));
static void RegisterCommandPlay(void)
{
    RegisterApp("play", 2, doPlay, "filename",
        "play 15.7KHz u8 mono audio stream"
        );
}

void DMA2_Stream2_IRQHandler(void)
{
    // Configure timer TIM2 for performance measurement
    TIM9->CNT = 0;
    TIM9->CR1 = TIM_CR1_CEN;            /* enable the timer */

    // Clear interrupt flag
    DMA2->LIFCR |= DMA_LIFCR_CTCIF2;
    // DMA2->LIFCR |= DMA_LIFCR_CHTIF2;

    if(markHandlerInSamples) {
        for(int i = 0; i < 28; i++) { GPIOC->ODR = (GPIOC->ODR & 0xFFFFFF00) | 0xFFFFFFF8; }
    } else {
        // Do a little loop here since FIFO may have starved a little on interrupt
        // And hope we're early enough in the line that values aren't changing
        //uint32_t GPIOJ_ODR = GPIOJ->ODR;
        //for(int i = 0; i < 15; i++) { GPIOJ->ODR = GPIOJ_ODR; }
    }

    if(DMA2->LISR & DMA_FLAG_FEIF2_6) {
        DMA2->LIFCR |= DMA_LIFCR_CFEIF2;
        DMAFIFOUnderruns++;
    }
    if(DMA2->LISR & DMA_FLAG_TEIF2_6) {
        DMA2->LIFCR |= DMA_LIFCR_CTEIF2;
        DMATransferErrors++;
    }

    // XXX audio experiment
    DAC1->DHR8R1 = audioBuffer[audioBufferPosition];
    audioBufferPosition = (audioBufferPosition + 1) % sizeof(audioBuffer);

    int whichIsScanning = (DMA2_Stream2->CR & DMA_SxCR_CT) ? 1 : 0;

    unsigned char *nextRowBuffer = (whichIsScanning == 1) ? row0 : row1;

    NTSCFillRowBuffer(frameNumber, lineNumber, nextRowBuffer);
    if(debugOverlayEnabled) {
        fillRowDebugOverlay(frameNumber, lineNumber, nextRowBuffer);
    }

    int thisLineNumber = lineNumber;
    lineNumber = lineNumber + 1;
    if(lineNumber == NTSC_FRAME_LINES) {
        lineNumber = 0;
        frameNumber++;
    }

    // A little pulse so we know where we are on the line when we finished
    if(markHandlerInSamples) {
        for(int i = 0; i < 28; i++) { GPIOC->ODR = (GPIOC->ODR & 0xFFFFFF00) | 0xFFFFFFE8; }
    }

    if(0) {
        int withinVisiblePartOfEvenFrame = (lineNumber > 27) && (lineNumber < 257);
        int withinVisiblePartOfOddFrame = (lineNumber > (262 + 27)) && (lineNumber < (262 + 257));

        if(withinVisiblePartOfEvenFrame || withinVisiblePartOfOddFrame) {
            while(DMA2_Stream1->NDTR > 100);
        }
    }

#if 1
    TIM9->CR1 = 0;            /* stop the timer */
    // rowCyclesSpent[lineNumber] = TIM9->CNT;     // TIM9 CK_INT is RCC on 415xxx, APB1 on 746xxx
    rowDMARemained[thisLineNumber] = 912 - TIM9->CNT / 7;
#else
    rowDMARemained[thisLineNumber] = *(uint16_t*)&DMA2_Stream1->NDTR;
#endif
}

void DMAStartScanout(uint32_t dmaCount)
{
    // Configure DAC
    GPIO_InitTypeDef  GPIO_InitStruct = {0};
    GPIO_InitStruct.Pull = GPIO_NOPULL;
    GPIO_InitStruct.Pin = 0xFF;
    GPIO_InitStruct.Mode = GPIO_MODE_OUTPUT_PP;
    GPIO_InitStruct.Speed = GPIO_SPEED_FREQ_VERY_HIGH;
    HAL_GPIO_Init(GPIOC, &GPIO_InitStruct); 

    // Enable DMA interrupt handler
    HAL_NVIC_SetPriority(DMA2_Stream2_IRQn, 0, 1);
    HAL_NVIC_EnableIRQ(DMA2_Stream2_IRQn);

    // Configure DMA
    DMA2_Stream2->NDTR = ROW_SAMPLES;
    DMA2_Stream2->M0AR = (uint32_t)row0;        // Source buffer address 0
    DMA2_Stream2->M1AR = (uint32_t)row1;        // Source buffer address 1 
    DMA2_Stream2->PAR = (uint32_t)&GPIOC->ODR;  // Destination address
    DMA2_Stream2->FCR = DMA_FIFOMODE_ENABLE |   // Enable FIFO to improve stutter
        DMA_FIFO_THRESHOLD_FULL;        
    DMA2_Stream2->CR =
        DMA_CHANNEL_6 |                         // which channel is driven by which timer to which peripheral is limited
        DMA_MEMORY_TO_PERIPH |                  // Memory to Peripheral
        DMA_PDATAALIGN_BYTE |                   // BYTES to peripheral
        DMA_MDATAALIGN_WORD | DMA_MBURST_INC4 |
        DMA_SxCR_DBM |                          // double buffer
        DMA_PRIORITY_VERY_HIGH |                // Video data must be highest priority, can't stutter
        DMA_MINC_ENABLE |                       // Increment memory address
        DMA_IT_TC |                             // Interrupt on transfer complete of each buffer
        // DMA_IT_HT |                             // Interrupt on transfer complete of each buffer 
        0;

    // Configure TIM1_CH2 to drive DMA
    TIM1->CCR2 = (dmaCount + 1) / 2;         /* 50% duty cycle, although I've tried 1 and dmacount-1 and nothing seems to change.  Is this used? */ 
    TIM1->CCER |= TIM_CCER_CC2E;        /* enable capture/compare CH2 */
    TIM1->DIER |= TIM_DIER_CC2DE;       /* enable capture/compare updates DMA */

    // Configure timer TIM1
    TIM1->SR = 0;                       /* reset status */
    TIM1->ARR = dmaCount - 1;           /* load the register with this */

    lineNumber = 1; // Next up is row 1
    frameNumber = 0; 

    // Clear FIFO and transfer error flags
    DMA2->LIFCR |= DMA_LIFCR_CFEIF2;
    DMA2->LIFCR |= DMA_LIFCR_CTEIF2;

    DMA2_Stream2->CR |= DMA_SxCR_EN;    /* enable DMA */
    TIM1->CR1 = TIM_CR1_CEN;            /* enable the timer */
}

void DMAStopScanout()
{
    DMA2_Stream2->CR &= ~DMA_SxCR_EN;       /* disable DMA */
    TIM1->CR1 &= ~TIM_CR1_CEN;            /* disable the timer */
}

//----------------------------------------------------------------------------
// Video modes 

#define font8x8Width 8
#define font8x8Height 8
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
