bradgrantham/rocinante/software/Core/Inc/main.h

#define USER2_Pin GPIO_PIN_3
#define USER2_GPIO_Port GPIOE
#define USER3_Pin GPIO_PIN_4
#define USER3_GPIO_Port GPIOE
#define DEBUG_LED_Pin GPIO_PIN_5
#define DEBUG_LED_GPIO_Port GPIOE
#define RGBLED_SPI_Pin GPIO_PIN_6
#define RGBLED_SPI_GPIO_Port GPIOE
#define SDIO_CD_Pin GPIO_PIN_2
#define SDIO_CD_GPIO_Port GPIOG
#define ESP_RESET_Pin GPIO_PIN_6
#define ESP_RESET_GPIO_Port GPIOG
#define ESP_EN_Pin GPIO_PIN_7
#define ESP_EN_GPIO_Port GPIOG
#define USER1_Pin GPIO_PIN_2
#define USER1_GPIO_Port GPIOE
