bradgrantham/rocinante/firmware/copter.spin

826
0.342055 0.011165 1.00352 1 0 0
0.342055 -0.021245 0.95802 1 0 0
0.342055 -0.020195 0.38787 1 0 0
0.342055 -0.001505 0.35343 1 0 0
0.342055 0.213465 0.36064 1 0 0
0.342055 0.242865 0.37779 1 0 0
0.342055 0.238245 0.96523 1 0 0
0.342055 0.217105 1.00191 1 0 0
0.270585 0.224245 1.24404 0.871631 0.424679 0.244758
0.342055 0.217105 1.00191 0.871631 0.424679 0.244758
0.342055 0.238245 0.96523 0.871631 0.424679 0.244758
0.274505 0.309925 0.99673 0.871631 0.424679 0.244758
0.274505 0.309925 0.99673 0.728931 0.684566 0.00538386
0.342055 0.238245 0.96523 0.728931 0.684566 0.00538386
0.342055 0.242865 0.37779 0.728931 0.684566 0.00538386
0.284865 0.306495 0.36365 0.728931 0.684566 0.00538386
0.284865 0.306495 0.36365 0.612165 0.398426 -0.683016
0.342055 0.242865 0.37779 0.612165 0.398426 -0.683016
0.342055 0.213465 0.36064 0.612165 0.398426 -0.683016
0.286335 0.225505 0.27475 0.612165 0.398426 -0.683016
0.286335 0.225505 0.27475 0.839951 0.0181904 -0.542357
0.342055 0.213465 0.36064 0.839951 0.0181904 -0.542357
0.342055 -0.001505 0.35343 0.839951 0.0181904 -0.542357
0.286335 -0.021385 0.28126 0.839951 0.0181904 -0.542357
0.286335 -0.021385 0.28126 0.681551 -0.643166 -0.349035
0.342055 -0.001505 0.35343 0.681551 -0.643166 -0.349035
0.342055 -0.020195 0.38787 0.681551 -0.643166 -0.349035
0.284865 -0.101325 0.36435 0.681551 -0.643166 -0.349035
0.284865 -0.101325 0.36435 0.817483 -0.575951 -0.00106068
0.342055 -0.020195 0.38787 0.817483 -0.575951 -0.00106068
0.342055 -0.021245 0.95802 0.817483 -0.575951 -0.00106068
0.274505 -0.097055 0.99834 0.817483 -0.575951 -0.00106068
0.274505 -0.097055 0.99834 0.783383 -0.506241 0.360599
0.342055 -0.021245 0.95802 0.783383 -0.506241 0.360599
0.342055 0.011165 1.00352 0.783383 -0.506241 0.360599
0.270585 -0.017115 1.24383 0.783383 -0.506241 0.360599
0.261765 -0.424235 2.93664 0.911969 0.00133222 0.410256
0.261765 0.071575 2.93503 0.911969 0.00133222 0.410256
0.111265 -0.029995 3.26991 0.911969 0.00133222 0.410256
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
