bradgrantham/rocinante/firmware/footbones.spin

2986
3.14198 -1.55879 1.92967 -0.58266 -0.795622 -0.165809
3.18585 -1.5136 1.82923 -0.437046 -0.733282 -0.520853
3.26733 -1.55719 1.82223 -0.203384 -0.839879 -0.503227
3.21209 -1.6141 1.94871 -0.350322 -0.931223 -0.10049
3.35182 -1.58643 1.90772 -0.102487 -0.854709 -0.508889
3.31614 -1.6334 1.97707 -0.252492 -0.964856 -0.072807
3.51437 -1.66134 1.92905 -0.246077 -0.796466 -0.552347
3.47456 -1.70234 2.02018 -0.416267 -0.901452 -0.118771
3.47456 -1.70234 2.02018 0.505434 -0.851196 0.141426
3.51437 -1.66134 1.92905 0.791912 -0.581657 -0.185878
3.54125 -1.65971 2.03845 0.919286 -0.31856 0.231153
3.18585 -1.5136 1.82923 -0.03319 0.097673 -0.994665
3.30323 -1.44392 1.83216 -0.03319 0.097673 -0.994665
3.21436 -1.42365 1.83712 -0.03319 0.097673 -0.994665
3.26733 -1.55719 1.82223 -0.03319 0.097673 -0.994665
3.26733 -1.55719 1.82223 0.676733 -0.151298 -0.720515
3.37889 -1.50101 1.91521 0.433893 -0.058711 -0.89905
3.30323 -1.44392 1.83216 0.676733 -0.151298 -0.720515
3.35182 -1.58643 1.90772 0.433893 -0.058711 -0.89905
3.53383 -1.59993 1.93442 0.147915 0.039714 -0.988202
3.51437 -1.66134 1.92905 0.147915 0.039714 -0.988202
3.53383 -1.59993 1.93442 0.940532 0.326096 -0.095192
3.21436 -1.42365 1.83712 0.189485 0.916559 -0.352159
3.199 -1.37885 1.94544 0.093923 0.995185 0.028011
3.28389 -1.38752 1.96856 0.405119 0.906112 0.121818
3.30323 -1.44392 1.83216 0.471756 0.836422 -0.279007
3.36807 -1.46948 1.99144 0.58884 0.793047 0.156026
3.37889 -1.50101 1.91521 0.648708 0.743494 -0.162465
3.51389 -1.57825 2.03104 0.76329 0.625125 0.163114
3.22865 -1.44436 2.09509 0.268824 0.821018 0.503651
3.15513 -1.424 2.04591 -0.016651 0.914739 0.403703
3.3348 -1.50883 2.06149 0.46435 0.756675 0.460242
3.4865 -1.58004 2.12566 0.780061 0.356408 0.514275
3.15513 -1.424 2.04591 -0.534733 0.096687 0.839471
3.12661 -1.51395 2.0381 -0.534733 0.096687 0.839471
3.19273 -1.55764 2.08525 -0.534733 0.096687 0.839471
3.22865 -1.44436 2.09509 -0.534733 0.096687 0.839471
3.22865 -1.44436 2.09509 0.213471 -0.15157 0.96512
3.19273 -1.55764 2.08525 0.213471 -0.15157 0.96512
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
