bradgrantham/rocinante/firmware/teapot2.spin

2921
1.1834 0.88811 0.256425 -0.90286 -0.423402 -0.0746571
1.16522 0.93279 0.264304 -0.948603 -0.311659 -0.0549538
1.1612 0.93259 0.004174 -0.888467 -0.452231 0.0781868
1.14331 0.97661 0.015788 -0.933769 -0.34172 0.106318
1.09706 0.97469 -0.234623 -0.844652 -0.48733 0.221524
1.08 1.01797 -0.218754 -0.889126 -0.377254 0.259103
0.99466 1.01357 -0.455117 -0.772694 -0.5297 0.349804
0.97893 1.05608 -0.434885 -0.816133 -0.419185 0.397756
0.85769 1.04837 -0.652462 -0.675967 -0.575578 0.460194
0.84375 1.09016 -0.628169 -0.717661 -0.464286 0.519039
0.689847 1.07823 -0.821812 -0.558882 -0.618054 0.552864
0.678079 1.11943 -0.794168 -0.597257 -0.506267 0.622075
0.494807 1.1023 -0.958316 -0.425599 -0.648918 0.63069
0.485571 1.1431 -0.928437 -0.458489 -0.537178 0.707974
0.276261 1.11972 -1.05713 -0.278581 -0.65955 0.69813
0.269863 1.1604 -1.02654 -0.3042 -0.548418 0.778908
0.037896 1.12965 -1.11341 -0.117863 -0.640301 0.759027
0.034592 1.17054 -1.08406 -0.136268 -0.531029 0.836324
-0.2166 1.13122 -1.12231 0.0574852 -0.579223 0.813139
-0.2166 1.17274 -1.09652 0.0430085 -0.475942 0.878425
1.15281 0.97747 0.272182 -0.978095 -0.204995 -0.036146
1.13109 1.02083 0.026266 -0.96297 -0.235816 0.130693
1.06835 1.06166 -0.205256 -0.917748 -0.271485 0.289888
0.96819 1.09921 -0.418258 -0.844031 -0.312822 0.435608
0.83422 1.13278 -0.608616 -0.744454 -0.356948 0.564248
0.670041 1.16162 -0.772207 -0.622116 -0.398073 0.674173
0.479263 1.18502 -0.90491 -0.480276 -0.428618 0.765259
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
-0.066366 -1.54233 0.234481 0.00473422 -0.986959 -0.1609
-0.139024 -1.54572 0.253736 0.00240606 -0.987071 -0.160262
-0.2166 -1.5469 0.2604 -2.6794e-10 -0.98711 -0.160044
0.547392 -1.4653 -0.158543 0.0333495 -0.98426 -0.173551
0.535277 -1.48941 -0.021772 0.0328127 -0.985271 -0.167824
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
