bradgrantham/rocinante/(commit log)

2020-04-04 Add DAC streaming test and pare down firmware
    delete files relevant to Alice 3
    enable GPIOC and stream data to it
    temporarily reduce heap size to fit enormous monolithic framebuffer
2020-04-05 double-buffered DMA at 14MHz
    And update the Cube SDK
    [timer_config_hal_example.txt]
2020-04-05 interrupt on each row
2020-04-05 Enable FIFO and time row fill routine
    "rowcycles" CLI prints number of cycles spent in filling first field's rows
2020-04-06 tune clock so DMA matches NTSC colorburst frequency
    fix text scrolling
    add backspace to text processing
    make sure there is a front porch
    [ioboard.c]
2020-04-07 checkpoint - color works, but phase drifts
    change ioboard.c to main.c
    upgrade FatFS to 0.14
    add lots of cofigurations of PLL parameters
    re-enable SD card and add "ls" command
    add new commands testmin, testmax
    [clocks.py, diskio.c, ffconf.h, main.c]
2020-04-07 configure SPI based on SystemCoreClock (AHB1)
    Also save a bunch of tried and failed clocks
    [main.c, sd_spi.c]
2020-04-08 lots more attempted modes, add debugger overlay
    [clocks.csv, videoformats.csv]
2020-04-09 shrink candidate mode list, fix whichConfig bug
    [main.c]
2020-04-09 expand clock range, reduce error range
    [clocks.py]
2020-04-10 checkpoint color stability experiments
    [keyboard.c, main.c, uart.c]
2020-04-11 redo all color math, set voltages from scope, add "show"
2020-04-11 add stats mode, drop back to 200MHz, press button to inspect
2020-04-12 restructure CLI as table, move VTOR, add per-row palette
    make DMA IRQ highest-priority (no improvement)
    make DMA transfers use BURST of 4 WORDs (some improvement)
2020-04-13 set rows officially to 912 samples
2020-04-14 add disabled code to write to a tmp row and them DMA to SRAM2
2020-04-14 add discoverable video modes, fix ccmram initialization
    [main.c]
2020-04-15 fix ordering of NTSC parameters
    [main.c]
2020-04-15 add show app, hires mode, add application framework
    add apps, add aspect ratio, fix and optimize maxres
    add app to show images
    [graphics.c, graphics.h, main.c, rocinante.h, videomode.h, videomodeinternal.h]
2020-04-17 bug fixes, use HTIE instead of TCIE
    [main.c]
2020-04-19 fix wolf hang and color fringe by calling right setup
    [main.c, videomode.h]
2020-04-22 Fix wolf texture coordinates and pixmap video modes
    Set up default palettes in pixmap video modes
    Use center-sampled texture coordinates in Wolfenstein renderer
    Make modes better specified with #defines
    Error out if modes take up more imgBuffer than has been reserved
    don't dither and scale to box
    don't quantize or dither, let the app do that
    scale to 800x480
    use tail to strip PPM header
    some things back into CCM, make showimage better
    Add __cplusplus__ guards around headers
    add field of view
    possibly slightly optimize WolfensteinFillRow
    Add a C++ test by way of beginnings of BASIC interpreter
    use Arne's all-purpose 16-color palette
    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
    [5x7.h, 8x16.h, graphics.c, graphics.h, main.c, rocinante.h]
2020-04-24 enable interlace and do a bunch of cleanup
    make Wolfenstein renderer be interlaced
    Courtesy of https://godbolt.org/ I know the optimized code checked into scanline_optimization_experiments can do 55 instructions for 4 interpolated YIQ samples
    Whether that would hit 55 cycles is another question
    save notes about palette investigation
    add notes about reducing .data use
    clean up memory usage all over system - use malloc and free
    avoid global arrays; malloc when possible
    don't display ^G in the textport
    add a short list of needed docs in docs.md
    expand wrap-with-bow list slightly in notes
    clear outside of COLOR_TEST so debug doesn't smear
    [graphics.c, logprintf.c, main.c, textport.c, uart.c, videomodeinternal.h]
2020-04-25 clean up
    use normal getchar and setvbuf for single-key input
    add variables to Makefile for compiling and adding microray
    retire DAC issue in notes , add some more TODOs
    use TIM9 in DMA IRQ Handler, clean up slightly
    [main.c]
2020-04-27 hosted application driver; WIP
2020-04-28 add experiments on gaussian filtering
2020-04-28 add notes on filtering and threading
2020-04-28 implement MIPmapping in WOLF
    Using only dtdy, since I don't currently have dsdx, but that's an okay approximation.
    Separate out texture sources
2020-04-29 print some things about YIQ numerical ranges
2020-04-29 add initial support for STM32F746
2020-05-02 update to match TIM1 clock in STM324F746
2020-05-05 checkpoint 746 - I think the clocks are correct.
    [clocks.py, main.c, sd_spi.c]
2020-05-05 enable dcache; enable audio; enable FIFO threshold; fix row cycle counts
    [defs.h, main.c]
2020-05-13 fix circles; add VideoBufferReset
    [segment_utility.h]
2020-05-20 move main to C++, restructure VRAM, improve show and segment test
    output slightly more correct clocks but still wrong in clocks.py
    make colorburst waveform more closely match Apple 2 by increasing number and moving slightly earlier
    fix incorrect args parsing in showimage.c
    print the largest allocatable before each command prompt
    beef up .gitignores
    add BASIC programs I'd like to run
    add schematic design notes
    move main to C++
    make "imgBuffer" be "VRAM"
    put palettes at the end of VRAM and only require for modes that need palettes
    checkpoint notes
    use a union for segment type and add more segment types
    any key quits audio playback
    make wolf mode fullscreen
    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
    [rocinante1.kicad_pcb, rocinante1.sch]
2020-05-22 set ROW_SAMPLES to 910 and have correct line length
    [main.cpp, videomode.h]
2020-05-31 Improve hosted mode, make more files C++, add 3D model viewer
    Add note about origin of the name Rocinante
    Add a test for scanf float
    Add pocketgl from Jim's Maple project
    Add segmented mode, GLFW, threading to host
    Add segmented mode test to hosted mode
    Factor out command line processing
    Move a lot of C files to C++
    Add index_triangles.py script for turning triangles into vertices and a mesh
2020-08-16 checkpoint schematic
    [rocinante1.kicad_pcb, rocinante1.sch]
2020-08-16 STM32H745IGTx library for KiCad
2020-08-24 fix streamout using 14MHz; 216MHz main clock
    [main.cpp]
2020-08-30 add most of schematic for Rosa v1
    [rocinante1.sch]
2020-09-06 checkpoint PCB work; schematic getting pretty close
    [rocinante1.kicad_pcb, rocinante1.sch]
2020-09-06 add IOC file from STM32CubeMX
2020-09-08 finish schematic draft; place some parts
    [rocinante1.kicad_pcb, rocinante1.sch]
2020-09-13 Schematic done, THT PN chosen, working on routing
    [rocinante1.kicad_pcb, rocinante1.sch]
2020-09-13 add DAC line but commented, note current DAC max
2020-09-13 add more part symbols and footprints
2020-09-19 add first revision of PCB
    [rocinante1.kicad_pcb]
2020-09-21 add some necessary BOM fields
    [rocinante1.kicad_pcb, rocinante1.sch]
2020-09-22 make v1 PCB
    [rocinante1.kicad_pcb, rocinante1.sch]
2020-11-06 fix label placement
    [rocinante1.kicad_pcb]
2020-11-06 test USER buttons
2020-11-06 update to bringup of PCB
2020-11-07 checkpoint work on RGB LEDs; 3X SPI sort of working
2020-11-08 WS2812Bs demonstrated working
    Using blocking SPI transmit at the moment
    SPI4 uses PE2 and PE6, which means USER1 button isn't currently read.
    Demo
    RGB1 red on and off, cycling every second.
    RGB2 rotates through hue every pi*2 seconds
    RGB3 rises from off to white over one second and back to off over one second
2020-11-08 remove unneeded print, reduce reset buffer
    [main.c]
2020-11-08 use interrupts to transfer to SPI
2020-11-10 save failed PS/2 TIM experiments for reference
    [main.c]
2020-11-16 DMA is occurring at 14MHz
2020-11-17 remove STM32CubeMX's DMA IRQ handler
2020-11-17 fix cap at composite out
    [rocinante1.kicad_pcb, rocinante1.sch]
2020-11-17 add video test - subject is Millie the dog
2020-12-13 Move to 912 samples to be a multiple of colorburst
2020-12-13 clean up
    change sprintf(message) etc to printf
    turn on scanout mark
    optimize Woz HGR fillrow
    tell apple2 to go "-fast"
    some constexprs
    temporarily turn off audio fill
    delete some apparently unused code
    fix a couple warnings about int size
    attempt to do better with performance
    make 6502 cycle count map be in ROM with const, hopefully
    [main.c]
2020-12-13 initial notes; user buttons
2020-12-13 remove unused array, fix missing return value
    [main.c]
2020-12-13 Add events and keyboard processing and tests
    Also add NTSC func ptr switch function and "valid" flag
    Maybe fix the strange colors in HGR mode
    Add text and HGR mode tests
    [events.cpp, events_internal.h, main.c]
2020-12-13 keyboard fixes, interactive apple 2
    use key repeat manager
    launch apple2e emulator in interactive mode,
    don't prepopulate key buffer with program
    enable DMA for SPI4
    increase heap size in MX project to match hand-coded
    [main.c]
2020-12-13 move rosa.peripheral.test project to rocinante_rev1.ioc and software/
    [clocks.csv, timer_config_hal_example.txt, videoformats.csv]
2020-12-13 Fix some keyboard processing
    Fix keyboard release in apple2e
    Fix repeat processing idiom
    And clean up some warnings
    F12 is RESET in Apple2e
    LEFT Win (GUI) is left APPLE so Win-F12 is REBOOT
    [events.cpp, hid.cpp, main.c]
2020-12-14 use DMA for WS2812 SPI
2020-12-14 test audio; provide app LED interface
2020-12-15 add RoDebugOverlayPrintf, rename LEDSet, SDMMC divider 5
2020-12-20 Improve Apple //e emulation and debugging
    Add forgotten 8x16 font file
    Add forgotten Rocinante API header
    Add forgotten STM32CubeMX project
    Try to batch up serial transmission to be higher performance
    Fix Busy flag used for RGB LED protocol on SPI4
    Debug overlay disabled by default, enable if used
    Add a way to just set a debug overlay line directly
    Black out the 3 samples after a debug overlay character for readability
    Double up WozMode buffers to add abuility for Aux buffers
    Temporarily disable RGB LED write3LEDString - sometimes hangs
    Add "burn" target to Makefile (specific to my machine :-/ )
    Clean up many int types in Apple emulator and 6502 emulator
    Formalize bus access order in 6502 em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
    [8x16.h, main.c, rocinante.h, rocinante_rev1.ioc]
2020-12-28 Make apple2e audio work and floppy fast,
    Fix code to avoid warnings
    Shrink heap slightly to fit data
    Update to main apple2e emulator source at 43c3c8a
    Update to improved cpu6502 emulator source at 43c3c8a
    Fix apple2e emulator audio by plumbing realtime buffer size through
    Make some arrays "const" hoping they'll stay in ROM
    [main.c, rocinante.h]
2021-01-06 some disk files are DSK so remove file filter
2021-12-28 checkpoint SDRAM; some failure, some success
    [main.c, rocinante_rev1.ioc]
2021-12-29 tune VGA test better; fix PWM polarity
    [main.c]
2021-12-31 checkpoint moving VGA to DMA and interrupts
2022-01-01 add stable VGA - need to fix location
    [main.c, rocinante_rev1.ioc]
2022-01-01 fix location of VGA - still not quite right
    [main.c]
2022-02-08 improve debug print for joystick/keypad
2022-02-13 initial Coleco emulator port; too slow, but runs
    [main.c, rocinante.h, z80emu.cpp]
2022-02-14 fix playAudio by increasing audio buffer size
    [main.c]
2022-03-07 add some generated source files to track changes
2022-03-08 optimize TMS9918ModeFillRowBuffer, remove startup delay and print
2022-03-08 remove lazy updates of frame
2022-05-06 fix comment, make array static
    [main.c]
2022-05-07 remove delays in controller reads
    Add delay_us function
    Change leading delays in controller I/O from 1 ms to 10 us
    Remove trailing delays in controller I/O
    Improve NTSCWaitFrame function
    Remove no longer used TMS9918 registers+memory graphics mode
    Remove playback of VDP test vectors
    Print time spent between frames if > than 16ms and time waited before next VSYNC
    Add GCC back in to "pragma unroll"
    [main.c]
2022-05-07 change audio interface to a ring buffer
    Allow arbitrary writes into an audio ring buffer
    Coleco will work, Apple II and other modules won't
    [main.c, rocinante.h]
2022-05-19 add console button
    Make button event be generic and add "CONSOLE" button enumerants
2022-05-20 add console button processing to line ISR
2022-05-20 plumb console buttons through to queue
2022-05-20 make USER1 button reset the colecovision
2022-05-27 add button 2 quits
2022-10-18 cleanup
    remove buffer parameter from RoAudioGetSamplingInfo
    remove unused audio API
    change NTSCSwitchModeFuncs to NTSCSetModeFuncs
    add parameter for interlace to NTSCSetModeFuncs
    remove playAudio since it uses old audio API
    remove old hardcoded apple2e program inputs
    remove windowing API
    remove LED API
    remove RoProcessYield
2022-10-18 upgrade STM32CUBE version for programmer
2022-10-18 fix API race problem by combining functions
    [main.c]
2022-10-21 don't reset video mode if it's the same parameters
    [main.c]
2022-12-19 two halves of enclosure
    [rev1_case.scad]
2022-12-19 add lip for joining two halves
    [rev1_case.scad]
2022-12-19 add some connectors
    [rev1_case.scad]
2022-12-19 add remaining connectors
    [rev1_case.scad]
2022-12-20 add bosses
    [rev1_case.scad]
2022-12-21 add edits from 12/20 print
    [rev1_case.scad]
2023-01-02 update including LED recesses
    [rev1_case.scad]
2023-01-03 update including power vents, buttons, logo
    [rev1_case.scad]
2023-01-09 Improve enclosure
    - Enlarge jack opening
    - Remove LED pipe recess, assume acrylic rod
    - Increased button pressor insert shaft diameter to strengthen shaft
    - Increase rubber foot diameter
    - Disable rubber foot recess
    - Increase thickness of logo plate recess
    - Add logo plate definition
    - Change "logo plate" to "badge"
    - Increase thickness of top wall
    - Use rounded cube for the outer shell
    - Make upper shell wall 3mm thick
    [rev1_case.scad]
